AshwinVishwanath/C.A.S.P.E.R.-2/Matlab Code/plots/allan_adxl372.png

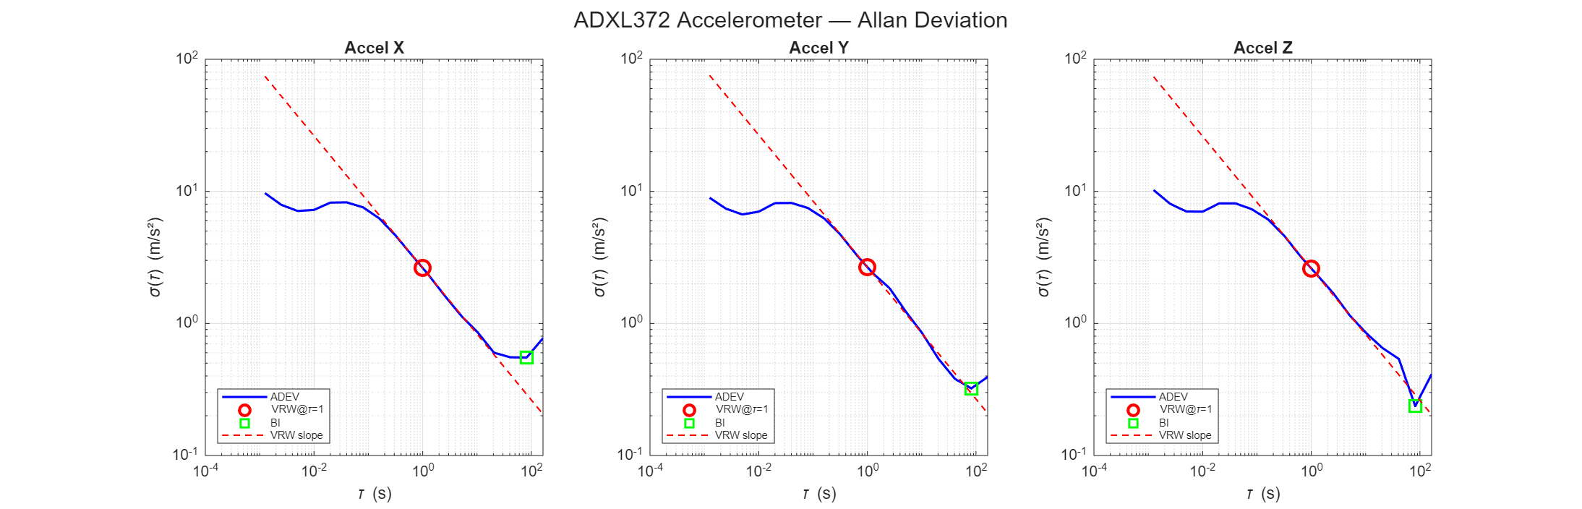
Matlab Code/plots/allan_adxl372.png
