AshwinVishwanath/C.A.S.P.E.R.-2/Matlab Code/plots/allan_lsm6_gyro.png

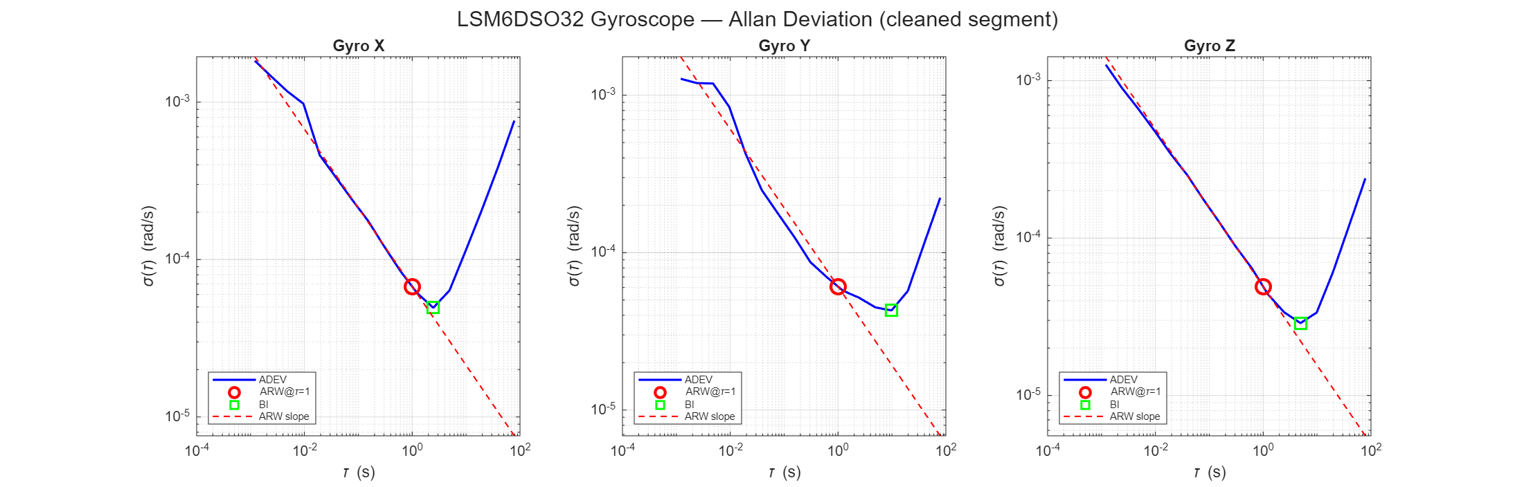
Matlab Code/plots/allan_lsm6_gyro.png
