AshwinVishwanath/C.A.S.P.E.R.-2/Matlab Code/plots/baro_allan_dev.png

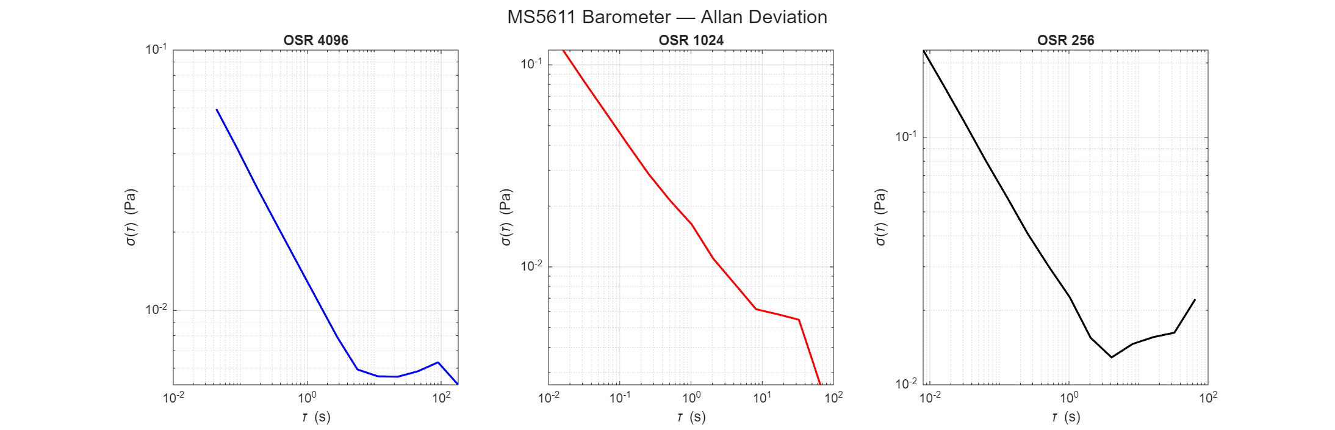
Matlab Code/plots/baro_allan_dev.png
