AshwinVishwanath/C.A.S.P.E.R.-2/Matlab Code/plots/baro_allan_overlay.png

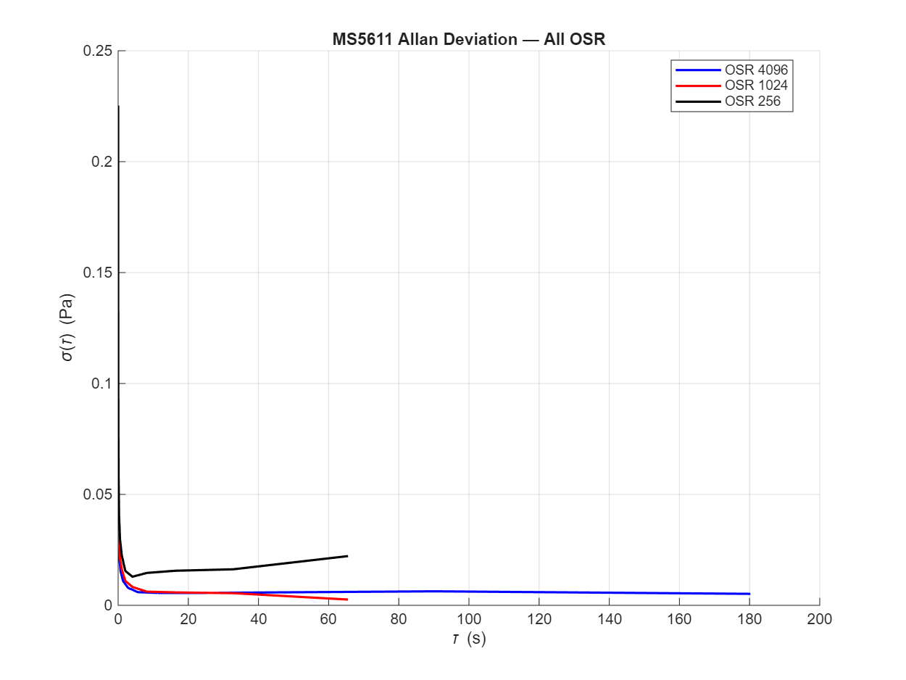
Matlab Code/plots/baro_allan_overlay.png
