AshwinVishwanath/C.A.S.P.E.R.-2/Matlab Code/plots/baro_psd.png

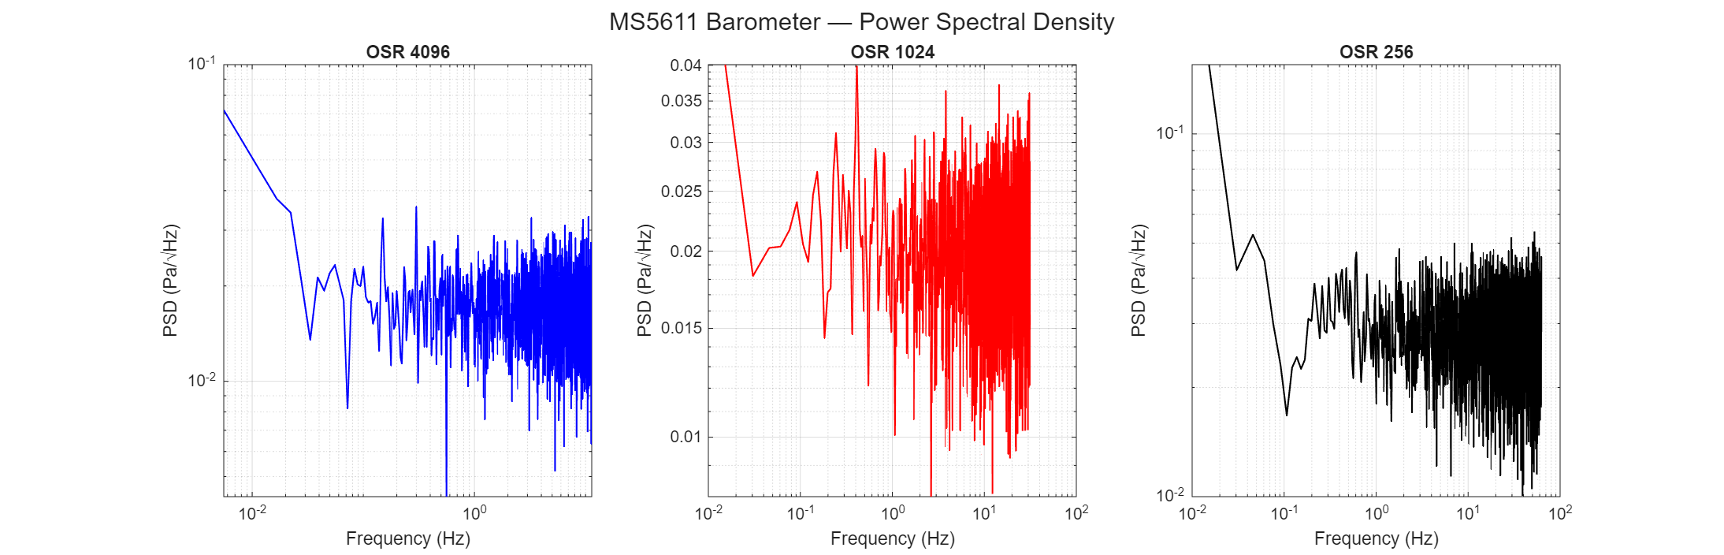
Matlab Code/plots/baro_psd.png
