AshwinVishwanath/C.A.S.P.E.R.-2/Matlab Code/plots/qc_noise_histograms.png

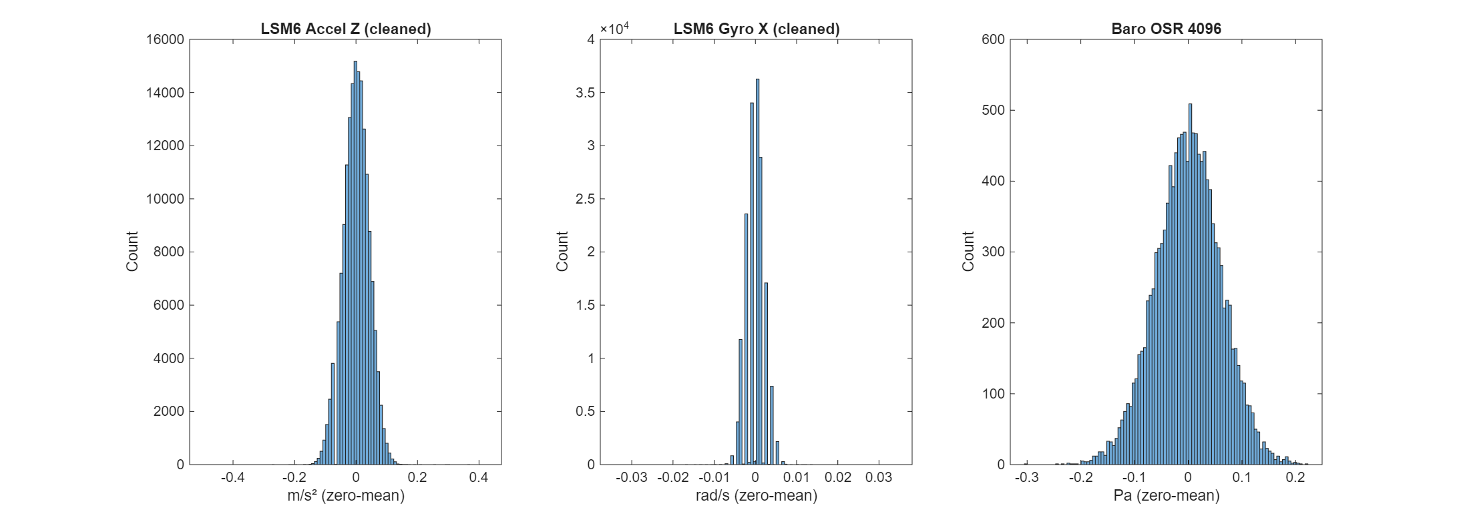
Matlab Code/plots/qc_noise_histograms.png
