AshwinVishwanath/C.A.S.P.E.R.-2/Matlab Code/plots/qc_raw_baro.png

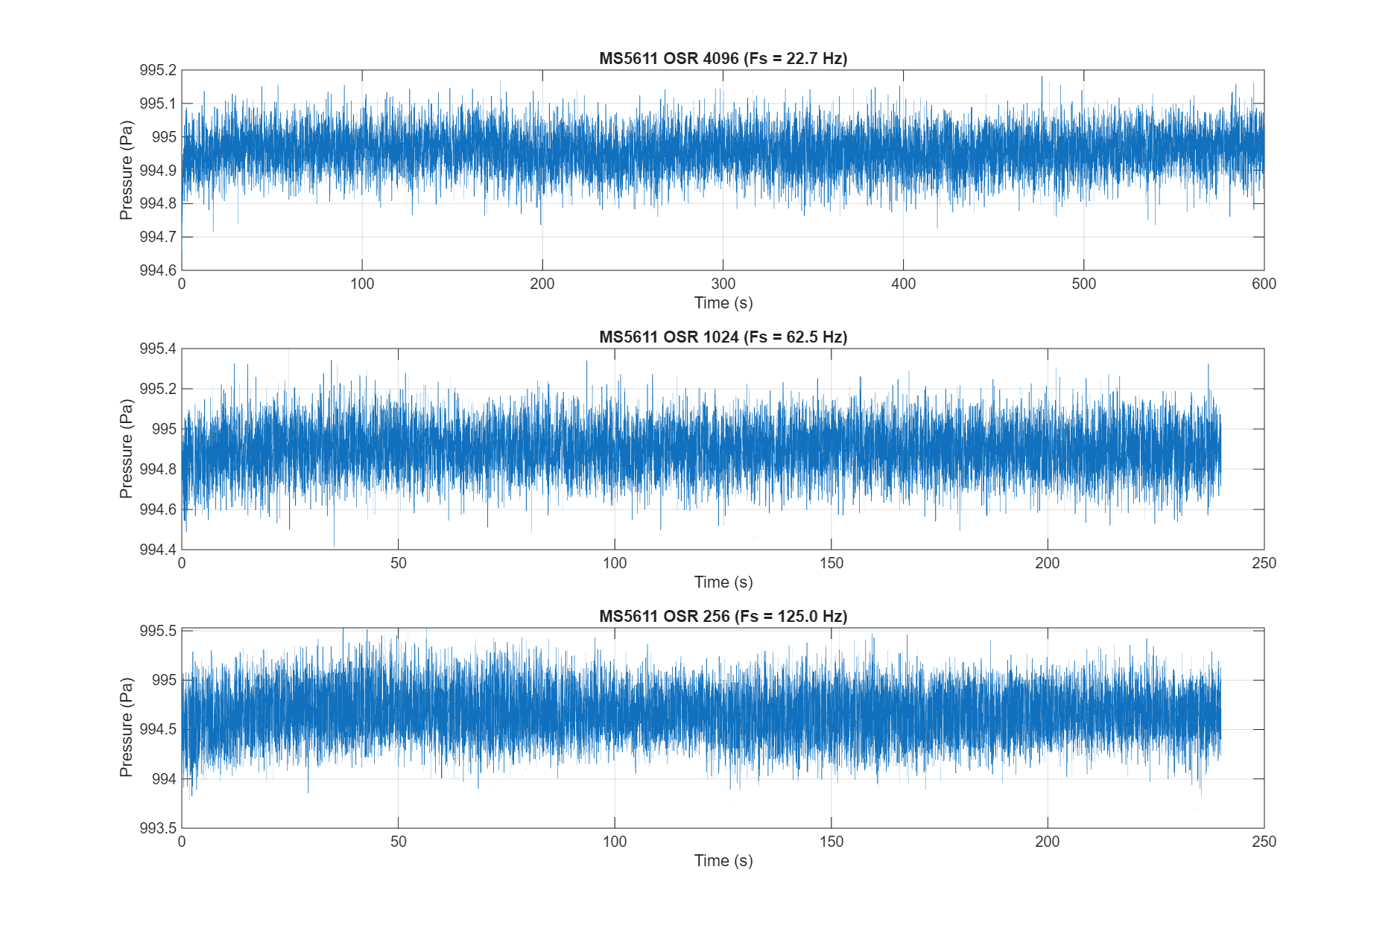
Matlab Code/plots/qc_raw_baro.png
