AshwinVishwanath/C.A.S.P.E.R.-2/Matlab Code/plots/qc_raw_imu.png

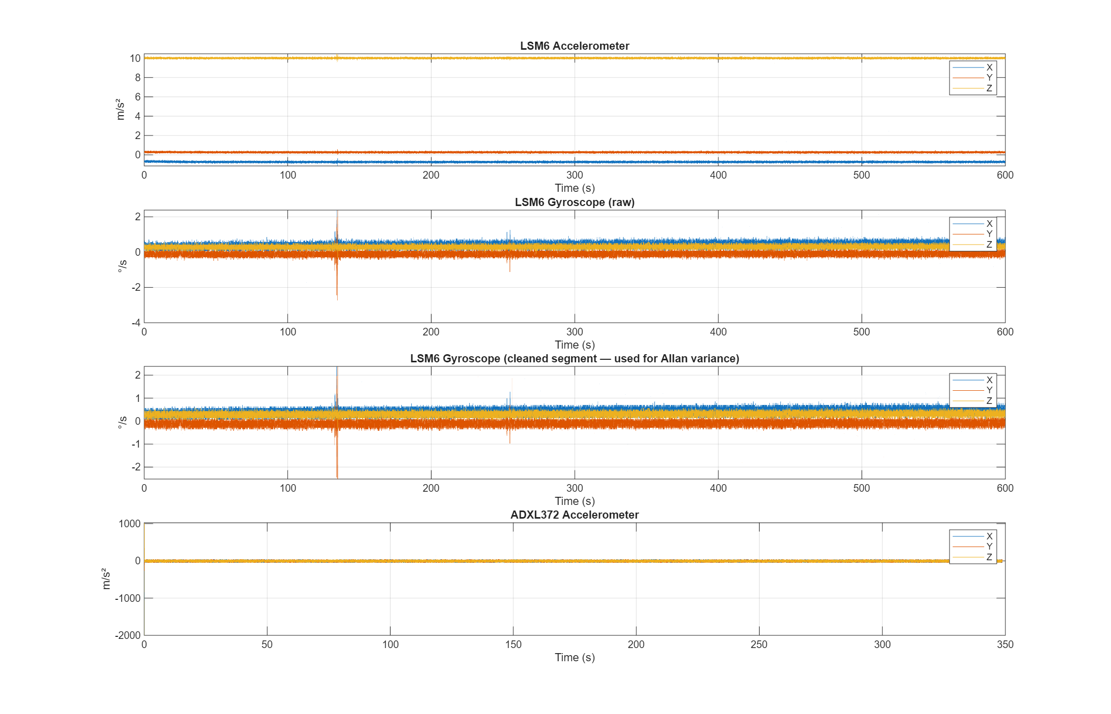
Matlab Code/plots/qc_raw_imu.png
