AshwinVishwanath/C.A.S.P.E.R.-2/Matlab Code/plots/qc_sample_timing.png

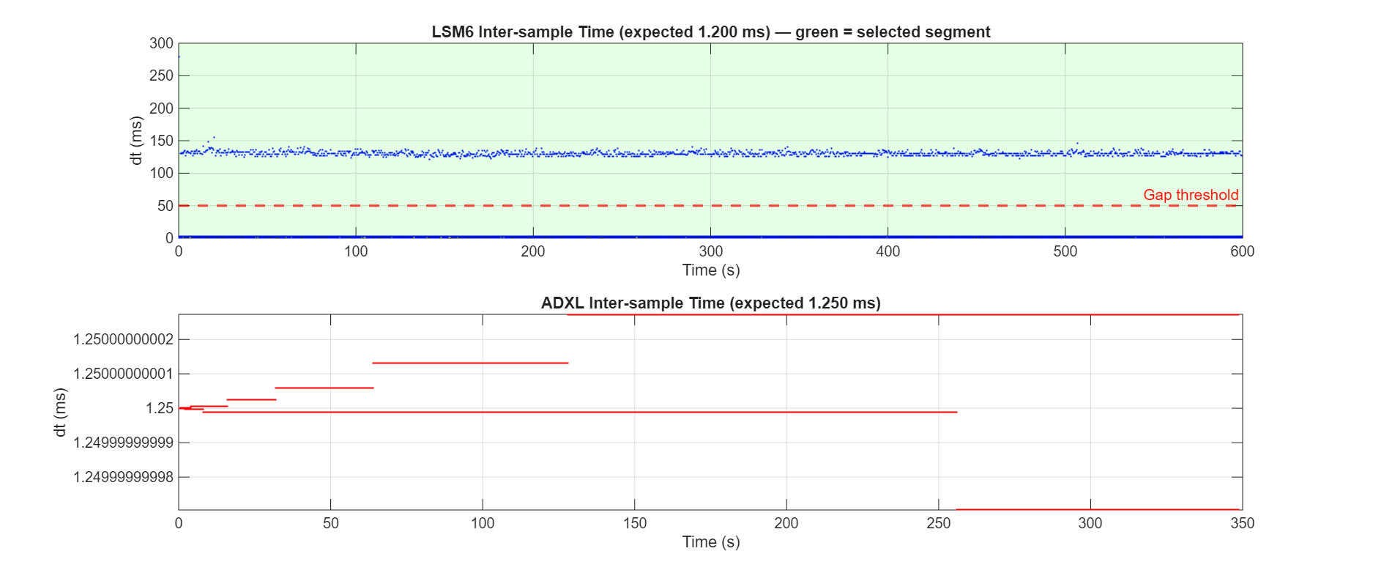
Matlab Code/plots/qc_sample_timing.png
