AshwinVishwanath/C.A.S.P.E.R.-2/Hardware/C.A.S.P.E.R. 2 Schematics.PDF

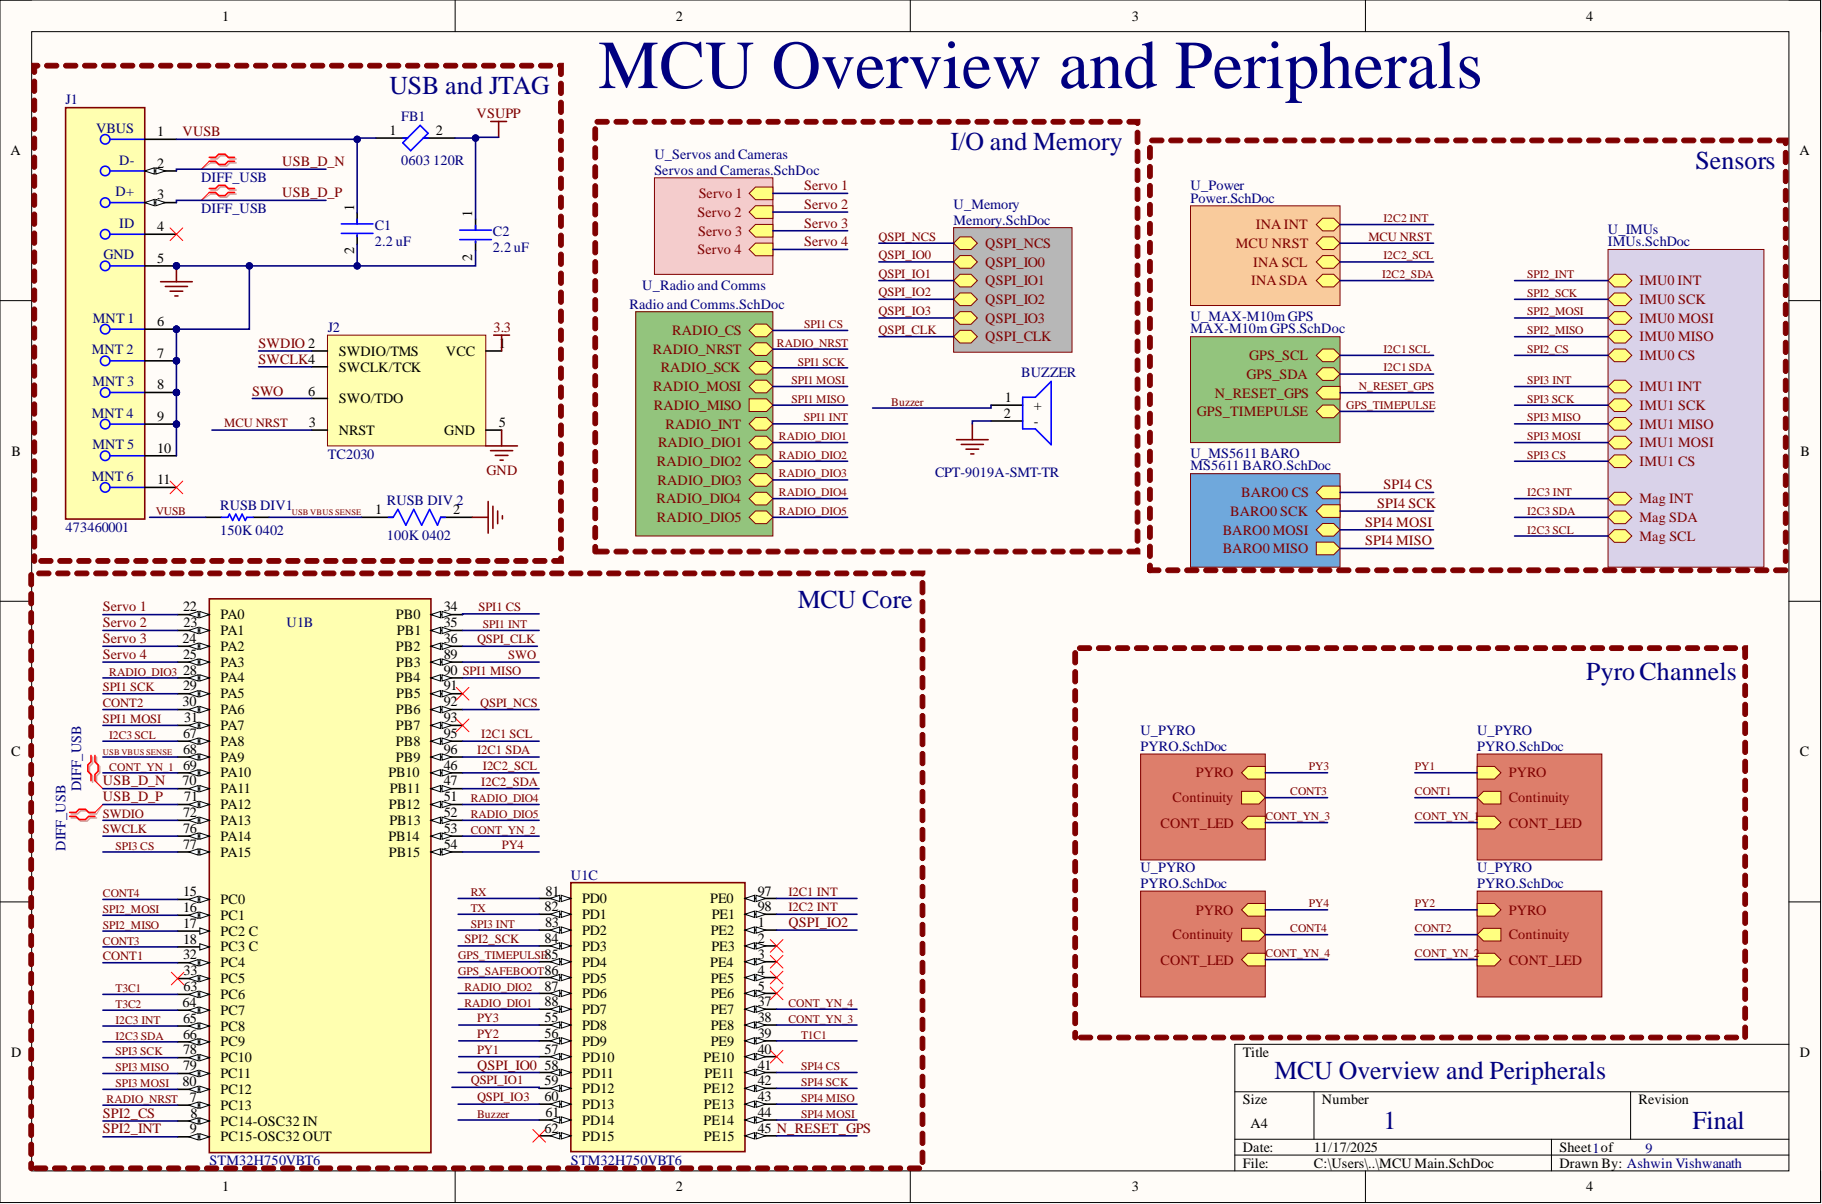
[picture p17: page 1]

MCU Overview and Peripherals

U_Servos and Cameras
Servos and Cameras.SchDoc

U_Radio and Comms
Radio and Comms.SchDoc

U_MAX-M10m GPS MAX-M10m GPS.SchDoc

Title

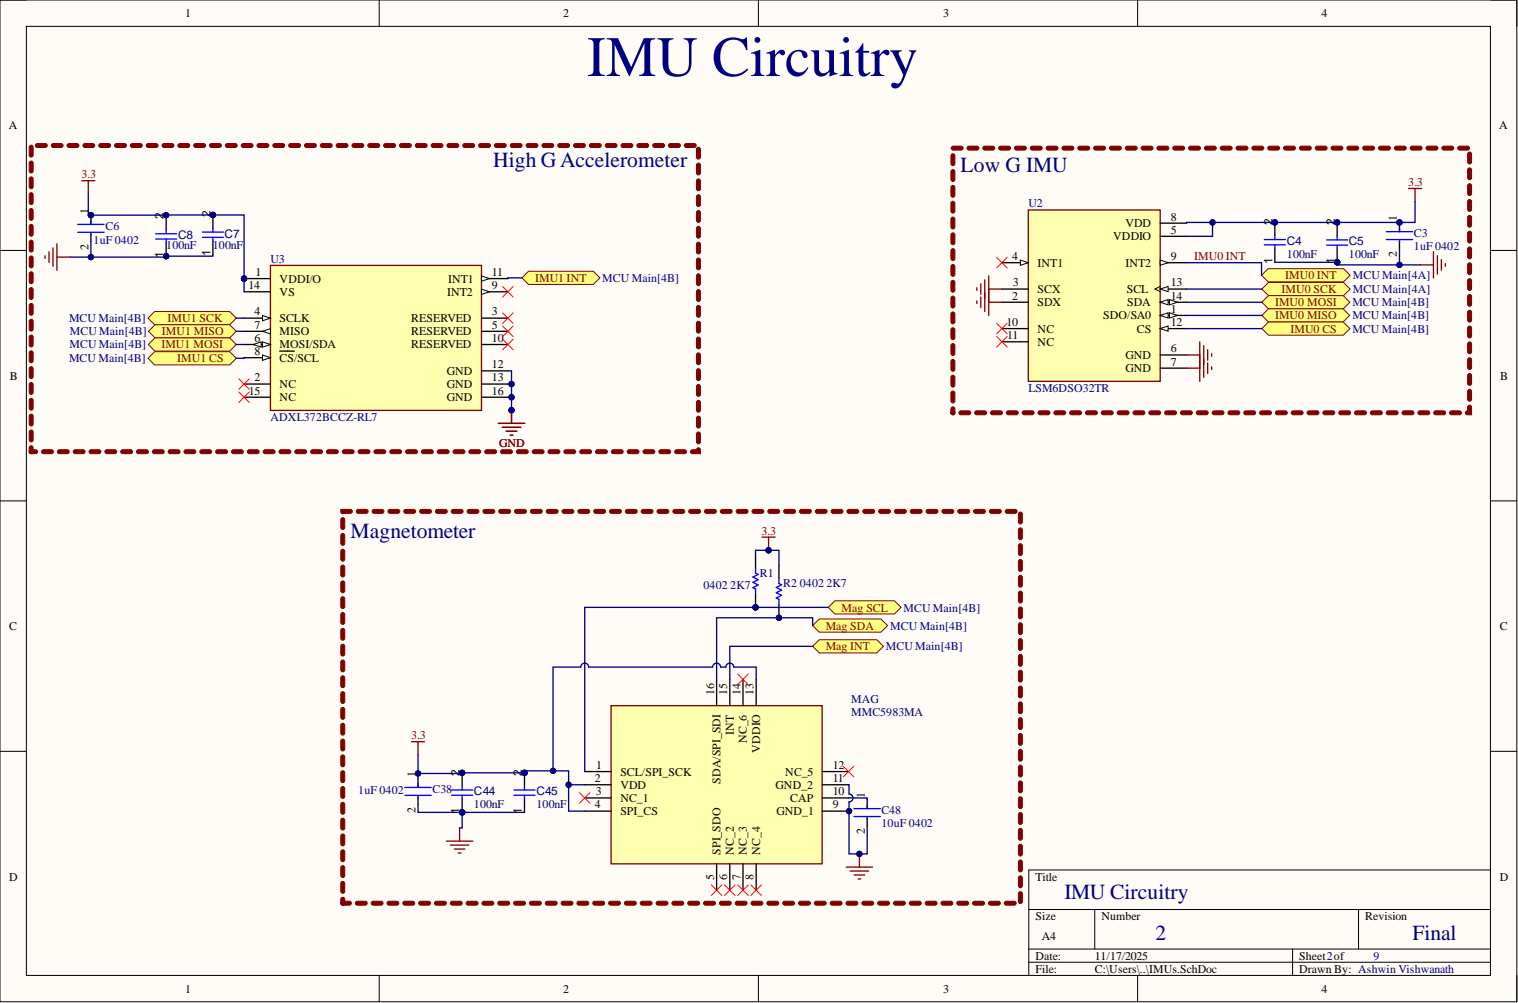
[picture p18: page 2]

SCL/SPI_SCK 1

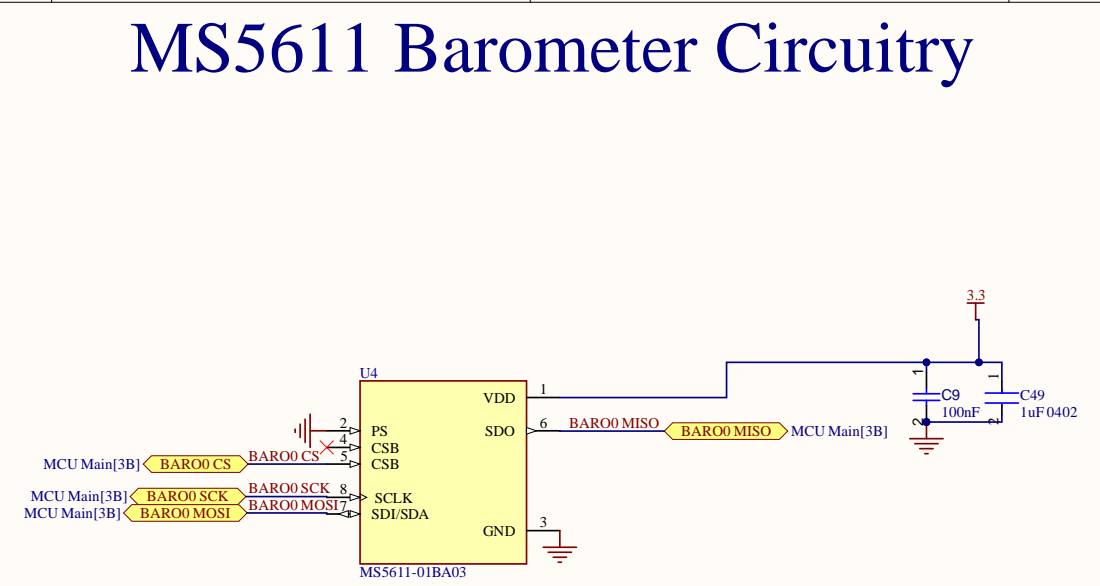
[picture p19: page 3]

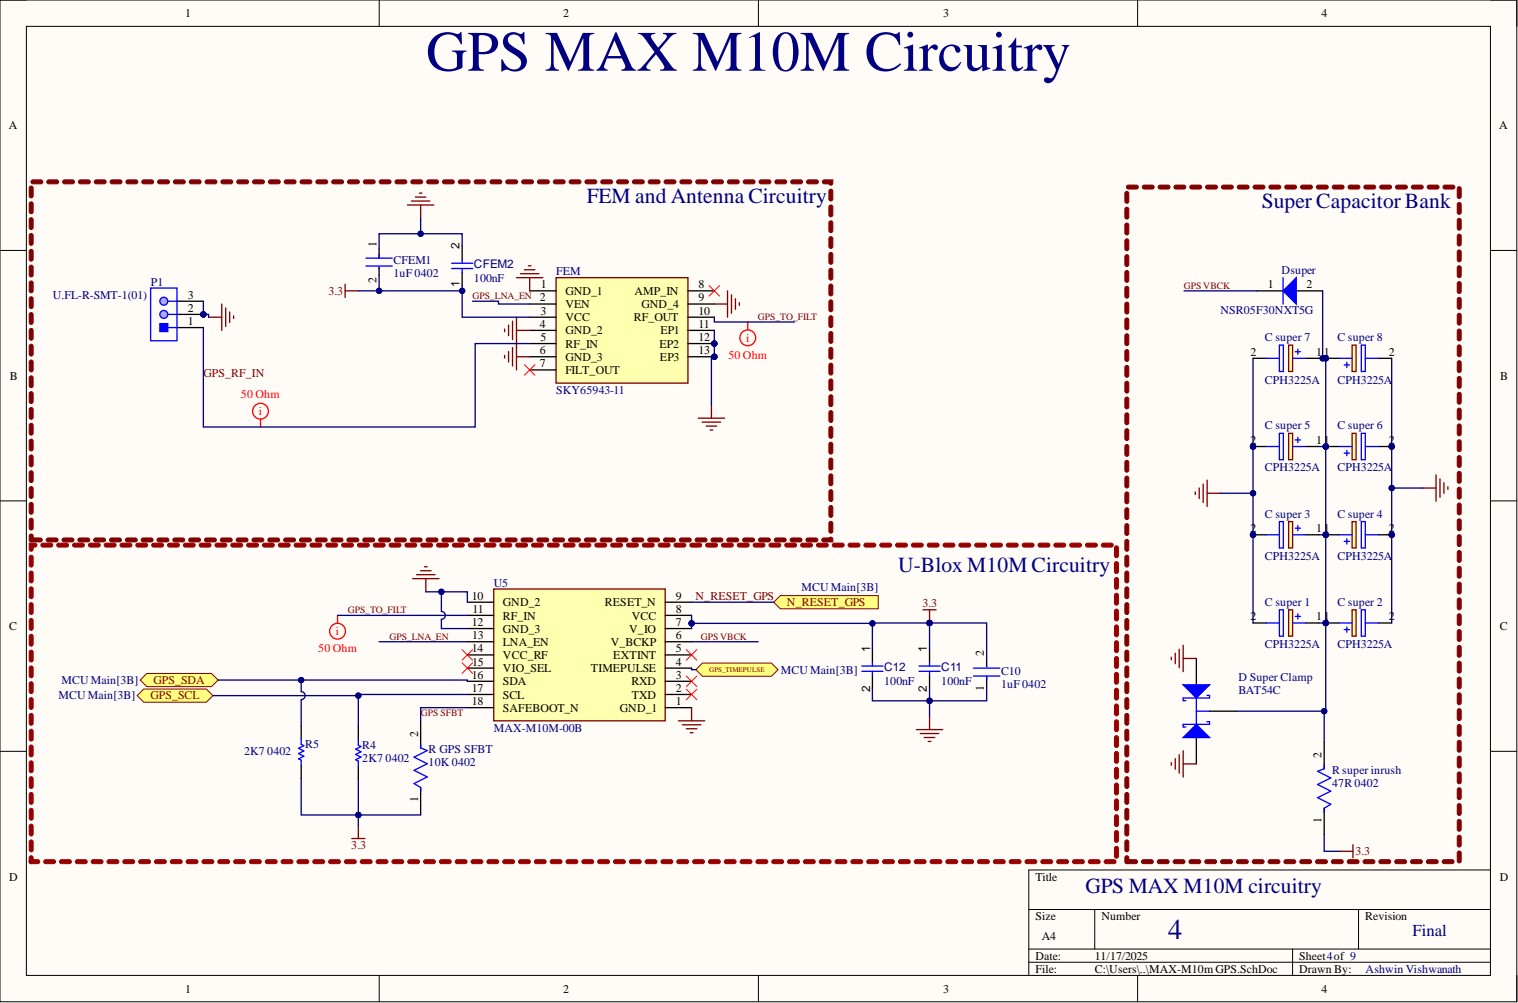
[picture p20: page 4]

FEM and Antenna Circuitry

GPS SFBT

SAFEBOOT_N 18

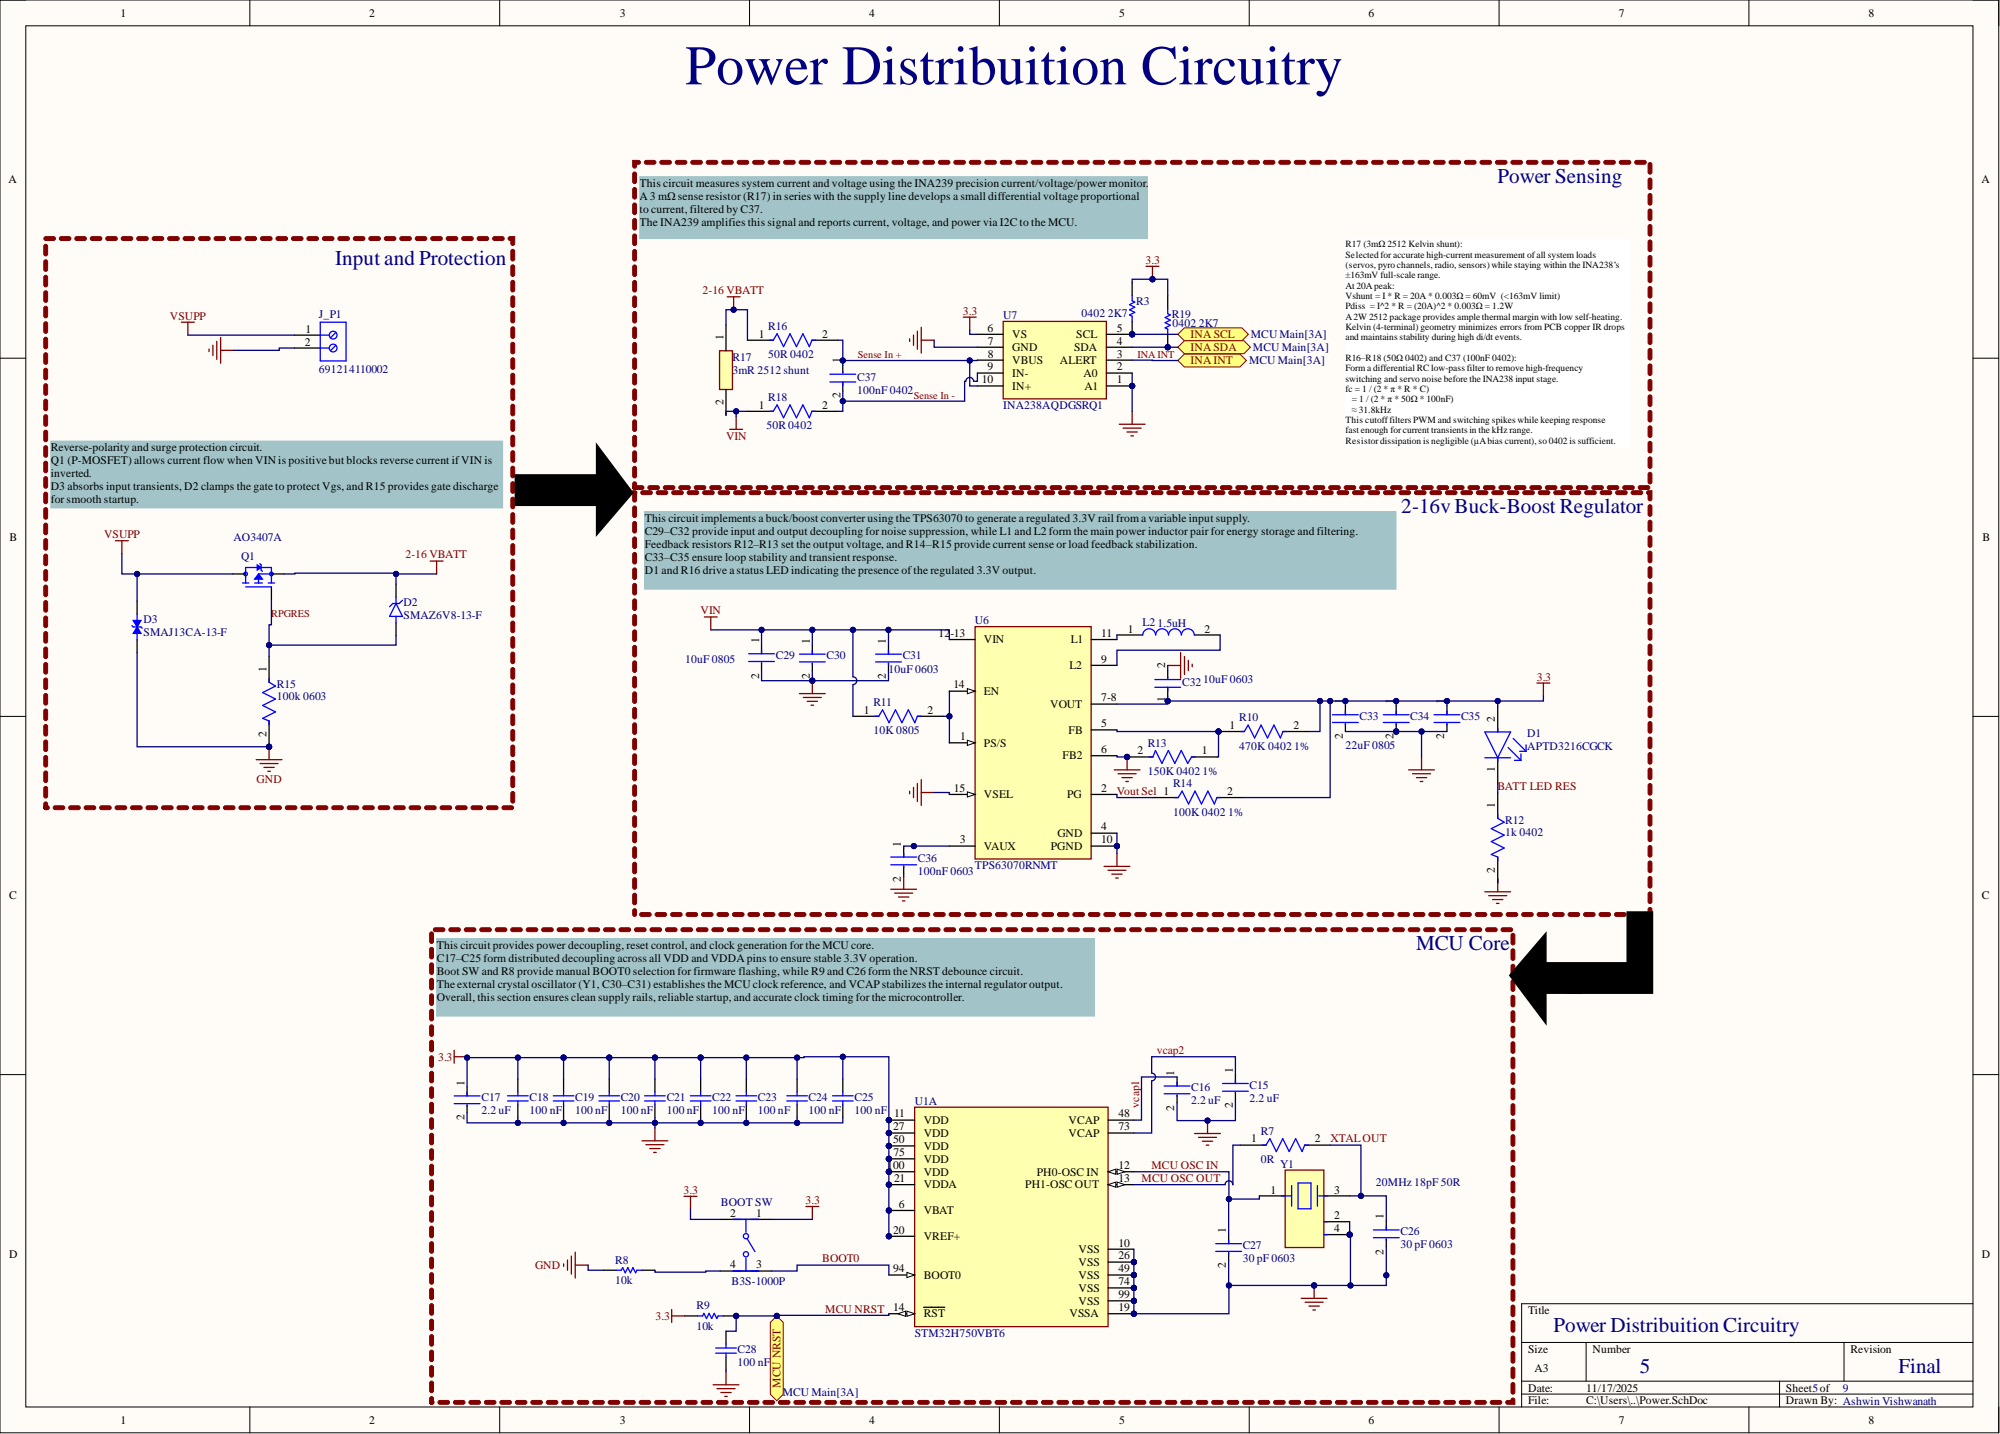
[picture p21: page 5]

This circuit measuressystem current and voltage using the INA239 precision current/voltage/power monitor.
A 3 mΩ sense resistor (R17) in series with the supply line develops a small differential voltage proportional
to current, filtered by C37.
The INA239 amplifies this signal and reports current, voltage, and power via I2C to the MCU.

R17 (3mΩ 2512 Kelvin shunt):
Selected for accurate high-current measurement of all system loads
(servos, pyro channels, radio,sensors) while staying within the INA238’s
±163mV full-scale range.
At 20A peak:
Vshunt = I * R = 20A * 0.003Ω = 60mV (<163mV limit)
Pdiss = I^2 * R = (20A)^2 * 0.003Ω = 1.2W
A2W 2512 package provides ample thermal margin with low self-heating.
Kelvin (4-terminal) geometry minimizes errors from PCB copper IR drops
and maintainsstability during high di/dt events.

R16–R18 (50Ω 0402) and C37 (100nF 0402):
Form a differential RC low-pass filter to remove high-frequency
switching and servo noise before the INA238 input stage.
≈ 31.8kHz
This cutoff filters PWM and switching spikes while keeping response
fast enough for current transientsin the kHz range.
Resistor dissipation is negligible (µAbias current), so 0402 issufficient.

Reverse-polarity and surge protection circuit.
Q1 (P-MOSFET) allows current flow when VIN is positive but blocks reverse current if VIN is
inverted.
D3 absorbs input transients, D2 clamps the gate to protect Vgs, and R15 provides gate discharge
for smooth startup.

This circuit implements a buck/boost converter using the TPS63070 to generate a regulated 3.3V rail from a variable input supply.
C29–C32 provide input and output decoupling for noise suppression, while L1 and L2 form the main power inductor pair for energy storage and filtering.
Feedback resistors R12–R13 set the output voltage, and R14–R15 provide current sense or load feedback stabilization.
C33–C35 ensure loop stability and transient response.
D1 and R16 drive a status LED indicating the presence of the regulated 3.3V output.

This circuit provides power decoupling, reset control, and clock generation for the MCU core.
C17–C25 form distributed decoupling across all VDD and VDDA pins to ensure stable 3.3V operation.
Boot SW and R8 provide manual BOOT0 selection for firmware flashing, while R9 and C26 form the NRST debounce circuit.
The external crystal oscillator (Y1, C30–C31) establishes the MCU clock reference, and VCAP stabilizesthe internal regulator output.
Overall, this section ensures clean supply rails, reliable startup, and accurate clock timing for the microcontroller.

MCU NRST MCU Main[3A]

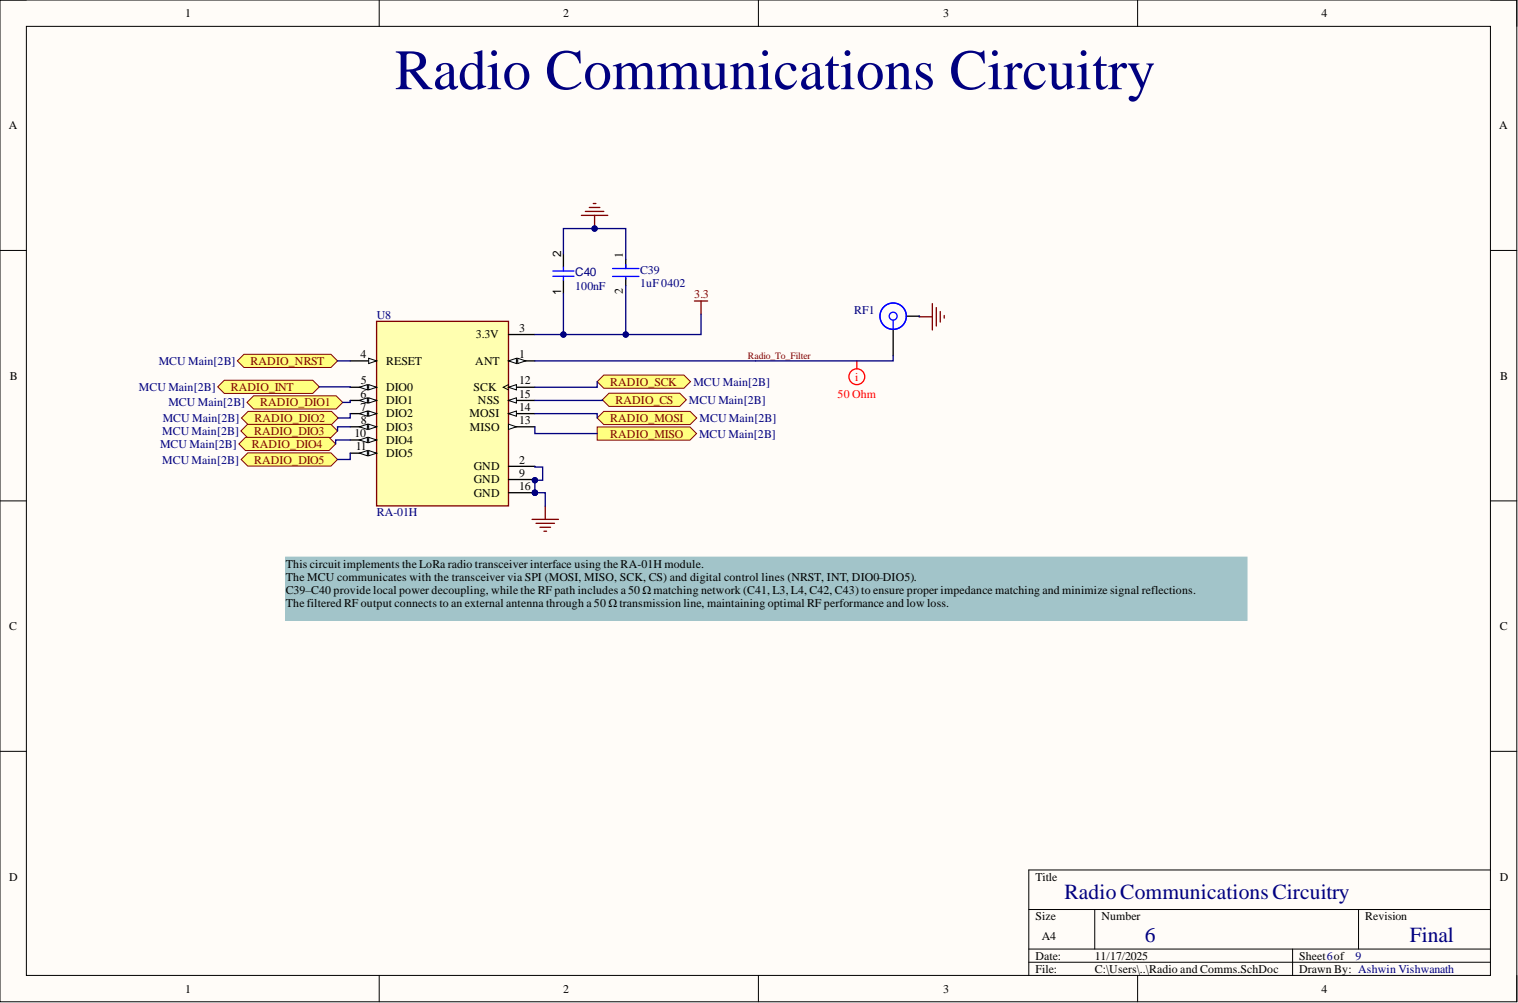
[picture p22: page 6]

ver
ia SPI (MOSI, MISO, SCK, CS) an

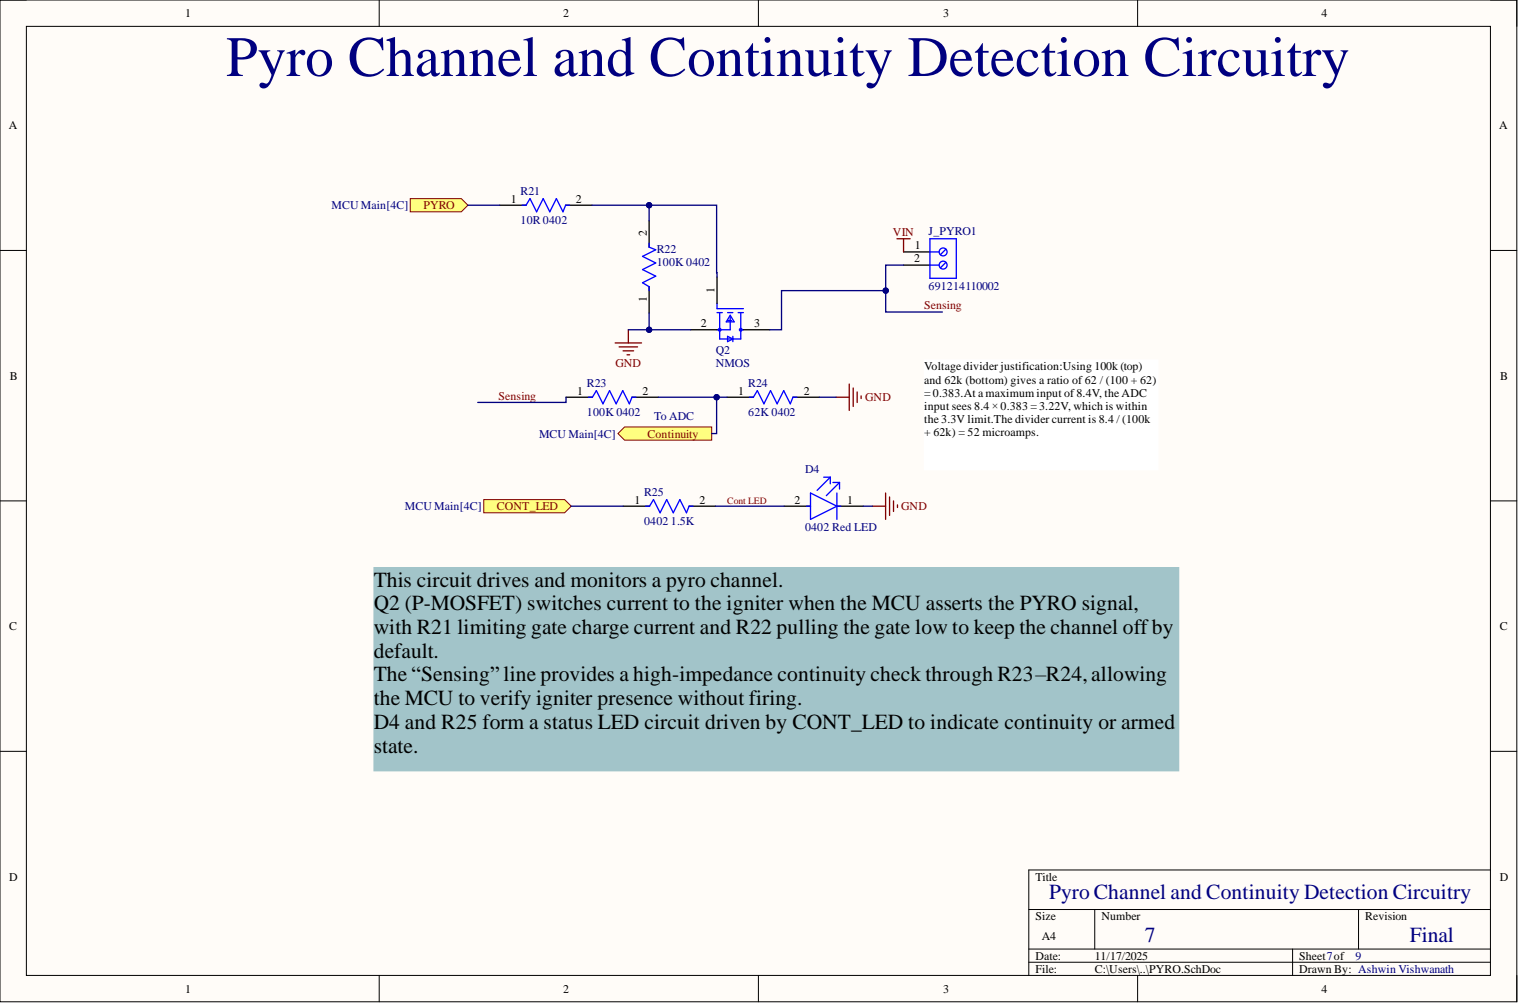
[picture p23: page 7]

Pyro Channel and Continuity Detection Circuitry

Voltage divider justification:Using 100k (top)
and 62k (bottom) gives a ratio of 62 / (100 + 62)
= 0.383.At a maximum input of 8.4V, the ADC
input sees 8.4 × 0.383 = 3.22V, which is within
the 3.3V limit.The divider current is 8.4 / (100k
+ 62k) = 52 microamps.

This circuit drives and monitors a pyro channel.
Q2 (P-MOSFET) switches current to the igniter when the MCU asserts the PYRO signal,
with R21 limiting gate charge current and R22 pulling the gate low to keep the channel off by
default.
The “Sensing” line provides a high-impedance continuity check through R23–R24, allowing
the MCU to verify igniter presence without firing.
D4 and R25 form a status LED circuit driven by CONT_LED to indicate continuity or armed
state.

Title

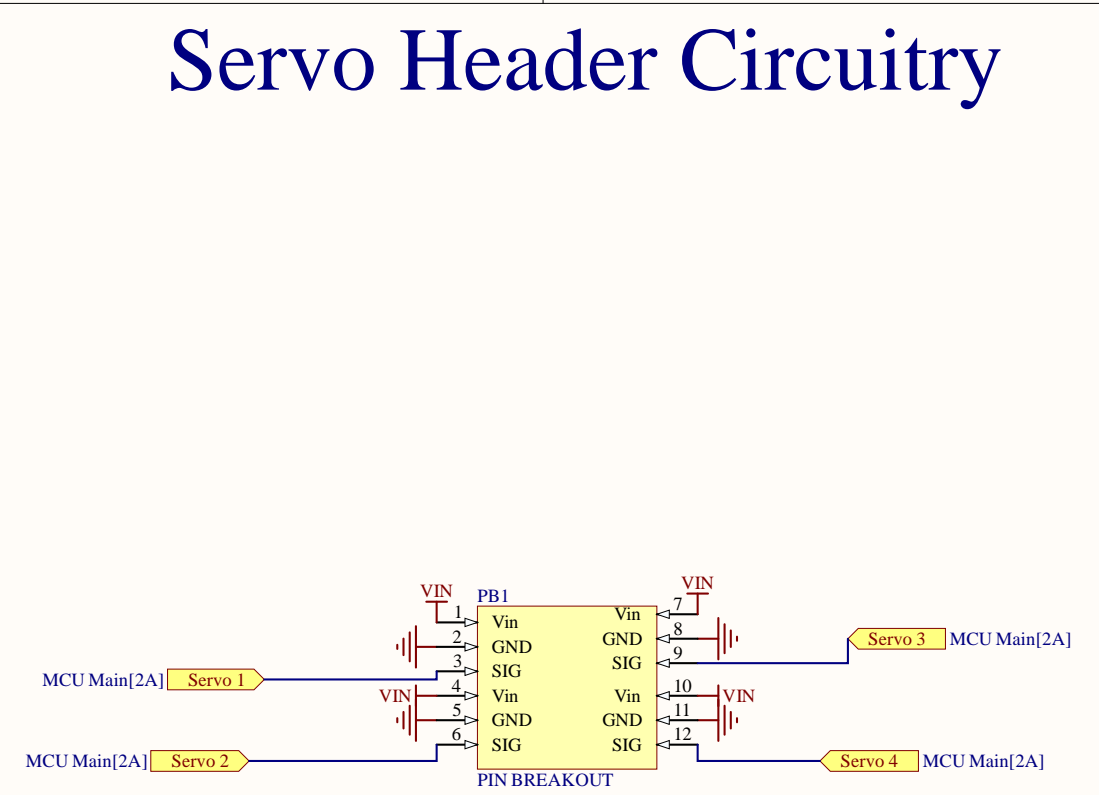
[picture p24: page 8]

5 | 1 1
6 | 1 2

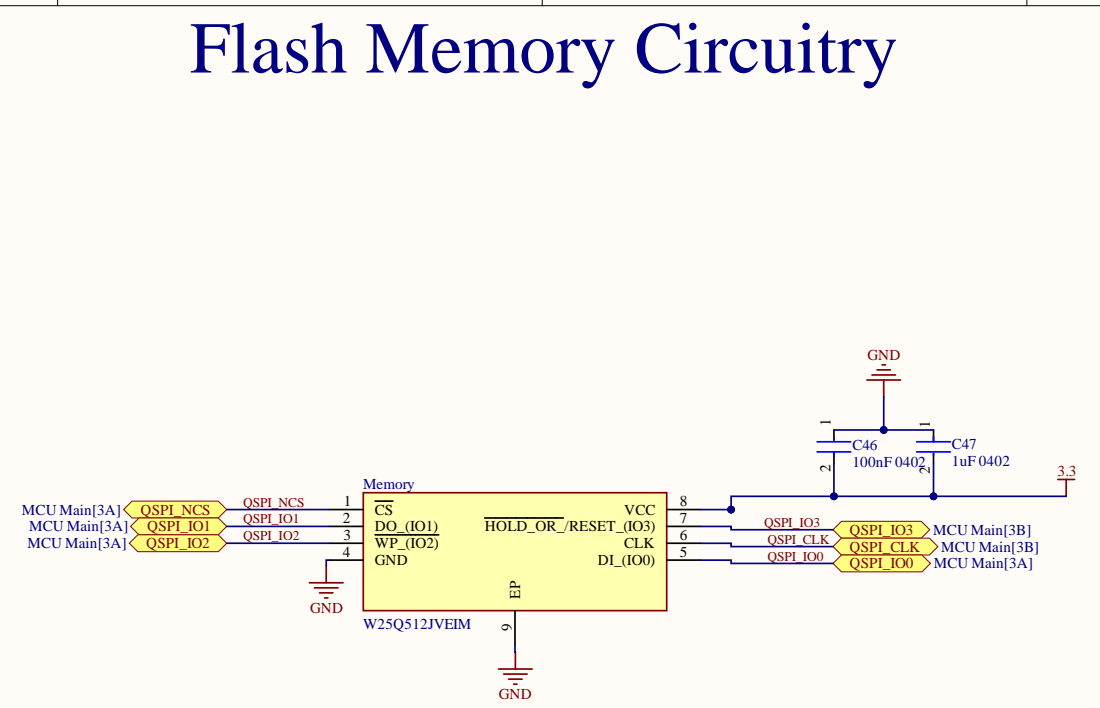
[picture p25: page 9]
