AshwinVishwanath/C.A.S.P.E.R.-2/Hardware/C.A.S.P.E.R. 2 PCB Prints.PDF

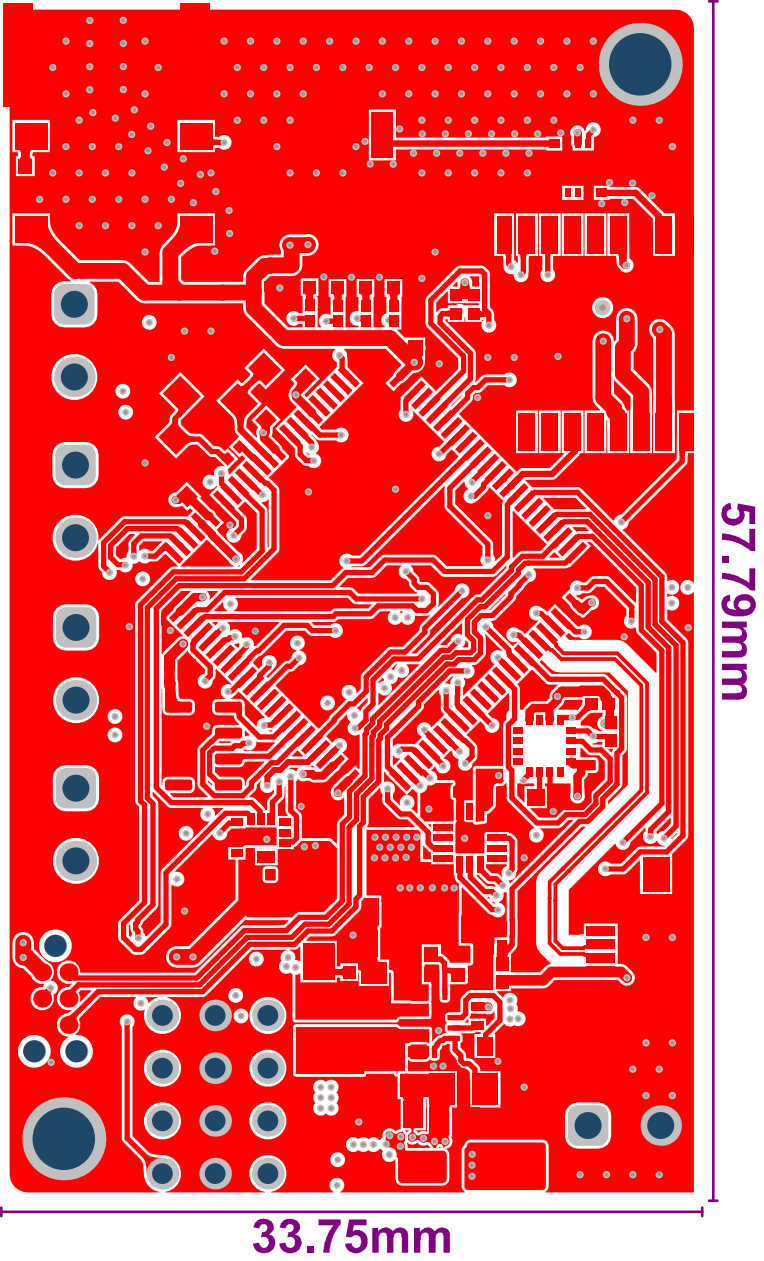
[picture p26: page 1]

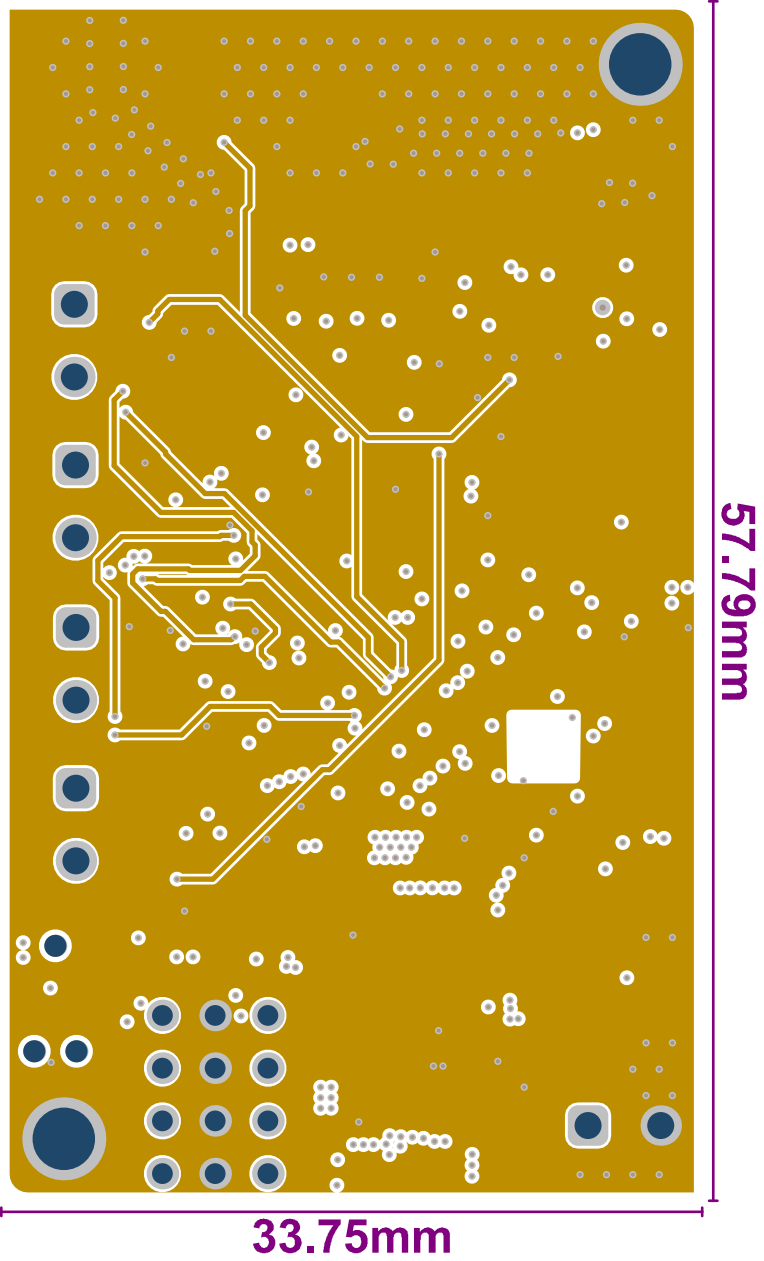
[picture p27: page 2]

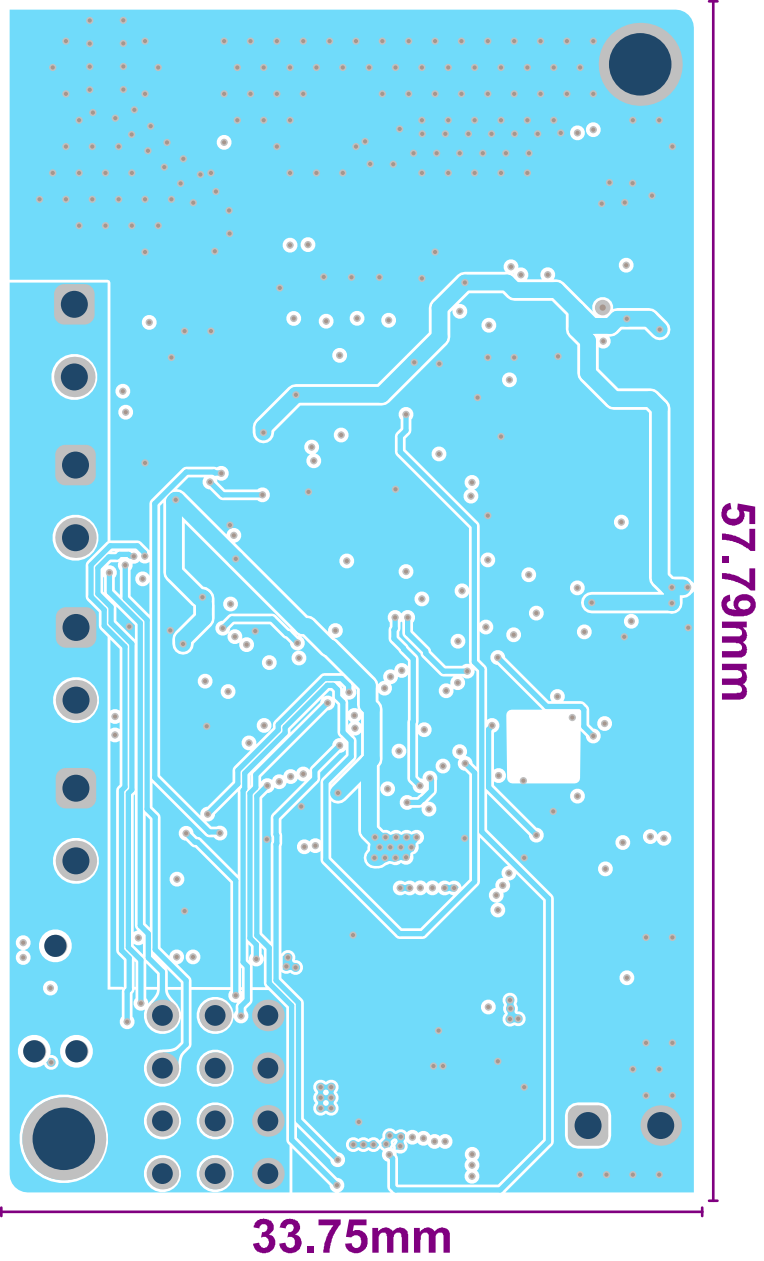
[picture p28: page 3]

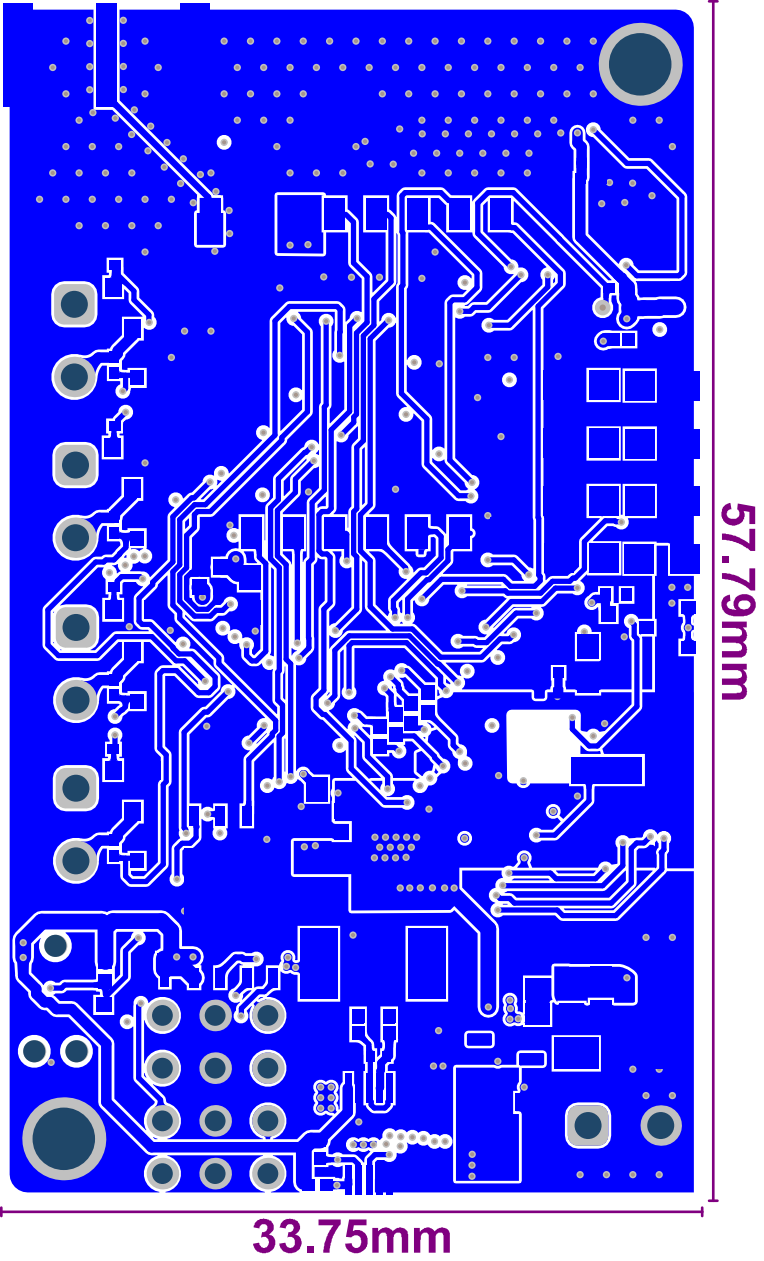
[picture p29: page 4]
