AshwinVishwanath/C.A.S.P.E.R.-2/Software/Core/Src/main.c

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
/* Includes ------------------------------------------------------------------*/
#include "main.h"
#include "fatfs.h"
#include "usb_device.h"

/* USER CODE BEGIN Includes */
#include <string.h>
#include <stdio.h>
#include <stdbool.h>
#if (USB_MODE != 2)
#include "usbd_cdc_if.h"
#endif
#include "ms5611.h"
#ifndef BUILD_TARGET_GROUND
#include "lsm6dso32.h"
#include "adxl372.h"
#include "w25q512jv.h"
#include "casper_ekf.h"
#include "casper_attitude.h"
#include "casper_quat.h"
#endif /* !BUILD_TARGET_GROUND */
#include "max_m10m.h"
#ifndef BUILD_TARGET_GROUND
#include "mmc5983ma.h"
#include "mag_cal.h"
#ifdef MAG_VAL
#include "mag_val.h"
#endif
#ifdef GYRO_TEMP_CAL
#include "temp_cal.h"
#endif
/* ── MC Testing / Telemetry modules ── */
#include "tlm_manager.h"
#include "cmd_router.h"
#include "cac_handler.h"
#include "cfg_manager.h"
#include "flight_fsm.h"
#include "pyro_manager.h"
#include "self_test.h"
#include "flight_loop.h"
#include "radio_manager.h"
#include "flight_logger.h"
#ifdef LOGGER_SANITY
#include "logger_sanity.h"
#include "cycle_probe.h"
#endif
#endif /* !BUILD_TARGET_GROUND */
#include "crc32_hw.h"
#include "radio_irq.h"
#include "buzzer.h"
#ifdef BUILD_TARGET_GROUND
#include "ground_main.h"
#endif
/* USER CODE END Includes */

/* USER CODE BEGIN PD */
#if defined(MAG_CAL) + defined(MAG_VAL) + defined(GYRO_TEMP_CAL) + defined(GPS_TEST) > 1
#error "Only one calibration/test mode may be defined at a time"
#endif

/* USER CODE END PD */

ADC_HandleTypeDef hadc1;
ADC_HandleTypeDef hadc2;
ADC_HandleTypeDef hadc3;

CRC_HandleTypeDef hcrc;

I2C_HandleTypeDef hi2c1;
I2C_HandleTypeDef hi2c2;
I2C_HandleTypeDef hi2c3;

QSPI_HandleTypeDef hqspi;

SPI_HandleTypeDef hspi1;
SPI_HandleTypeDef hspi2;
SPI_HandleTypeDef hspi3;
SPI_HandleTypeDef hspi4;

TIM_HandleTypeDef htim2;
TIM_HandleTypeDef htim4;

/* USER CODE BEGIN PV */
IWDG_HandleTypeDef hiwdg1;
ms5611_t baro;
#ifndef BUILD_TARGET_GROUND
lsm6dso32_t imu;
adxl372_t high_g;
w25q512jv_t flash;
casper_ekf_t ekf;
casper_attitude_t att;
#endif
max_m10m_t gps;
#ifndef BUILD_TARGET_GROUND
mmc5983ma_t mag;
flight_logger_t logger;
#endif
/* USER CODE END PV */

void SystemClock_Config(void);
void PeriphCommonClock_Config(void);
static void MPU_Config(void);
static void MX_GPIO_Init(void);
static void MX_ADC1_Init(void);
static void MX_ADC2_Init(void);
static void MX_ADC3_Init(void);
static void MX_I2C1_Init(void);
static void MX_I2C2_Init(void);
static void MX_QUADSPI_Init(void);
static void MX_SPI1_Init(void);
static void MX_SPI2_Init(void);
static void MX_SPI4_Init(void);
static void MX_TIM2_Init(void);
static void MX_CRC_Init(void);
static void MX_TIM4_Init(void);
static void MX_I2C3_Init(void);
static void MX_SPI3_Init(void);
/* USER CODE BEGIN PFP */
static void MX_IWDG1_Init(void);
/* USER CODE END PFP */

/* USER CODE BEGIN 0 */
static void MX_IWDG1_Init(void)
{
    /* LSI ~32 kHz, /4 -> 8 kHz, reload 3999 -> 500ms timeout */
    hiwdg1.Instance  = IWDG1;
    hiwdg1.Prescaler = 0;     /* PR=0 -> /4 */
    hiwdg1.Reload    = 3999;
    HAL_IWDG_Init(&hiwdg1);
}
/* USER CODE END 0 */

/**
  * @brief  The application entry point.
  * @retval int
  */
int main(void)
{

  /* MPU Configuration--------------------------------------------------------*/
  MPU_Config();

  /* MCU Configuration--------------------------------------------------------*/

  /* Reset of all peripherals, Initializes the Flash interface and the Systick. */
  HAL_Init();

  /* USER CODE BEGIN Init */
  // Enable GPIO clocks for all 4 LEDs
  RCC->AHB4ENR |= RCC_AHB4ENR_GPIOAEN | RCC_AHB4ENR_GPIOBEN | RCC_AHB4ENR_GPIOEEN;
  (void)RCC->AHB4ENR;

  // Configure all 4 LED pins as GP output (MODER = 01)
  GPIOA->MODER = (GPIOA->MODER & ~(3UL << (10*2))) | (1UL << (10*2)); // PA10
  GPIOB->MODER = (GPIOB->MODER & ~(3UL << (14*2))) | (1UL << (14*2)); // PB14
  GPIOE->MODER = (GPIOE->MODER & ~(3UL << (8*2)))  | (1UL << (8*2));  // PE8
  GPIOE->MODER = (GPIOE->MODER & ~(3UL << (7*2)))  | (1UL << (7*2));  // PE7

  // Milestone 1: HAL_Init passed
  GPIOA->BSRR = (1UL << 10);  // LED1 ON
  HAL_Delay(500);
  /* USER CODE END Init */

  /* Configure the system clock */
  SystemClock_Config();

  /* Configure the peripherals common clocks */
  PeriphCommonClock_Config();

  /* USER CODE BEGIN SysInit */
  /* Enable the Cortex-M7 DWT free-running cycle counter (DWT->CYCCNT).
   * Used by:
   *   - flight_loop.c adaptive-dt: actual elapsed time per IMU sample,
   *     fed to attitude estimator and EKF predict instead of a fixed
   *     EKF_DT constant. Critical for estimator correctness.
   *   - LOGGER_SANITY cycle probes (when enabled) — performance
   *     measurement of the hot paths.
   * Cost: zero — DWT runs from SYSCLK with no software intervention. */
  CoreDebug->DEMCR |= CoreDebug_DEMCR_TRCENA_Msk;
  DWT->LAR    = 0xC5ACCE55u;            /* H7 lock register magic */
  DWT->CYCCNT = 0;
  DWT->CTRL  |= DWT_CTRL_CYCCNTENA_Msk;
  /* USER CODE END SysInit */

  /* Initialize all configured peripherals */
  MX_GPIO_Init();
  MX_ADC1_Init();
  MX_ADC2_Init();
  MX_ADC3_Init();
  MX_I2C1_Init();
#ifndef BUILD_TARGET_GROUND
  MX_I2C2_Init();
  MX_QUADSPI_Init();
#endif
  MX_SPI1_Init();
#ifndef BUILD_TARGET_GROUND
  MX_SPI2_Init();
#endif
  MX_SPI4_Init();
  MX_TIM2_Init();
  MX_CRC_Init();
  MX_TIM4_Init();
#ifndef BUILD_TARGET_GROUND
  MX_I2C3_Init();
  MX_SPI3_Init();

  // Init flash BEFORE USB so MSC storage callbacks can respond during enumeration
  w25q512jv_init(&flash, &hqspi);
#endif

  MX_USB_DEVICE_Init();
#ifndef BUILD_TARGET_GROUND
  MX_FATFS_Init();
#endif
  /* USER CODE BEGIN 2 */

  /* ── 5-second USB enumeration window ──
   * Wait here so the user can open a serial terminal before any
   * sensor init runs.  All CDC debug prints after this point will
   * be visible. */
  HAL_Delay(5000);

#ifdef BUILD_TARGET_GROUND
  /* ── Ground station init ──────────────────────────────────────── */
  {
    char _dbg[80]; int _len;
    #define DBG_PRINT(msg) do { \
      _len = snprintf(_dbg, sizeof(_dbg), msg); \
      CDC_Transmit_FS((uint8_t *)_dbg, (uint16_t)_len); \
      HAL_Delay(20); \
    } while(0)

    DBG_PRINT("[INIT] Ground station mode\r\n");
    DBG_PRINT("[INIT] MS5611...\r\n");
    if (!ms5611_init(&baro, &hspi4, SPI4_CS_GPIO_Port, SPI4_CS_Pin)) {
      for (int i = 0; i < 6; i++) {
        HAL_GPIO_TogglePin(CONT_YN_3_GPIO_Port, CONT_YN_3_Pin);
        HAL_GPIO_TogglePin(CONT_YN_4_GPIO_Port, CONT_YN_4_Pin);
        HAL_Delay(200);
      }
    }
    ms5611_set_oversampling(&baro, MS5611_OSR_2048);

    DBG_PRINT("[INIT] GPS...\r\n");
    if (!max_m10m_init(&gps, &hi2c1, NRST_GPS_GPIO_Port, NRST_GPS_Pin)) {
      for (int i = 0; i < 6; i++) {
        HAL_GPIO_TogglePin(CONT_YN_3_GPIO_Port, CONT_YN_3_Pin);
        HAL_GPIO_TogglePin(CONT_YN_4_GPIO_Port, CONT_YN_4_Pin);
        HAL_Delay(200);
      }
    }

    DBG_PRINT("[INIT] CRC + radio...\r\n");
    crc32_hw_init();
    buzzer_init(&htim4);

    DBG_PRINT("[INIT] ground_main_init...\r\n");
    ground_main_init(&hspi1, &baro, &gps);

    DBG_PRINT("[INIT] Ground station init complete\r\n");
  }

  /* Enable EXTI1 for SX1276 DIO0 (PB1) */
  __HAL_GPIO_EXTI_CLEAR_IT(SPI1_INT_Pin);
  HAL_NVIC_SetPriority(EXTI1_IRQn, 5, 0);
  HAL_NVIC_EnableIRQ(EXTI1_IRQn);

  /* Enable EXTI9_5 for DIO1 (PD7) */
  __HAL_GPIO_EXTI_CLEAR_IT(RADIO_DIO1_Pin);
  HAL_NVIC_SetPriority(EXTI9_5_IRQn, 5, 1);
  HAL_NVIC_EnableIRQ(EXTI9_5_IRQn);

  /* Reset pyro pins to input mode (safety — GS has no pyros) */
  {
    GPIO_InitTypeDef pyro_safe = {0};
    pyro_safe.Pin = PY1_Pin | PY2_Pin | PY3_Pin;
    pyro_safe.Mode = GPIO_MODE_INPUT;
    pyro_safe.Pull = GPIO_PULLDOWN;
    HAL_GPIO_Init(GPIOD, &pyro_safe);

    pyro_safe.Pin = PY4_Pin;
    HAL_GPIO_Init(GPIOB, &pyro_safe);
  }

#else /* FLIGHT build — existing code unchanged */

  {
    char _dbg[80]; int _len;
#if (USB_MODE == 2)
    #define DBG_PRINT(msg) do { (void)_dbg; (void)_len; } while(0)
#else
    #define DBG_PRINT(msg) do { \
      _len = snprintf(_dbg, sizeof(_dbg), msg); \
      CDC_Transmit_FS((uint8_t *)_dbg, (uint16_t)_len); \
      HAL_Delay(20); \
    } while(0)
#endif

    DBG_PRINT("[INIT] USB up, starting sensor init\r\n");

    // M1: MS5611
    DBG_PRINT("[INIT] MS5611...\r\n");

  // Init MS5611 barometer on SPI4
  if (!ms5611_init(&baro, &hspi4, SPI4_CS_GPIO_Port, SPI4_CS_Pin)) {
    // PROM read failed — blink LED3+LED4 as warning but continue
    for (int i = 0; i < 6; i++) {
      HAL_GPIO_TogglePin(CONT_YN_3_GPIO_Port, CONT_YN_3_Pin);
      HAL_GPIO_TogglePin(CONT_YN_4_GPIO_Port, CONT_YN_4_Pin);
      HAL_Delay(200);
    }
  }
#ifdef GYRO_TEMP_CAL
  ms5611_set_oversampling(&baro, MS5611_OSR_4096);
#else
  ms5611_set_oversampling(&baro, MS5611_OSR_2048);
#endif

    DBG_PRINT("[INIT] MS5611 done\r\n");

  // Explicitly close PC2 analog switch for SPI2 MISO (PC2_C)
  HAL_SYSCFG_AnalogSwitchConfig(SYSCFG_SWITCH_PC2, SYSCFG_SWITCH_PC2_CLOSE);

  // Fix PC2 MODER: something during init sets PC2 to analog mode instead of AF.
  {
    GPIO_InitTypeDef gpio_fix = {0};
    gpio_fix.Pin = GPIO_PIN_2;
    gpio_fix.Mode = GPIO_MODE_AF_PP;
    gpio_fix.Pull = GPIO_NOPULL;
    gpio_fix.Speed = GPIO_SPEED_FREQ_LOW;
    gpio_fix.Alternate = GPIO_AF5_SPI2;
    HAL_GPIO_Init(GPIOC, &gpio_fix);
  }

    DBG_PRINT("[INIT] LSM6DSO32...\r\n");

  // Init LSM6DSO32 IMU on SPI2
  lsm6dso32_init(&imu, &hspi2, SPI2_CS_GPIO_Port, SPI2_CS_Pin);
  if (imu.device_id != LSM6DSO32_WHO_AM_I_VAL) {
    // WHO_AM_I mismatch — blink LED3+LED4 as warning but continue
    for (int i = 0; i < 6; i++) {
      HAL_GPIO_TogglePin(CONT_YN_3_GPIO_Port, CONT_YN_3_Pin);
      HAL_GPIO_TogglePin(CONT_YN_4_GPIO_Port, CONT_YN_4_Pin);
      HAL_Delay(200);
    }
  }

    DBG_PRINT("[INIT] LSM6DSO32 done\r\n");

  // NOTE: EXTI15 for LSM6DSO32 INT2 deferred to after all init completes
  // (enabling it here caused immediate ISR hang — INT2 already asserted)

    DBG_PRINT("[INIT] EKF+attitude...\r\n");
  {
    casper_att_config_t att_cfg = {
      .Kp_grav           = 10.0f,
      .Kp_mag_pad        = 0.0f,
      .Kp_mag_flight     = 0.0f,
      .Ki                = 0.0f,   /* integral disabled — bias handled by EMA estimator; avoids windup-driven heading drift */
      .gyro_lpf_cutoff_hz = 50.0f,
      .mag_update_hz     = 10.0f,
      .launch_accel_g    = 3.0f,
    };
    casper_att_init(&att, &att_cfg);
    casper_ekf_init(&ekf);
  }

    DBG_PRINT("[INIT] ADXL372...\r\n");
  adxl372_init(&high_g, &hspi3, SPI3_CS_GPIO_Port, SPI3_CS_Pin);
  if (high_g.device_id != ADXL372_DEVID_VAL) {
    for (int i = 0; i < 6; i++) {
      HAL_GPIO_TogglePin(CONT_YN_3_GPIO_Port, CONT_YN_3_Pin);
      HAL_GPIO_TogglePin(CONT_YN_4_GPIO_Port, CONT_YN_4_Pin);
      HAL_Delay(200);
    }
  }
  if (high_g.device_id == ADXL372_DEVID_VAL) {
    adxl372_wakeup_init(&high_g, ADXL_LAUNCH_G, 6);
  }

    DBG_PRINT("[INIT] GPS...\r\n");
#ifndef GYRO_TEMP_CAL
#ifdef GPS_TEST
  /* Minimal init — no UBX config, just reset + I2C check.
   * Module outputs default NMEA which we passthrough to CDC. */
  if (!max_m10m_init_minimal(&gps, &hi2c1, NRST_GPS_GPIO_Port, NRST_GPS_Pin)) {
    for (int i = 0; i < 6; i++) {
      HAL_GPIO_TogglePin(CONT_YN_3_GPIO_Port, CONT_YN_3_Pin);
      HAL_GPIO_TogglePin(CONT_YN_4_GPIO_Port, CONT_YN_4_Pin);
      HAL_Delay(200);
    }
  }
  if (gps.alive) {
    bool cfg_ok = max_m10m_configure_gps_test(&gps);
    bool rf_ok  = max_m10m_poll_mon_rf(&gps);
    {
      char _msg[160]; int _ml;
      static const char *ant_str[] = {"INIT","DONTKNOW","OK","SHORT","OPEN"};
      static const char *pwr_str[] = {"OFF","ON","DONTKNOW"};
      if (rf_ok) {
        _ml = snprintf(_msg, sizeof(_msg),
          "[INIT] GPS cfg=%s ant=%s pwr=%s noise=%u agc=%u jam=%u\r\n",
          cfg_ok ? "OK" : "FAIL",
          gps.ant_status <= 4 ? ant_str[gps.ant_status] : "?",
          gps.ant_power <= 2 ? pwr_str[gps.ant_power] : "?",
          gps.rf_noise_per_ms, gps.rf_agc_cnt, gps.rf_jam_ind);
      } else {
        _ml = snprintf(_msg, sizeof(_msg),
          "[INIT] GPS cfg=%s (MON-RF timeout)\r\n",
          cfg_ok ? "OK" : "FAIL");
      }
      CDC_Transmit_FS((uint8_t *)_msg, (uint16_t)_ml);
      HAL_Delay(20);
    }
  }
#else
  if (!max_m10m_init(&gps, &hi2c1, NRST_GPS_GPIO_Port, NRST_GPS_Pin)) {
    for (int i = 0; i < 6; i++) {
      HAL_GPIO_TogglePin(CONT_YN_3_GPIO_Port, CONT_YN_3_Pin);
      HAL_GPIO_TogglePin(CONT_YN_4_GPIO_Port, CONT_YN_4_Pin);
      HAL_Delay(200);
    }
  }
#endif
#endif

  // Reconfigure I2C_3_INT (PC8) from output to EXTI rising edge
  {
    GPIO_InitTypeDef gpio_fix = {0};
    gpio_fix.Pin = I2C_3_INT_Pin;
    gpio_fix.Mode = GPIO_MODE_IT_RISING;
    gpio_fix.Pull = GPIO_NOPULL;
    HAL_GPIO_Init(I2C_3_INT_GPIO_Port, &gpio_fix);
  }

    DBG_PRINT("[INIT] MMC5983MA...\r\n");
#ifdef GYRO_TEMP_CAL
  mmc5983ma_init_oneshot(&mag, &hi2c3);
#else
  mmc5983ma_init(&mag, &hi2c3);
#endif
  if (mag.product_id != MMC5983MA_PROD_ID_VAL) {
    for (int i = 0; i < 6; i++) {
      HAL_GPIO_TogglePin(CONT_YN_3_GPIO_Port, CONT_YN_3_Pin);
      HAL_GPIO_TogglePin(CONT_YN_4_GPIO_Port, CONT_YN_4_Pin);
      HAL_Delay(200);
    }
  }

    DBG_PRINT("[INIT] telemetry+FSM+pyro+buzzer...\r\n");
  crc32_hw_init();
  tlm_init();
  cmd_router_init();
  cac_init();
  cfg_manager_init();
  flight_fsm_init();
  pyro_mgr_init(&hadc1, &hadc2, &hadc3);
#ifndef GPS_TEST
  buzzer_init(&htim4);
#endif

    DBG_PRINT("[INIT] radio...\r\n");
  int radio_init_ok = 0;
  {
    int rc = radio_manager_init(&hspi1);
    radio_init_ok = (rc == 0);
#if (USB_MODE != 2)
    _len = snprintf(_dbg, sizeof(_dbg), "[INIT] radio returned %d\r\n", rc);
    CDC_Transmit_FS((uint8_t *)_dbg, (uint16_t)_len);
    HAL_Delay(20);
#endif

    if (rc != 0) {
      for (int i = 0; i < 10; i++) {
        HAL_GPIO_TogglePin(CONT_YN_3_GPIO_Port, CONT_YN_3_Pin);
        HAL_GPIO_TogglePin(CONT_YN_4_GPIO_Port, CONT_YN_4_Pin);
        HAL_Delay(100);
      }
      HAL_GPIO_WritePin(CONT_YN_3_GPIO_Port, CONT_YN_3_Pin, GPIO_PIN_RESET);
      HAL_GPIO_WritePin(CONT_YN_4_GPIO_Port, CONT_YN_4_Pin, GPIO_PIN_RESET);
    }
  }

  /* Flight data logger init (reads flight index, sets up ring buffers) */
  flight_logger_init(&logger, &flash);

    DBG_PRINT("[INIT] all init complete\r\n");

#ifndef GPS_TEST
  /* Startup beep: 3 short = radio OK, 5 long = radio FAIL */
  if (radio_init_ok) {
    buzzer_beep_n(50, 3, 100, 150);
  } else {
    buzzer_beep_n(50, 5, 300, 100);
  }
#endif

  } /* end DBG_PRINT scope */

  /* EXTI15_10 (PC15 = LSM6DSO32 INT2):
   *   Originally disabled because SX1276 DIO4 (PB12) / DIO5 (PB13) were
   *   configured as IT_RISING by CubeMX and toggled constantly,
   *   producing stale-pending interrupts that flooded EXTI15_10.
   *   Fix applied in MX_GPIO_Init_2 USER block: PB12/PB13 are now plain
   *   inputs, so EXTI15_10 only ever fires for PC15.  Enable the NVIC
   *   line and clear any pending bit before enabling. */
  __HAL_GPIO_EXTI_CLEAR_IT(SPI2_INT_Pin);
  HAL_NVIC_SetPriority(EXTI15_10_IRQn, 5, 2);
  HAL_NVIC_EnableIRQ(EXTI15_10_IRQn);

  // Check flash init result (already initialized before USB)
  bool flash_ok = false;
  if (flash.jedec_id[0] != W25Q512JV_MANUFACTURER_ID) {
    for (int i = 0; i < 6; i++) {
      HAL_GPIO_TogglePin(CONT_YN_3_GPIO_Port, CONT_YN_3_Pin);
      HAL_GPIO_TogglePin(CONT_YN_4_GPIO_Port, CONT_YN_4_Pin);
      HAL_Delay(200);
    }
  } else {
    flash_ok = true;
  }
  (void)flash_ok;  // suppress warning when FATFS block is compiled out

#if (USB_MODE != 2)
  bool fatfs_ok = false;
  bool file_test_ok = false;
  /* FATFS now lives in a 4 MB partition at the top of flash
   * (FATFS_FLASH_BASE = 0x03C00000), separate from the flight log region.
   * f_mkfs and FATFS writes only ever touch that partition, so this init
   * is safe in every build. */
#if (TEST_MODE != 1)
  if (flash_ok) {
    FRESULT fres = f_mount(&USERFatFS, USERPath, 1);
    if (fres == FR_NO_FILESYSTEM) {
      // First boot — format the flash with FAT
      BYTE work[4096];
      fres = f_mkfs(USERPath, FM_FAT, 0, work, sizeof(work));
      if (fres == FR_OK)
        fres = f_mount(&USERFatFS, USERPath, 1);
    }
    fatfs_ok = (fres == FR_OK);
  }

  // File I/O test: write a string, read it back, compare
  if (fatfs_ok) {
    const char test_str[] = "CASPER-2 FATFS OK";
    char read_buf[32] = {0};
    UINT bw = 0, br = 0;
    FRESULT fr;

    // Write test file
    fr = f_open(&USERFile, "TEST.TXT", FA_CREATE_ALWAYS | FA_WRITE);
    if (fr == FR_OK) {
      fr = f_write(&USERFile, test_str, sizeof(test_str) - 1, &bw);
      f_close(&USERFile);
    }

    // Read it back
    if (fr == FR_OK && bw == sizeof(test_str) - 1) {
      fr = f_open(&USERFile, "TEST.TXT", FA_READ);
      if (fr == FR_OK) {
        fr = f_read(&USERFile, read_buf, sizeof(test_str) - 1, &br);
        f_close(&USERFile);
      }
    }

    // Verify
    if (fr == FR_OK && br == sizeof(test_str) - 1 &&
        memcmp(test_str, read_buf, br) == 0) {
      file_test_ok = true;
    }
  }
#endif /* TEST_MODE != 1 */
#endif /* USB_MODE != 2 */

  /* DEBUG: LED4 ON = FATFS done */
  HAL_GPIO_WritePin(CONT_YN_4_GPIO_Port, CONT_YN_4_Pin, GPIO_PIN_SET);

  // M5: init complete — all LEDs off, then blink all 3 times
  HAL_GPIO_WritePin(CONT_YN_1_GPIO_Port, CONT_YN_1_Pin, GPIO_PIN_RESET);
  HAL_GPIO_WritePin(CONT_YN_2_GPIO_Port, CONT_YN_2_Pin, GPIO_PIN_RESET);
  HAL_GPIO_WritePin(CONT_YN_3_GPIO_Port, CONT_YN_3_Pin, GPIO_PIN_RESET);
  HAL_GPIO_WritePin(CONT_YN_4_GPIO_Port, CONT_YN_4_Pin, GPIO_PIN_RESET);
  for (int i = 0; i < 3; i++) {
    HAL_GPIO_WritePin(CONT_YN_1_GPIO_Port, CONT_YN_1_Pin, GPIO_PIN_SET);
    HAL_GPIO_WritePin(CONT_YN_2_GPIO_Port, CONT_YN_2_Pin, GPIO_PIN_SET);
    HAL_GPIO_WritePin(CONT_YN_3_GPIO_Port, CONT_YN_3_Pin, GPIO_PIN_SET);
    HAL_GPIO_WritePin(CONT_YN_4_GPIO_Port, CONT_YN_4_Pin, GPIO_PIN_SET);
    HAL_Delay(150);
    HAL_GPIO_WritePin(CONT_YN_1_GPIO_Port, CONT_YN_1_Pin, GPIO_PIN_RESET);
    HAL_GPIO_WritePin(CONT_YN_2_GPIO_Port, CONT_YN_2_Pin, GPIO_PIN_RESET);
    HAL_GPIO_WritePin(CONT_YN_3_GPIO_Port, CONT_YN_3_Pin, GPIO_PIN_RESET);
    HAL_GPIO_WritePin(CONT_YN_4_GPIO_Port, CONT_YN_4_Pin, GPIO_PIN_RESET);
    HAL_Delay(150);
  }
  HAL_Delay(500);  // USB enumeration time

#if (USB_MODE != 2)
  // Print status on first few lines so terminal can capture it
  {
    char info_buf[160];
    int info_len = snprintf(info_buf, sizeof(info_buf),
        ">who:0x%02X,adxl:0x%02X,mag:0x%02X,flash_id:0x%02X%02X%02X,fatfs:%s,file_test:%s,gps:%s\r\n",
        imu.device_id, high_g.device_id, mag.product_id,
        flash.jedec_id[0], flash.jedec_id[1], flash.jedec_id[2],
        fatfs_ok ? "OK" : "ERR",
        file_test_ok ? "PASS" : "FAIL",
        gps.alive ? "OK" : "NO_ACK");
    for (int i = 0; i < 5; i++) {
      CDC_Transmit_FS((uint8_t *)info_buf, info_len);
      HAL_Delay(200);
    }
  }
  // Print MS5611 raw PROM calibration coefficients
  {
    char prom_buf[100];
    int prom_len = snprintf(prom_buf, sizeof(prom_buf),
        ">PROM:C0=%u,C1=%u,C2=%u,C3=%u,C4=%u,C5=%u,C6=%u\r\n",
        baro.prom[0], baro.prom[1], baro.prom[2],
        baro.prom[3], baro.prom[4], baro.prom[5], baro.prom[6]);
    for (int i = 0; i < 3; i++) {
      CDC_Transmit_FS((uint8_t *)prom_buf, prom_len);
      HAL_Delay(200);
    }
  }
#endif /* USB_MODE != 2 */

#if (USB_MODE == 2)
  /* MSC mode: LEDs now driven by pyro_tick for continuity — all off initially */
  HAL_GPIO_WritePin(CONT_YN_1_GPIO_Port, CONT_YN_1_Pin, GPIO_PIN_RESET);
  HAL_GPIO_WritePin(CONT_YN_2_GPIO_Port, CONT_YN_2_Pin, GPIO_PIN_RESET);
  HAL_GPIO_WritePin(CONT_YN_3_GPIO_Port, CONT_YN_3_Pin, GPIO_PIN_RESET);
  HAL_GPIO_WritePin(CONT_YN_4_GPIO_Port, CONT_YN_4_Pin, GPIO_PIN_RESET);
#else
  /* Clear all LEDs before calibration sequence */
  HAL_GPIO_WritePin(CONT_YN_1_GPIO_Port, CONT_YN_1_Pin, GPIO_PIN_RESET);
  HAL_GPIO_WritePin(CONT_YN_2_GPIO_Port, CONT_YN_2_Pin, GPIO_PIN_RESET);
  HAL_GPIO_WritePin(CONT_YN_3_GPIO_Port, CONT_YN_3_Pin, GPIO_PIN_RESET);
  HAL_GPIO_WritePin(CONT_YN_4_GPIO_Port, CONT_YN_4_Pin, GPIO_PIN_RESET);
#endif

#ifdef MAG_CAL
  mag_cal_t mcal;
  if (!mag_cal_init(&mcal)) {
    /* File open failed — rapid blink all LEDs */
    while (1) {
      HAL_GPIO_TogglePin(CONT_YN_1_GPIO_Port, CONT_YN_1_Pin);
      HAL_GPIO_TogglePin(CONT_YN_2_GPIO_Port, CONT_YN_2_Pin);
      HAL_GPIO_TogglePin(CONT_YN_3_GPIO_Port, CONT_YN_3_Pin);
      HAL_GPIO_TogglePin(CONT_YN_4_GPIO_Port, CONT_YN_4_Pin);
      HAL_Delay(100);
    }
  }
#endif
#ifdef MAG_VAL
  mag_val_t mval;
  if (!mag_val_init(&mval)) {
    while (1) {
      HAL_GPIO_TogglePin(CONT_YN_1_GPIO_Port, CONT_YN_1_Pin);
      HAL_GPIO_TogglePin(CONT_YN_2_GPIO_Port, CONT_YN_2_Pin);
      HAL_GPIO_TogglePin(CONT_YN_3_GPIO_Port, CONT_YN_3_Pin);
      HAL_GPIO_TogglePin(CONT_YN_4_GPIO_Port, CONT_YN_4_Pin);
      HAL_Delay(100);
    }
  }
#elif defined(GYRO_TEMP_CAL)
  temp_cal_t tcal;
  if (!temp_cal_init(&tcal)) {
    /* File open failed — rapid blink all LEDs */
    while (1) {
      HAL_GPIO_TogglePin(CONT_YN_1_GPIO_Port, CONT_YN_1_Pin);
      HAL_GPIO_TogglePin(CONT_YN_2_GPIO_Port, CONT_YN_2_Pin);
      HAL_GPIO_TogglePin(CONT_YN_3_GPIO_Port, CONT_YN_3_Pin);
      HAL_GPIO_TogglePin(CONT_YN_4_GPIO_Port, CONT_YN_4_Pin);
      HAL_Delay(100);
    }
  }
#else
  /* IWDG: 500ms timeout (LSI ~32kHz, /4 -> 8kHz, reload 3999 -> 500ms).
   * Started here — after all blocking init — so USB enumeration + sensor
   * init cannot trip it.  flight_loop_tick() kicks it every iteration. */
  MX_IWDG1_Init();
  flight_loop_init();
  flight_logger_start(&logger);  /* Begin PAD-state ring filling + erase-ahead */
#ifdef LOGGER_SANITY
  logger_sanity_init(&logger);
#endif
#endif

#endif /* BUILD_TARGET_GROUND */
  /* USER CODE END 2 */

  /* Infinite loop */
  /* USER CODE BEGIN WHILE */
  while (1)
  {
    /* USER CODE END WHILE */

    /* USER CODE BEGIN 3 */
#if defined(BUILD_TARGET_GROUND)
    ground_main_tick();
#elif (USB_MODE == 2)
    buzzer_tick();
    // MSC mode: pyro continuity LEDs at 10 Hz (replaces old ping-pong)
    {
      static uint32_t last_pyro_tick = 0;
      if (HAL_GetTick() - last_pyro_tick >= 100) {
        pyro_mgr_tick();
        last_pyro_tick = HAL_GetTick();
      }
    }
#elif defined(MAG_CAL)
    {
      static uint32_t last_mag_tick = 0;
      uint32_t now = HAL_GetTick();

      /* 100 Hz mag read + calibration tick */
      if (now - last_mag_tick >= 10) {
        mmc5983ma_read(&mag);
        mag_cal_tick(&mcal, &mag, now);
        last_mag_tick = now;
      }

      /* Done: all LEDs solid, print final message, idle forever */
      if (mag_cal_is_done(&mcal)) {
        HAL_GPIO_WritePin(CONT_YN_1_GPIO_Port, CONT_YN_1_Pin, GPIO_PIN_SET);
        HAL_GPIO_WritePin(CONT_YN_2_GPIO_Port, CONT_YN_2_Pin, GPIO_PIN_SET);
        HAL_GPIO_WritePin(CONT_YN_3_GPIO_Port, CONT_YN_3_Pin, GPIO_PIN_SET);
        HAL_GPIO_WritePin(CONT_YN_4_GPIO_Port, CONT_YN_4_Pin, GPIO_PIN_SET);
        char done_buf[64];
        int done_len = snprintf(done_buf, sizeof(done_buf),
            ">mag_cal: DONE (%lu samples)\r\n", mcal.sample_count);
        for (int i = 0; i < 5; i++) {
          CDC_Transmit_FS((uint8_t *)done_buf, done_len);
          HAL_Delay(200);
        }
        while (1) { HAL_Delay(1000); }
      }
    }
#elif defined(MAG_VAL)
    {
      static uint32_t last_mag_tick = 0;
      uint32_t now = HAL_GetTick();

      /* 100 Hz mag read + validation tick */
      if (now - last_mag_tick >= 10) {
        mmc5983ma_read(&mag);
        mag_val_tick(&mval, &mag, now);
        last_mag_tick = now;
      }

      /* Done: all LEDs solid, print final message, idle forever */
      if (mag_val_is_done(&mval)) {
        HAL_GPIO_WritePin(CONT_YN_1_GPIO_Port, CONT_YN_1_Pin, GPIO_PIN_SET);
        HAL_GPIO_WritePin(CONT_YN_2_GPIO_Port, CONT_YN_2_Pin, GPIO_PIN_SET);
        HAL_GPIO_WritePin(CONT_YN_3_GPIO_Port, CONT_YN_3_Pin, GPIO_PIN_SET);
        HAL_GPIO_WritePin(CONT_YN_4_GPIO_Port, CONT_YN_4_Pin, GPIO_PIN_SET);
        char done_buf[64];
        int done_len = snprintf(done_buf, sizeof(done_buf),
            ">mag_val: DONE (%lu samples)\r\n", mval.sample_count);
        for (int i = 0; i < 5; i++) {
          CDC_Transmit_FS((uint8_t *)done_buf, done_len);
          HAL_Delay(200);
        }
        while (1) { HAL_Delay(1000); }
      }
    }
#elif defined(GYRO_TEMP_CAL)
    {
      static uint32_t last_tcal_tick = 0;
      uint32_t now = HAL_GetTick();

      /* 10 Hz: sample all sensors + log to CSV */
      if (now - last_tcal_tick >= 100) {
        temp_cal_tick(&tcal, &imu, &baro, &mag, now);
        last_tcal_tick = now;
      }

      /* Stopped: all LEDs solid, idle forever */
      if (temp_cal_is_stopped(&tcal)) {
        HAL_GPIO_WritePin(CONT_YN_1_GPIO_Port, CONT_YN_1_Pin, GPIO_PIN_SET);
        HAL_GPIO_WritePin(CONT_YN_2_GPIO_Port, CONT_YN_2_Pin, GPIO_PIN_SET);
        HAL_GPIO_WritePin(CONT_YN_3_GPIO_Port, CONT_YN_3_Pin, GPIO_PIN_SET);
        HAL_GPIO_WritePin(CONT_YN_4_GPIO_Port, CONT_YN_4_Pin, GPIO_PIN_SET);
        while (1) { HAL_Delay(1000); }
      }
    }
#elif defined(GPS_TEST)
    {
      static uint32_t last_status = 0;
      uint32_t now = HAL_GetTick();

      /* NMEA passthrough: read I2C, forward complete lines to CDC */
      max_m10m_tick_nmea(&gps);

      if (gps.nmea_line_ready) {
        gps.nmea_line_ready = false;
        uint8_t len = (uint8_t)strlen(gps.nmea_line);
        /* Add \r\n for serial monitor display */
        if (len < sizeof(gps.nmea_line) - 2) {
          gps.nmea_line[len]   = '\r';
          gps.nmea_line[len+1] = '\n';
          CDC_Transmit_FS((uint8_t *)gps.nmea_line, len + 2);
          HAL_Delay(5);
        }
      }

      /* Status line every 5s with RF diagnostics */
      if (now - last_status >= 5000) {
        last_status = now;
        char sbuf[180];
        int slen;

        static const char *ant_str[] = {"INIT","DONTKNOW","OK","SHORT","OPEN"};
        static const char *pwr_str[] = {"OFF","ON","DONTKNOW"};

        if (gps.mon_rf_valid) {
          slen = snprintf(sbuf, sizeof(sbuf),
            ">-- ant=%s pwr=%s agc=%u noise=%u jam=%u | polls=%lu avZ=%lu i2cE=%lu bytes=%lu --\r\n",
            gps.ant_status <= 4 ? ant_str[gps.ant_status] : "?",
            gps.ant_power <= 2 ? pwr_str[gps.ant_power] : "?",
            gps.rf_agc_cnt, gps.rf_noise_per_ms, gps.rf_jam_ind,
            (unsigned long)gps.dbg_polls,
            (unsigned long)gps.dbg_avail_zero,
            (unsigned long)gps.dbg_i2c_err,
            (unsigned long)gps.dbg_bytes_read);
        } else {
          slen = snprintf(sbuf, sizeof(sbuf),
            ">-- ant=? (no MON-RF) | polls=%lu avZ=%lu i2cE=%lu bytes=%lu --\r\n",
            (unsigned long)gps.dbg_polls,
            (unsigned long)gps.dbg_avail_zero,
            (unsigned long)gps.dbg_i2c_err,
            (unsigned long)gps.dbg_bytes_read);
        }
        CDC_Transmit_FS((uint8_t *)sbuf, (uint16_t)slen);
        HAL_GPIO_TogglePin(CONT_YN_1_GPIO_Port, CONT_YN_1_Pin);
      }

      /* Re-poll MON-RF every 30s for fresh RF diagnostics */
      {
        static uint32_t last_rf_poll = 0;
        if (now - last_rf_poll >= 30000) {
          last_rf_poll = now;
          /* Non-blocking: send poll, response parsed in tick_nmea's UBX parser */
          max_m10m_poll_mon_rf(&gps);
        }
      }
    }
#else
    flight_loop_tick();
#endif
  }
  /* USER CODE END 3 */
}

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
/* USER CODE BEGIN 4 */
void HAL_GPIO_EXTI_Callback(uint16_t GPIO_Pin)
{
  /* ---- Radio SX1276 DIO pins ---- */
  if (GPIO_Pin == SPI1_INT_Pin) {   /* PB1  = DIO0 (TxDone/RxDone) */
    g_radio_dio0_flag = 1;
  }
  if (GPIO_Pin == RADIO_DIO1_Pin) { /* PD7  = DIO1 (RxTimeout)     */
    g_radio_dio1_flag = 1;
  }
  if (GPIO_Pin == RADIO_DIO3_Pin) { /* PA4  = DIO3 (ValidHeader)   */
    g_radio_dio3_flag = 1;
  }

  /* ---- GPS data ready (both builds) ---- */
  if (GPIO_Pin == I2C1_INT_Pin) {   /* PE0  = GPS data ready */
    max_m10m_irq_handler(&gps);
  }

#ifndef BUILD_TARGET_GROUND
  /* ---- Flight-only sensor interrupts ---- */
  if (GPIO_Pin == SPI2_INT_Pin) {   /* PC15 = LSM6DSO32 INT2 */
#ifdef LOGGER_SANITY
    extern volatile uint32_t g_imu_exti_fires;
    g_imu_exti_fires++;
#endif
    lsm6dso32_irq_handler(&imu);
  }
  if (GPIO_Pin == I2C_3_INT_Pin) {  /* PC8  = MMC5983MA DRDY */
    mmc5983ma_irq_handler(&mag);
  }
#endif
}
/* USER CODE END 4 */

 /* MPU Configuration */

void MPU_Config(void)
{
  MPU_Region_InitTypeDef MPU_InitStruct = {0};

  /* Disables the MPU */
  HAL_MPU_Disable();

  /** Initializes and configures the Region and the memory to be protected
  */
  MPU_InitStruct.Enable = MPU_REGION_ENABLE;
  MPU_InitStruct.Number = MPU_REGION_NUMBER0;
  MPU_InitStruct.BaseAddress = 0x0;
  MPU_InitStruct.Size = MPU_REGION_SIZE_4GB;
  MPU_InitStruct.SubRegionDisable = 0x87;
  MPU_InitStruct.TypeExtField = MPU_TEX_LEVEL0;
  MPU_InitStruct.AccessPermission = MPU_REGION_NO_ACCESS;
  MPU_InitStruct.DisableExec = MPU_INSTRUCTION_ACCESS_DISABLE;
  MPU_InitStruct.IsShareable = MPU_ACCESS_SHAREABLE;
  MPU_InitStruct.IsCacheable = MPU_ACCESS_NOT_CACHEABLE;
  MPU_InitStruct.IsBufferable = MPU_ACCESS_NOT_BUFFERABLE;

  HAL_MPU_ConfigRegion(&MPU_InitStruct);
  /* Enables the MPU */
  HAL_MPU_Enable(MPU_PRIVILEGED_DEFAULT);

}

/**
  * @brief  This function is executed in case of error occurrence.
  * @retval None
  */
void Error_Handler(void)
{
  /* USER CODE BEGIN Error_Handler_Debug */
  /* User can add his own implementation to report the HAL error return state */
  __disable_irq();

  // DIAGNOSTIC: Rapid blink all LEDs to indicate error
  // Enable GPIO clocks (might already be enabled, but safe to call again)
  __HAL_RCC_GPIOE_CLK_ENABLE();
  __HAL_RCC_GPIOB_CLK_ENABLE();
  __HAL_RCC_GPIOA_CLK_ENABLE();

  // Configure all 4 LED pins as GP output (MODER = 01)
  GPIOA->MODER = (GPIOA->MODER & ~(3UL << (10*2))) | (1UL << (10*2)); // PA10
  GPIOB->MODER = (GPIOB->MODER & ~(3UL << (14*2))) | (1UL << (14*2)); // PB14
  GPIOE->MODER = (GPIOE->MODER & ~(3UL << (8*2)))  | (1UL << (8*2));  // PE8
  GPIOE->MODER = (GPIOE->MODER & ~(3UL << (7*2)))  | (1UL << (7*2));  // PE7

  while (1)
  {
      // Very fast blink all LEDs (100ms) = ERROR indication
      HAL_GPIO_WritePin(GPIOE, GPIO_PIN_7, GPIO_PIN_SET);  // YN4
      HAL_GPIO_WritePin(GPIOE, GPIO_PIN_8, GPIO_PIN_SET);  // YN3
      HAL_GPIO_WritePin(GPIOB, GPIO_PIN_14, GPIO_PIN_SET); // YN2
      HAL_GPIO_WritePin(GPIOA, GPIO_PIN_10, GPIO_PIN_SET); // YN1
      for(volatile uint32_t i = 0; i < 500000; i++);  // Software delay

      HAL_GPIO_WritePin(GPIOE, GPIO_PIN_7, GPIO_PIN_RESET);
      HAL_GPIO_WritePin(GPIOE, GPIO_PIN_8, GPIO_PIN_RESET);
      HAL_GPIO_WritePin(GPIOB, GPIO_PIN_14, GPIO_PIN_RESET);
      HAL_GPIO_WritePin(GPIOA, GPIO_PIN_10, GPIO_PIN_RESET);
      for(volatile uint32_t i = 0; i < 500000; i++);
  }
  /* USER CODE END Error_Handler_Debug */
}
#ifdef USE_FULL_ASSERT
/**
  * @brief  Reports the name of the source file and the source line number
  *         where the assert_param error has occurred.
  * @param  file: pointer to the source file name
  * @param  line: assert_param error line source number
  * @retval None
  */
void assert_failed(uint8_t *file, uint32_t line)
{
  /* USER CODE BEGIN 6 */
  /* User can add his own implementation to report the file name and line number,
     ex: printf("Wrong parameters value: file %s on line %d\r\n", file, line) */
  /* USER CODE END 6 */
}
#endif /* USE_FULL_ASSERT */
