AshwinVishwanath/C.A.S.P.E.R.-2/Software/Casper2.ioc

Mcu.UserName=STM32H750VBTx
PA0.Signal=S_TIM2_CH1_ETR
PA1.Signal=S_TIM2_CH2
PA10.GPIO_Label=CONT YN 1
PA10.Signal=GPIO_Output
PA11.Signal=USB_OTG_FS_DM
PA12.Signal=USB_OTG_FS_DP
PA2.Signal=S_TIM2_CH3
PA3.Signal=S_TIM2_CH4
PA4.GPIO_Label=RADIO DIO3
PA4.Signal=GPXTI4
PA5.Signal=SPI1_SCK
PA6.GPIO_Label=CONT 2
PA6.Signal=ADCx_INP3
PA7.Signal=SPI1_MOSI
PA8.Signal=I2C3_SCL
PB0.GPIO_Label=Radio_CS
PB0.Signal=GPIO_Output
PB1.GPIO_Label=SPI1 INT
PB1.Signal=GPXTI1
PB10.Signal=I2C2_SCL
PB11.Signal=I2C2_SDA
PB12.GPIO_Label=RADIO DIO4
PB12.Signal=GPXTI12
PB13.GPIO_Label=RADIO DIO5
PB13.Signal=GPXTI13
PB14.GPIO_Label=CONT YN 2
PB14.Signal=GPIO_Output
PB15.GPIO_Label=PY4
PB15.Signal=GPIO_Output
PB2.Signal=QUADSPI_CLK
PB6.Signal=QUADSPI_BK1_NCS
PB8.Signal=I2C1_SCL
PB9.Signal=I2C1_SDA
PC0.GPIO_Label=CONT 4
PC0.Signal=ADCx_INP10
PC1.Signal=SPI2_MOSI
PC10.Signal=SPI3_SCK
PC11.Signal=SPI3_MISO
PC12.Signal=SPI3_MOSI
PC13.GPIO_Label=RADIO_NRST
PC13.Signal=GPIO_Output
PC2_C.Signal=SPI2_MISO
PC3_C.GPIO_Label=CONT 3
PC3_C.Signal=ADC3_INP1
PC4.GPIO_Label=CONT1
PC4.Signal=ADCx_INP4
PC8.GPIO_Label=I2C 3 INT
PC8.Signal=GPIO_Output
PC9.Signal=I2C3_SDA
PD10.GPIO_Label=PY1
PD10.Signal=GPIO_Output
PD11.Signal=QUADSPI_BK1_IO0
PD12.Signal=QUADSPI_BK1_IO1
PD13.Signal=QUADSPI_BK1_IO3
PD14.GPIO_Label=BUZZER
PD14.Signal=S_TIM4_CH3
PD2.GPIO_Label=SPI3 INT
PD2.Signal=GPXTI2
PD3.Signal=SPI2_SCK
PD4.GPIO_Label=GPS_TIMEPULSE
PD4.Signal=GPIO_Input
PD6.GPIO_Label=RADIO DIO2
PD6.Signal=GPXTI6
PD7.GPIO_Label=RADIO DIO1
PD7.Signal=GPXTI7
PD8.GPIO_Label=PY3
PD8.Signal=GPIO_Output
PD9.GPIO_Label=PY2
PD9.Signal=GPIO_Output
PE0.GPIO_Label=I2C1 INT
PE0.Signal=GPXTI0
PE11.GPIO_Label=SPI4 CS
PE11.Signal=GPIO_Output
PE12.Signal=SPI4_SCK
PE13.Signal=SPI4_MISO
PE14.Signal=SPI4_MOSI
PE15.GPIO_Label=NRST GPS
PE15.Signal=GPIO_Output
PE2.Signal=QUADSPI_BK1_IO2
PE7.GPIO_Label=CONT YN 4
PE7.Signal=GPIO_Output
PE8.GPIO_Label=CONT YN 3
PE8.Signal=GPIO_Output
