AshwinVishwanath/C.A.S.P.E.R.-2/Software/Core/Inc/main.h

#define RADIO_NRST_Pin GPIO_PIN_13
#define RADIO_NRST_GPIO_Port GPIOC
#define SPI2_CS_Pin GPIO_PIN_14
#define SPI2_CS_GPIO_Port GPIOC
#define SPI2_INT_Pin GPIO_PIN_15
#define SPI2_INT_GPIO_Port GPIOC
#define CONT_4_Pin GPIO_PIN_0
#define CONT_4_GPIO_Port GPIOC
#define CONT_3_Pin GPIO_PIN_3
#define CONT_3_GPIO_Port GPIOC
#define RADIO_DIO3_Pin GPIO_PIN_4
#define RADIO_DIO3_GPIO_Port GPIOA
#define CONT_2_Pin GPIO_PIN_6
#define CONT_2_GPIO_Port GPIOA
#define CONT1_Pin GPIO_PIN_4
#define CONT1_GPIO_Port GPIOC
#define Radio_CS_Pin GPIO_PIN_0
#define Radio_CS_GPIO_Port GPIOB
#define SPI1_INT_Pin GPIO_PIN_1
#define SPI1_INT_GPIO_Port GPIOB
#define CONT_YN_4_Pin GPIO_PIN_7
#define CONT_YN_4_GPIO_Port GPIOE
#define CONT_YN_3_Pin GPIO_PIN_8
#define CONT_YN_3_GPIO_Port GPIOE
#define SPI4_CS_Pin GPIO_PIN_11
#define SPI4_CS_GPIO_Port GPIOE
#define NRST_GPS_Pin GPIO_PIN_15
#define NRST_GPS_GPIO_Port GPIOE
#define RADIO_DIO4_Pin GPIO_PIN_12
#define RADIO_DIO4_GPIO_Port GPIOB
#define RADIO_DIO5_Pin GPIO_PIN_13
#define RADIO_DIO5_GPIO_Port GPIOB
#define CONT_YN_2_Pin GPIO_PIN_14
#define CONT_YN_2_GPIO_Port GPIOB
#define PY4_Pin GPIO_PIN_15
#define PY4_GPIO_Port GPIOB
#define PY3_Pin GPIO_PIN_8
#define PY3_GPIO_Port GPIOD
#define PY2_Pin GPIO_PIN_9
#define PY2_GPIO_Port GPIOD
#define PY1_Pin GPIO_PIN_10
#define PY1_GPIO_Port GPIOD
#define BUZZER_Pin GPIO_PIN_14
#define BUZZER_GPIO_Port GPIOD
#define I2C_3_INT_Pin GPIO_PIN_8
#define I2C_3_INT_GPIO_Port GPIOC
#define CONT_YN_1_Pin GPIO_PIN_10
#define CONT_YN_1_GPIO_Port GPIOA
#define SPI3_CS_Pin GPIO_PIN_15
#define SPI3_CS_GPIO_Port GPIOA
#define SPI3_INT_Pin GPIO_PIN_2
#define SPI3_INT_GPIO_Port GPIOD
#define GPS_TIMEPULSE_Pin GPIO_PIN_4
#define GPS_TIMEPULSE_GPIO_Port GPIOD
#define RADIO_DIO2_Pin GPIO_PIN_6
#define RADIO_DIO2_GPIO_Port GPIOD
#define RADIO_DIO1_Pin GPIO_PIN_7
#define RADIO_DIO1_GPIO_Port GPIOD
#define I2C1_INT_Pin GPIO_PIN_0
#define I2C1_INT_GPIO_Port GPIOE
