AshwinVishwanath/C.A.S.P.E.R.-2/Software/App/flight/flight_loop.h

/* ============================================================
 *  TIER:     CORE-FLIGHT
 *  MODULE:   Flight Loop
 *  SUMMARY:  Top-level superloop: schedules sensor reads, EKF, FSM, telemetry.
 * ============================================================ */
#ifndef APP_FLIGHT_FLIGHT_LOOP_H
#define APP_FLIGHT_FLIGHT_LOOP_H

#include <stdbool.h>

void flight_loop_init(void);
void flight_loop_tick(void);

/* True once the 30-second pad-mode calibration has completed. */
bool flight_loop_is_cal_done(void);

#endif
