AshwinVishwanath/C.A.S.P.E.R.-2/Software/App/command/cac_handler.c

/* ============================================================
 *  TIER:     SAFETY-CRITICAL
 *  MODULE:   CAC Handler
 *  SUMMARY:  Command-Acknowledge-Confirm gate for arm/disarm/fire commands.
 * ============================================================ */
#include "cac_handler.h"
#include "crc32_hw.h"
#include "tlm_types.h"
#include "tlm_manager.h"
#include "pyro_manager.h"
#include "flight_fsm.h"
#include "endian.h"
#include "stm32h7xx_hal.h"
#include <string.h>

/* ── Forward declaration for cfg_manager ───────────────────────── */
extern uint32_t cfg_get_active_hash(void);

/* ── Internal CAC state ────────────────────────────────────────── */
typedef enum {
    CAC_IDLE,
    CAC_AWAITING_CONFIRM
} cac_phase_t;

typedef enum {
    PENDING_ARM,
    PENDING_FIRE
} pending_type_t;

static cac_phase_t  s_phase;
static uint16_t     s_pending_nonce;
static pending_type_t s_pending_type;
static uint8_t      s_pending_channel;   /* 1-indexed */
static uint8_t      s_pending_action;    /* ARM: 0x01=arm, 0x02=disarm */
static uint16_t     s_pending_duration;  /* FIRE: duration_ms */
static uint32_t     s_confirm_deadline;
/* Monotonic nonce — wraps at 65535; acceptable for single power cycle */
static uint16_t     s_last_seen_nonce;

/* ── Test mode state ──────────────────────────────────────────── */
static bool     s_test_mode;
static uint32_t s_test_mode_deadline;

/* ── Send NACK packet (10 bytes) per INTERFACE_SPEC §8.3 ─────── */
/* [0]=0xE0 [1-2]=nonce [3]=error_code [4-5]=rsvd [6-9]=CRC      */
static void send_nack(uint16_t nonce, uint8_t error_code)
{
    uint8_t pkt[SIZE_NACK];
    pkt[0] = MSG_ID_NACK;       /* 0xE0 */
    put_le16(&pkt[1], nonce);
    pkt[3] = error_code;
    pkt[4] = 0x00;              /* reserved */
    pkt[5] = 0x00;              /* reserved */
    uint32_t crc = crc32_hw_compute(pkt, 6);
    put_le32(&pkt[6], crc);
    tlm_send_response(pkt, SIZE_NACK);
}

/* ── Send ARM ACK packet (12 bytes) per INTERFACE_SPEC §8.1 ──── */
/* [0]=0xA0 [1-2]=nonce [3]=ch [4]=act [5]=arm [6]=cont [7]=rsvd  */
/* [8-11]=CRC                                                      */
static void send_arm_ack(uint16_t nonce, uint8_t channel, uint8_t action)
{
    uint8_t pkt[SIZE_ACK_ARM];
    pkt[0] = MSG_ID_ACK_ARM;    /* 0xA0 */
    put_le16(&pkt[1], nonce);
    pkt[3] = channel;
    pkt[4] = action;
    pkt[5] = pyro_mgr_get_arm_bitmap();
    pkt[6] = pyro_mgr_get_cont_bitmap();
    pkt[7] = 0x00;              /* reserved */
    uint32_t crc = crc32_hw_compute(pkt, 8);
    put_le32(&pkt[8], crc);
    tlm_send_response(pkt, SIZE_ACK_ARM);
}

/* ── Send FIRE ACK packet (13 bytes) per INTERFACE_SPEC §8.2 ─── */
/* [0]=0xA1 [1-2]=nonce [3]=ch [4]=dur [5]=flags [6]=cont         */
/* [7-8]=rsvd [9-12]=CRC                                          */
static void send_fire_ack(uint16_t nonce, uint8_t channel,
                           uint8_t duration, uint8_t flags)
{
    uint8_t pkt[SIZE_ACK_FIRE];
    pkt[0] = MSG_ID_ACK_FIRE;   /* 0xA1 */
    put_le16(&pkt[1], nonce);
    pkt[3] = channel;
    pkt[4] = duration;
    pkt[5] = flags;             /* bit0=test_mode, bit1=channel_armed */
    pkt[6] = pyro_mgr_get_cont_bitmap();
    pkt[7] = 0x00;              /* reserved */
    pkt[8] = 0x00;              /* reserved */
    uint32_t crc = crc32_hw_compute(pkt, 9);
    put_le32(&pkt[9], crc);
    tlm_send_response(pkt, SIZE_ACK_FIRE);
}

/* ── Public API ───────────────────────────────────────────────── */

void cac_init(void)
{
    s_phase = CAC_IDLE;
    s_pending_nonce = 0;
    s_test_mode = false;
    s_test_mode_deadline = 0;
}

void cac_tick(void)
{
    uint32_t now = HAL_GetTick();

    /* Confirm timeout */
    if (s_phase == CAC_AWAITING_CONFIRM) {
        if (now - s_confirm_deadline > 0 &&
            (int32_t)(now - s_confirm_deadline) >= 0) {
            s_phase = CAC_IDLE;
        }
    }

    /* Test mode timeout */
    if (s_test_mode) {
        if ((int32_t)(now - s_test_mode_deadline) >= 0) {
            s_test_mode = false;
            pyro_mgr_set_test_mode(false);
            tlm_queue_event(FC_EVT_STATE, (uint16_t)flight_fsm_get_state());
        }
    }
}

/* ── ARM / DISARM handler ──── per INTERFACE_SPEC §7.1 ────────── */
/* CMD_ARM (12 bytes): [0]=0x80 [1]=0xCA [2]=0x5A [3-4]=nonce     */
/* [5]=channel [6]=action [7]=~channel [8-11]=CRC-32(0..7)        */
void cac_handle_arm(const uint8_t *data, int len)
{
    if (len < SIZE_CMD_ARM) return;

    /* Check magic */
    if (data[1] != CAC_MAGIC_1 || data[2] != CAC_MAGIC_2) return;

    /* Check complement: channel vs ~channel */
    if ((data[5] ^ data[7]) != 0xFF) return;

    /* Validate CRC-32 over bytes 0-7 */
    uint32_t received_crc = get_le32(&data[8]);
    if (crc32_hw_compute(data, 8) != received_crc) return;

    uint16_t nonce   = get_le16(&data[3]);
    uint8_t  channel = data[5];     /* 0-indexed in spec */
    uint8_t  action  = data[6];

    /* Convert to 1-indexed channel for pyro_manager */
    uint8_t ch1 = channel + 1;

    /* Idempotent: same nonce while awaiting confirm → re-send ACK */
    if (s_phase == CAC_AWAITING_CONFIRM && nonce == s_pending_nonce &&
        s_pending_type == PENDING_ARM) {
        send_arm_ack(nonce, channel, action);
        return;
    }

    if (nonce <= s_last_seen_nonce) {
        send_nack(nonce, NACK_ERR_NONCE_REPLAY);
        return;
    }
    s_last_seen_nonce = nonce;

    /* Channel range check */
    if (channel > 3) {
        send_nack(nonce, NACK_ERR_BAD_STATE);
        return;
    }

    /* Precondition: continuity required for ARM */
    if (action == CAC_ACTION_ARM && !pyro_mgr_has_continuity(ch1)) {
        send_nack(nonce, NACK_ERR_NO_CONTINUITY);
        return;
    }

    /* Store pending action */
    s_phase = CAC_AWAITING_CONFIRM;
    s_pending_nonce = nonce;
    s_pending_type = PENDING_ARM;
    s_pending_channel = ch1;
    s_pending_action = action;
    s_confirm_deadline = HAL_GetTick() + CAC_CONFIRM_TIMEOUT_MS;

    send_arm_ack(nonce, channel, action);
}

/* ── FIRE handler ──────────── per INTERFACE_SPEC §7.2 ────────── */
/* CMD_FIRE (13 bytes): [0]=0x81 [1]=0xCA [2]=0x5A [3-4]=nonce    */
/* [5]=channel [6]=duration(u8) [7]=~channel [8]=~duration         */
/* [9-12]=CRC-32(0..8)                                             */
void cac_handle_fire(const uint8_t *data, int len)
{
    if (len < SIZE_CMD_FIRE) return;

    if (data[1] != CAC_MAGIC_1 || data[2] != CAC_MAGIC_2) return;

    /* Complement checks: channel and duration */
    if ((data[5] ^ data[7]) != 0xFF) return;
    if ((data[6] ^ data[8]) != 0xFF) return;

    /* CRC-32 over bytes 0-8 */
    uint32_t received_crc = get_le32(&data[9]);
    if (crc32_hw_compute(data, 9) != received_crc) return;

    uint16_t nonce       = get_le16(&data[3]);
    uint8_t  channel     = data[5];
    uint8_t  duration    = data[6];     /* u8 clamped 0–255 */
    uint16_t duration_ms = (uint16_t)duration;

    uint8_t ch1 = channel + 1;

    /* Build flags byte for ACK: bit0=test_mode, bit1=channel_armed */
    uint8_t flags = 0;
    if (s_test_mode) flags |= 0x01;
    if (pyro_mgr_get_arm_bitmap() & (1u << channel)) flags |= 0x02;

    /* Idempotent retry */
    if (s_phase == CAC_AWAITING_CONFIRM && nonce == s_pending_nonce &&
        s_pending_type == PENDING_FIRE) {
        send_fire_ack(nonce, channel, duration, flags);
        return;
    }

    if (nonce <= s_last_seen_nonce) {
        send_nack(nonce, NACK_ERR_NONCE_REPLAY);
        return;
    }
    s_last_seen_nonce = nonce;

    if (channel > 3) {
        send_nack(nonce, NACK_ERR_BAD_STATE);
        return;
    }

    /* FIRE requires test mode */
    if (!s_test_mode) {
        send_nack(nonce, NACK_ERR_NO_TESTMODE);
        return;
    }

    /* FIRE requires channel armed */
    if (!(flags & 0x02)) {
        send_nack(nonce, NACK_ERR_NOT_ARMED);
        return;
    }

    /* FIRE requires continuity */
    if (!pyro_mgr_has_continuity(ch1)) {
        send_nack(nonce, NACK_ERR_NO_CONTINUITY);
        return;
    }

    /* Store pending fire */
    s_phase = CAC_AWAITING_CONFIRM;
    s_pending_nonce = nonce;
    s_pending_type = PENDING_FIRE;
    s_pending_channel = ch1;
    s_pending_duration = duration_ms;
    s_confirm_deadline = HAL_GetTick() + CAC_CONFIRM_TIMEOUT_MS;

    send_fire_ack(nonce, channel, duration, flags);
}

/* ── TESTMODE handler ──── per INTERFACE_SPEC §7.3 ────────────── */
/* CMD_TESTMODE (10 bytes): [0]=0x82 [1]=0xCA [2]=0x5A [3-4]=nonce */
/* [5]=enable [6-9]=CRC-32(0..5)                                    */
void cac_handle_testmode(const uint8_t *data, int len)
{
    if (len < SIZE_CMD_TESTMODE) return;

    if (data[1] != CAC_MAGIC_1 || data[2] != CAC_MAGIC_2) return;

    uint32_t received_crc = get_le32(&data[6]);
    if (crc32_hw_compute(data, 6) != received_crc) return;

    uint16_t nonce  = get_le16(&data[3]);
    uint8_t  enable = data[5];

    if (nonce <= s_last_seen_nonce) {
        send_nack(nonce, NACK_ERR_NONCE_REPLAY);
        return;
    }
    s_last_seen_nonce = nonce;

    if (flight_fsm_get_state() != FSM_STATE_PAD) {
        send_nack(nonce, NACK_ERR_BAD_STATE);
        return;
    }

    if (enable) {
        s_test_mode = true;
        s_test_mode_deadline = HAL_GetTick() + TEST_MODE_TIMEOUT_MS;
        pyro_mgr_set_test_mode(true);
    } else {
        s_test_mode = false;
        pyro_mgr_set_test_mode(false);
    }

    tlm_queue_event(FC_EVT_STATE, (uint16_t)flight_fsm_get_state());
}

/* ── CONFIG POLL handler ─────── per INTERFACE_SPEC §8.4 ─────── */
/* ACK_CONFIG (13 bytes): [0]=0xA3 [1-2]=nonce [3-6]=hash         */
/* [7]=proto_ver [8]=rsvd [9-12]=CRC                               */
void cac_handle_config_poll(const uint8_t *data, int len)
{
    /* Extract nonce from poll command if available (bytes 1-2) */
    uint16_t nonce = 0;
    if (len >= 3) {
        nonce = get_le16(&data[1]);
    }

    uint8_t pkt[SIZE_ACK_CFG];
    pkt[0] = MSG_ID_ACK_CFG;
    put_le16(&pkt[1], nonce);
    uint32_t hash = cfg_get_active_hash();
    put_le32(&pkt[3], hash);
    pkt[7] = PROTOCOL_VERSION;
    pkt[8] = 0x00;              /* reserved */
    uint32_t crc = crc32_hw_compute(pkt, 9);
    put_le32(&pkt[9], crc);
    tlm_send_response(pkt, SIZE_ACK_CFG);
}

/* ── CONFIRM handler ──────────────────────────────────────────── */
void cac_handle_confirm(const uint8_t *data, int len)
{
    /* CONFIRM: [0xF0][0xCA][0x5A][nonce:2][CRC-32:4] = 9 bytes */
    if (len < 9) return;

    if (data[1] != CAC_MAGIC_1 || data[2] != CAC_MAGIC_2) return;

    uint32_t received_crc = get_le32(&data[5]);
    if (crc32_hw_compute(data, 5) != received_crc) return;

    uint16_t nonce = get_le16(&data[3]);

    if (s_phase != CAC_AWAITING_CONFIRM) return;
    if (nonce != s_pending_nonce) return;

    /* Check timeout */
    if ((int32_t)(HAL_GetTick() - s_confirm_deadline) >= 0) {
        s_phase = CAC_IDLE;
        return;
    }

    /* Execute the pending action */
    if (s_pending_type == PENDING_ARM) {
        bool arm = (s_pending_action == CAC_ACTION_ARM);
        pyro_mgr_set_arm(s_pending_channel, arm);
        tlm_queue_event(FC_EVT_ARM, (uint16_t)pyro_mgr_get_arm_bitmap());
    } else if (s_pending_type == PENDING_FIRE) {
        pyro_mgr_fire(s_pending_channel, s_pending_duration);
        tlm_queue_event(FC_EVT_PYRO,
                        (uint16_t)((s_pending_channel << 8) | 0x01));
    }

    s_phase = CAC_IDLE;
}

/* ── ABORT handler ────────────────────────────────────────────── */
void cac_handle_abort(const uint8_t *data, int len)
{
    /* ABORT: [0xF1][0xCA][0x5A][nonce:2][CRC-32:4] = 9 bytes */
    if (len < 9) return;

    if (data[1] != CAC_MAGIC_1 || data[2] != CAC_MAGIC_2) return;

    uint32_t received_crc = get_le32(&data[5]);
    if (crc32_hw_compute(data, 5) != received_crc) return;

    uint16_t nonce = get_le16(&data[3]);

    if (s_phase == CAC_AWAITING_CONFIRM && nonce == s_pending_nonce) {
        s_phase = CAC_IDLE;
    }
}

/* ── Test mode queries ────────────────────────────────────────── */
bool cac_test_mode_active(void)
{
    return s_test_mode;
}

uint32_t cac_test_mode_remaining_ms(void)
{
    if (!s_test_mode) return 0;
    uint32_t now = HAL_GetTick();
    if ((int32_t)(now - s_test_mode_deadline) >= 0) return 0;
    return s_test_mode_deadline - now;
}
