AshwinVishwanath/C.A.S.P.E.R.-2/Software/App/diag/logger_sanity.c

/**
 * @file logger_sanity.c
 * @brief CDC-triggered bench harness that runs the flight logger for ~5 s.
 */
#include "logger_sanity.h"

#ifdef LOGGER_SANITY

#include <stdio.h>
#include <string.h>
#include <stdbool.h>
#include "stm32h7xx_hal.h"
#include "main.h"
#include "usbd_cdc_if.h"
#include "buzzer.h"
#include "flight_logger.h"
#include "flight_loop.h"
#include "log_index.h"
#include "w25q512jv.h"
#include "cycle_probe.h"

/* Probe externs from flight_loop.c (one definition per probe lives there) */
extern diag_probe_t probe_superloop;
extern diag_probe_t probe_imu_svc;
extern diag_probe_t probe_imu_read;
extern diag_probe_t probe_att_upd;
extern diag_probe_t probe_ekf_pred;
extern diag_probe_t probe_hr_push;
extern diag_probe_t probe_radio;
extern diag_probe_t probe_mag_rd;
extern diag_probe_t probe_pyro_rd;
extern diag_probe_t probe_log_tick;

#define BOOT_HOLD_MS    3000U
#define LOG_DURATION_MS 5000U
#define EMIT_PERIOD_MS  250U

typedef enum {
    SANITY_BOOT_HOLD = 0,
    SANITY_WAIT_GO,
    SANITY_LOGGING,
    SANITY_FINALIZE,
    SANITY_DONE,
    SANITY_FAIL_DRIVER,    /* w25q512jv_write returned non-OK */
    SANITY_FAIL_SILENT,    /* write OK but readback unchanged — likely BP/WPS */
    SANITY_FAIL_CORRUPT    /* readback differs from both pre and pattern */
} sanity_state_t;

static struct {
    flight_logger_t *log;
    sanity_state_t   state;
    uint32_t         t_init_ms;
    uint32_t         t_launch_ms;
    uint32_t         t_last_emit_ms;
    uint32_t         t_last_probe_ms;
    bool             waitgo_banner_sent;
    bool             cal_announced;
} S;

static void emit(const char *s);  /* forward decl */

static void emit_probes(uint32_t now_ms)
{
    uint32_t elapsed = now_ms - S.t_last_probe_ms;
    if (elapsed == 0) elapsed = 1;
    emit("[CYC] ----- 1-second window -----\r\n");
    diag_probe_emit("superloop", &probe_superloop, elapsed);
    diag_probe_emit("imu_svc",   &probe_imu_svc,   elapsed);
    diag_probe_emit("imu_read",  &probe_imu_read,  elapsed);
    diag_probe_emit("att_upd",   &probe_att_upd,   elapsed);
    diag_probe_emit("ekf_pred",  &probe_ekf_pred,  elapsed);
    diag_probe_emit("hr_push",   &probe_hr_push,   elapsed);
    diag_probe_emit("radio",     &probe_radio,     elapsed);
    diag_probe_emit("mag_rd",    &probe_mag_rd,    elapsed);
    diag_probe_emit("pyro_rd",   &probe_pyro_rd,   elapsed);
    diag_probe_emit("log_tick",  &probe_log_tick,  elapsed);
    S.t_last_probe_ms = now_ms;
}

static void leds_set(bool l1, bool l2, bool l3, bool l4)
{
    HAL_GPIO_WritePin(CONT_YN_1_GPIO_Port, CONT_YN_1_Pin, l1 ? GPIO_PIN_SET : GPIO_PIN_RESET);
    HAL_GPIO_WritePin(CONT_YN_2_GPIO_Port, CONT_YN_2_Pin, l2 ? GPIO_PIN_SET : GPIO_PIN_RESET);
    HAL_GPIO_WritePin(CONT_YN_3_GPIO_Port, CONT_YN_3_Pin, l3 ? GPIO_PIN_SET : GPIO_PIN_RESET);
    HAL_GPIO_WritePin(CONT_YN_4_GPIO_Port, CONT_YN_4_Pin, l4 ? GPIO_PIN_SET : GPIO_PIN_RESET);
}

static void emit(const char *s)
{
    uint16_t len = 0;
    while (s[len] != '\0') len++;
    CDC_Transmit_FS((uint8_t *)s, len);
}

static void emit_hex16(const char *prefix, const uint8_t *buf)
{
    char line[96];
    int n = snprintf(line, sizeof(line),
        "%s %02x %02x %02x %02x %02x %02x %02x %02x  "
        "%02x %02x %02x %02x %02x %02x %02x %02x\r\n",
        prefix,
        buf[0], buf[1], buf[2],  buf[3],  buf[4],  buf[5],  buf[6],  buf[7],
        buf[8], buf[9], buf[10], buf[11], buf[12], buf[13], buf[14], buf[15]);
    if (n > 0) CDC_Transmit_FS((uint8_t *)line, (uint16_t)n);
}

/* Sector-0 write probe.
 *
 * Reads 16 bytes at flash 0x00000000, writes a known pattern, reads back,
 * compares. Reports verdict via CDC + sets the sanity state to either
 * BOOT_HOLD (probe passed) or one of the FAIL states (probe failed). Uses
 * HAL_Delay between prints so the human watching a serial terminal sees
 * each step. Runs once during init.
 */
static sanity_state_t do_sector0_probe(flight_logger_t *log)
{
    static const uint8_t pattern[16] = {
        0xA5, 0x5A, 0xA5, 0x5A, 0xA5, 0x5A, 0xA5, 0x5A,
        0xA5, 0x5A, 0xA5, 0x5A, 0xA5, 0x5A, 0xA5, 0x5A
    };
    uint8_t pre[16]  = {0};
    uint8_t post[16] = {0};
    char line[96];
    int n;

    HAL_Delay(200);
    emit("\r\n[PROBE] sector-0 write probe starting\r\n");
    HAL_Delay(200);

    /* Erase sector 0 first so the test is conclusive: writing the pattern
     * onto a guaranteed-0xFF baseline genuinely exercises the write path.
     * Also clears any partial / stale index data left by previous runs. */
    emit("[PROBE] erasing sector 0 (4 KB)...\r\n");
    HAL_Delay(100);
    int erc = w25q512jv_erase_sector(log->index.flash, 0x00000000U);
    n = snprintf(line, sizeof(line),
        "[PROBE] erase_sector returned: %d (W25Q_OK=%d)\r\n", erc, W25Q_OK);
    if (n > 0) CDC_Transmit_FS((uint8_t *)line, (uint16_t)n);
    HAL_Delay(200);
    if (erc != W25Q_OK) {
        emit("[PROBE] verdict: FAIL — erase driver error\r\n");
        HAL_Delay(300);
        return SANITY_FAIL_DRIVER;
    }

    int rc = w25q512jv_read(log->index.flash, 0x00000000U, pre, 16);
    if (rc != W25Q_OK) {
        n = snprintf(line, sizeof(line),
            "[PROBE] FAIL: pre-read driver error %d\r\n", rc);
        if (n > 0) CDC_Transmit_FS((uint8_t *)line, (uint16_t)n);
        return SANITY_FAIL_DRIVER;
    }
    emit_hex16("[PROBE] pre: ", pre);
    HAL_Delay(200);

    bool pre_all_ff = true;
    for (int i = 0; i < 16; i++) {
        if (pre[i] != 0xFF) { pre_all_ff = false; break; }
    }
    if (!pre_all_ff) {
        emit("[PROBE] FAIL: sector 0 not erased after erase command\r\n");
        HAL_Delay(300);
        return SANITY_FAIL_DRIVER;
    }

    emit("[PROBE] writing pattern A5 5A x8 at 0x00000000\r\n");
    HAL_Delay(200);
    rc = w25q512jv_write(log->index.flash, 0x00000000U, pattern, 16);
    n = snprintf(line, sizeof(line),
        "[PROBE] w25q512jv_write returned: %d (W25Q_OK=%d)\r\n",
        rc, W25Q_OK);
    if (n > 0) CDC_Transmit_FS((uint8_t *)line, (uint16_t)n);
    HAL_Delay(200);

    if (rc != W25Q_OK) {
        emit("[PROBE] verdict: FAIL — driver error\r\n");
        HAL_Delay(300);
        return SANITY_FAIL_DRIVER;
    }

    int rrc = w25q512jv_read(log->index.flash, 0x00000000U, post, 16);
    if (rrc != W25Q_OK) {
        n = snprintf(line, sizeof(line),
            "[PROBE] post-read driver error %d\r\n", rrc);
        if (n > 0) CDC_Transmit_FS((uint8_t *)line, (uint16_t)n);
        return SANITY_FAIL_DRIVER;
    }
    emit_hex16("[PROBE] post:", post);
    HAL_Delay(200);

    if (memcmp(post, pattern, 16) == 0) {
        emit("[PROBE] verdict: PASS - sector 0 write works\r\n");
        HAL_Delay(200);

        /* Cleanup: erase sector 0 again so we leave no trace. Otherwise the
         * probe pattern gets miscounted as a "flight" on next boot's
         * flight_logger_init() index scan, and log_index_start_flight() then
         * writes the real entry to a wrong offset. */
        emit("[PROBE] cleanup: erasing sector 0 again\r\n");
        HAL_Delay(100);
        int crc = w25q512jv_erase_sector(log->index.flash, 0x00000000U);
        n = snprintf(line, sizeof(line),
            "[PROBE] cleanup erase returned: %d\r\n", crc);
        if (n > 0) CDC_Transmit_FS((uint8_t *)line, (uint16_t)n);
        HAL_Delay(200);

        /* Re-scan the now-erased index. flight_logger_init() ran at boot
         * before the probe and may have miscounted previous-run probe
         * pattern as flights. log_index_init() resets flight_count,
         * current_flight, and (importantly) hr_next_addr / lr_next_addr /
         * adxl_next_addr to clean BASE addresses. */
        bool ii_ok = log_index_init(&log->index, log->index.flash);
        n = snprintf(line, sizeof(line),
            "[PROBE] log_index_init: %s, flight_count=%u, hr_next=0x%08lx\r\n",
            ii_ok ? "ok" : "FAIL",
            (unsigned)log->index.flight_count,
            (unsigned long)log->index.hr_next_addr);
        if (n > 0) CDC_Transmit_FS((uint8_t *)line, (uint16_t)n);
        HAL_Delay(300);

        return SANITY_BOOT_HOLD;
    }
    if (memcmp(post, pre, 16) == 0) {
        emit("[PROBE] verdict: FAIL — silent write (likely BP/WPS bits)\r\n");
        HAL_Delay(500);
        return SANITY_FAIL_SILENT;
    }
    emit("[PROBE] verdict: FAIL — corruption (post != pattern AND post != pre)\r\n");
    HAL_Delay(500);
    return SANITY_FAIL_CORRUPT;
}

void logger_sanity_init(flight_logger_t *log)
{
    S.log = log;
    S.t_launch_ms = 0;
    S.t_last_emit_ms = 0;
    S.t_last_probe_ms = 0;
    S.waitgo_banner_sent = false;
    S.cal_announced = false;

    S.state = do_sector0_probe(log);
    S.t_init_ms = HAL_GetTick();   /* anchor BOOT_HOLD after probe completes */
}

void logger_sanity_tick(uint32_t now_ms)
{
    if (S.log == NULL) return;

    switch (S.state) {
    case SANITY_BOOT_HOLD: {
        bool on = ((now_ms / 500U) & 1U) != 0U;
        leds_set(on, false, false, false);
        if ((now_ms - S.t_init_ms) >= BOOT_HOLD_MS) {
            S.state = SANITY_WAIT_GO;
        }
        break;
    }

    case SANITY_WAIT_GO: {
        if (!S.waitgo_banner_sent) {
            emit("[SANITY] waiting for calibration to complete (~30s after boot)\r\n");
            emit("[SANITY] then type 'go' to start logging (no Enter required)\r\n");
            S.waitgo_banner_sent = true;
        }
        bool on = ((now_ms / 125U) & 1U) != 0U;
        leds_set(on, false, false, false);
        bool cal = flight_loop_is_cal_done();
        if (!cal) {
            /* Drain any "go" the user typed early so it doesn't fire the
             * instant cal_done flips true. */
            (void)cdc_sanity_take_go();
            break;
        }
        if (!S.cal_announced) {
            emit("[SANITY] calibration done - ready, type 'go' now\r\n");
            S.cal_announced = true;
        }
        if (cdc_sanity_take_go()) {
            emit("[SANITY] GO detected - calling flight_logger_launch...\r\n");
            HAL_Delay(50);
            flight_logger_launch(S.log);
            S.t_launch_ms = HAL_GetTick();
            S.t_last_emit_ms = S.t_launch_ms;
            S.t_last_probe_ms = S.t_launch_ms;
            emit("[SANITY] launch returned - logging for 5s\r\n");
            buzzer_beep_n(30, 1, 300, 500);
            leds_set(true, true, true, false);
            S.state = SANITY_LOGGING;
        }
        break;
    }

    case SANITY_LOGGING: {
        leds_set(true, true, true, false);
        if ((now_ms - S.t_last_emit_ms) >= EMIT_PERIOD_MS) {
            S.t_last_emit_ms = now_ms;
            float t = (float)(now_ms - S.t_launch_ms) / 1000.0f;
            unsigned long hr = (unsigned long)flight_logger_hr_records(S.log);
            unsigned long lr = (unsigned long)flight_logger_lr_records(S.log);
            unsigned long hrc = (unsigned long)flight_logger_diag_hr_calls();
            unsigned long lrc = (unsigned long)flight_logger_diag_lr_calls();
            extern volatile uint32_t g_imu_exti_fires;
            extern volatile uint32_t g_imu_wd_polls;
            extern volatile uint32_t g_imu_wd_hits;
            unsigned long ext = (unsigned long)g_imu_exti_fires;
            unsigned long wdp = (unsigned long)g_imu_wd_polls;
            unsigned long wdh = (unsigned long)g_imu_wd_hits;
            char buf[180];
            int len = snprintf(buf, sizeof(buf),
                               ">t:%.1f,hr:%lu,lr:%lu,hrc:%lu,lrc:%lu,"
                               "ext:%lu,wdp:%lu,wdh:%lu\r\n",
                               (double)t, hr, lr, hrc, lrc, ext, wdp, wdh);
            if (len > 0) CDC_Transmit_FS((uint8_t *)buf, (uint16_t)len);
        }
        /* Cycle-probe dump every ~1 s. */
        if ((now_ms - S.t_last_probe_ms) >= 1000U) {
            emit_probes(now_ms);
        }
        if ((now_ms - S.t_launch_ms) >= LOG_DURATION_MS) {
            S.state = SANITY_FINALIZE;
        }
        break;
    }

    case SANITY_FINALIZE: {
        flight_logger_finalize(S.log);
        emit("[SANITY] FINALIZE\r\n");
        HAL_GPIO_TogglePin(CONT_YN_1_GPIO_Port, CONT_YN_1_Pin);
        HAL_GPIO_TogglePin(CONT_YN_2_GPIO_Port, CONT_YN_2_Pin);
        HAL_GPIO_TogglePin(CONT_YN_3_GPIO_Port, CONT_YN_3_Pin);
        emit("[SANITY] DONE - power-cycle and decode flash\r\n");
        buzzer_beep_n(30, 3, 50, 200);
        S.state = SANITY_DONE;
        break;
    }

    case SANITY_DONE: {
        bool on = ((now_ms / 500U) & 1U) != 0U;
        leds_set(on, on, on, on);
        break;
    }

    case SANITY_FAIL_DRIVER: {
        /* LED2+LED3 alternating 4 Hz forever */
        bool on = ((now_ms / 125U) & 1U) != 0U;
        leds_set(false, on, !on, false);
        break;
    }

    case SANITY_FAIL_SILENT: {
        /* LED1+LED4 alternating 4 Hz forever */
        bool on = ((now_ms / 125U) & 1U) != 0U;
        leds_set(on, false, false, !on);
        break;
    }

    case SANITY_FAIL_CORRUPT:
    default: {
        /* All 4 LEDs alternating 4 Hz forever */
        bool on = ((now_ms / 125U) & 1U) != 0U;
        leds_set(on, on, on, on);
        break;
    }
    }
}

#else  /* !LOGGER_SANITY */

void logger_sanity_init(flight_logger_t *log)  { (void)log; }
void logger_sanity_tick(uint32_t now_ms)       { (void)now_ms; }

#endif /* LOGGER_SANITY */
