AshwinVishwanath/C.A.S.P.E.R.-2/Software/App/pyro/casper_pyro.h

/* ============================================================
 *  TIER:     SAFETY-CRITICAL
 *  MODULE:   Pyro HAL
 *  SUMMARY:  Low-level pyro pin/ADC access. Driven only by Pyro Manager.
 * ============================================================ */
#ifndef CASPER_PYRO_H
#define CASPER_PYRO_H

#include "stm32h7xx_hal.h"
#include <stdint.h>
#include <stdbool.h>

#define PYRO_NUM_CHANNELS          4
#define PYRO_CONTINUITY_THRESHOLD  8000   /* 16-bit ADC; tune empirically */
#define PYRO_DEFAULT_FIRE_MS       1000   /* 1 second default fire pulse  */

/* CONT4 hardware-shorted to battery sense via 100k/62k divider.
 * Channel 4 reads Vbatt; arming/firing CH4 is rejected in pyro_manager.
 * Vbatt = (adc / 65535) * 3.3 * (R1 + R2) / R2 */
#define CONT4_DIVIDER_R1   100000.0f   /* high-side, ohms */
#define CONT4_DIVIDER_R2    62000.0f   /* low-side, ohms  */
#define ADC_VREF_V              3.3f
#define ADC_FULL_SCALE      65535.0f

typedef struct {
    /* State */
    bool     continuity[PYRO_NUM_CHANNELS];
    uint16_t adc_raw[PYRO_NUM_CHANNELS];
    bool     firing[PYRO_NUM_CHANNELS];
    uint32_t fire_start_ms[PYRO_NUM_CHANNELS];
    uint32_t fire_duration_ms[PYRO_NUM_CHANNELS];

    /* Hardware handles (set during init) */
    ADC_HandleTypeDef *hadc1;   /* channels 1 & 2 (ADC1 CH4/CH3) */
    ADC_HandleTypeDef *hadc2;   /* channel 4      (ADC2 CH10)    */
    ADC_HandleTypeDef *hadc3;   /* channel 3      (ADC3 CH1)     */
} casper_pyro_t;

/* Init: store ADC handles, calibrate ADCs, force all pyros OFF */
void casper_pyro_init(casper_pyro_t *p,
                      ADC_HandleTypeDef *hadc1,
                      ADC_HandleTypeDef *hadc2,
                      ADC_HandleTypeDef *hadc3);

/* Fire channel ch (0-3) for duration_ms.  Returns false if ch invalid. */
bool casper_pyro_fire(casper_pyro_t *p, uint8_t ch, uint32_t duration_ms);

/* Immediately stop one channel */
void casper_pyro_stop(casper_pyro_t *p, uint8_t ch);

/* Stop all channels */
void casper_pyro_stop_all(casper_pyro_t *p);

/* Periodic tick (~10 Hz): read ADCs, update continuity + LEDs, auto-stop expired fires */
void casper_pyro_tick(casper_pyro_t *p);

/* Read battery voltage via CONT4 ADC divider (adc_raw[3] populated by tick) */
float casper_pyro_get_batt_voltage(const casper_pyro_t *p);

#endif /* CASPER_PYRO_H */
