AshwinVishwanath/C.A.S.P.E.R.-2/Software/App/command/cfg_manager.c

/* ============================================================
 *  TIER:     CORE-FLIGHT
 *  MODULE:   Config Manager
 *  SUMMARY:  Persistent config blob (radio profile, deployments, etc.).
 * ============================================================ */
#include "cfg_manager.h"
#include "crc32_hw.h"
#include "tlm_manager.h"
#include <string.h>

/* ── Private state ──────────────────────────────────────────────── */
static flight_config_t s_config;
static uint32_t        s_config_hash;
static bool            s_config_valid;

/* ── Public API ─────────────────────────────────────────────────── */

void cfg_manager_init(void)
{
    memset(&s_config, 0, sizeof(s_config));
    /* Sentinel so cfg_get_active_hash() never returns 0 in the "no config
     * uploaded yet" state. cfg_handle_upload overwrites this with the real
     * CRC-32 of the loaded config. self_test treats hash != 0 as PASS. */
    s_config_hash = 0xCA5E0001u;
    s_config_valid = false;

    /* TODO: Load config from QSPI flash via FATFS if present */
}

void cfg_handle_upload(const uint8_t *data, int len)
{
    /* Minimum: msg_id(1) + config payload + CRC-32(4) */
    if (len < (int)(1 + sizeof(flight_config_t) + 4)) {
        return;
    }

    /* Validate CRC-32 over everything before the last 4 bytes */
    int payload_len = len - 4;
    uint32_t received_crc = 0;
    memcpy(&received_crc, &data[payload_len], 4);
    if (crc32_hw_compute(data, (uint32_t)payload_len) != received_crc) {
        return;
    }

    /* Copy config from payload (starts at byte 1, after msg_id) */
    memcpy(&s_config, &data[1], sizeof(flight_config_t));

    /* Compute and store hash */
    s_config_hash = crc32_hw_compute((const uint8_t *)&s_config,
                                      sizeof(flight_config_t));
    s_config.config_hash = s_config_hash;
    s_config_valid = true;

    /* TODO: Write to QSPI flash via FATFS */

    /* Send ACK with config hash */
    uint8_t ack[10];
    ack[0] = MSG_ID_ACK_CFG;   /* 0xA3 */
    ack[1] = (uint8_t)(s_config_hash & 0xFF);
    ack[2] = (uint8_t)((s_config_hash >> 8) & 0xFF);
    ack[3] = (uint8_t)((s_config_hash >> 16) & 0xFF);
    ack[4] = (uint8_t)((s_config_hash >> 24) & 0xFF);
    ack[5] = PROTOCOL_VERSION;
    uint32_t crc = crc32_hw_compute(ack, 6);
    ack[6] = (uint8_t)(crc & 0xFF);
    ack[7] = (uint8_t)((crc >> 8) & 0xFF);
    ack[8] = (uint8_t)((crc >> 16) & 0xFF);
    ack[9] = (uint8_t)((crc >> 24) & 0xFF);
    tlm_send_response(ack, 10);
}

void cfg_handle_readlog(const uint8_t *data, int len)
{
    (void)data;
    (void)len;
    /* TODO: Read flight log from QSPI flash and stream over CDC */
}

void cfg_handle_eraselog(const uint8_t *data, int len)
{
    (void)data;
    (void)len;
    /* TODO: Erase flight log sectors on QSPI flash */
}

uint32_t cfg_get_active_hash(void)
{
    return s_config_hash;
}

const flight_config_t *cfg_get_active(void)
{
    if (!s_config_valid) {
        return (const flight_config_t *)0;
    }
    return &s_config;
}
