AshwinVishwanath/C.A.S.P.E.R.-2/Software/App/pyro/pyro_manager.c

/* ============================================================
 *  TIER:     SAFETY-CRITICAL
 *  MODULE:   Pyro Manager
 *  SUMMARY:  Per-channel arm/continuity/FSM-gated firing.
 * ============================================================ */
#include "pyro_manager.h"
#include "casper_pyro.h"
#include "flight_fsm.h"
#include "tlm_types.h"
#include "stm32h7xx_hal.h"
#include "fsm_types.h"

extern int tlm_queue_event(uint8_t type, uint16_t data);

/* ── Private state ──────────────────────────────────────────────── */
static casper_pyro_t pyro;
static bool s_armed[PYRO_MGR_NUM_CHANNELS];
static bool s_test_mode;

/* ── PAD lockout (FSM_TRANSITION_SPEC §6.1) ────────────────────── */
#define PYRO_PAD_LOCKOUT() \
    do { if (flight_fsm_get_state() == FSM_STATE_PAD) return -1; } while(0)

/* ── Channel exclusion (FSM_TRANSITION_SPEC §6.2) ──────────────── */
static inline bool pyro_ch_excluded(uint8_t ch)
{
    return (PYRO_EXCLUDE_MASK >> ch) & 1;
}

void pyro_mgr_init(ADC_HandleTypeDef *hadc1,
                    ADC_HandleTypeDef *hadc2,
                    ADC_HandleTypeDef *hadc3)
{
    casper_pyro_init(&pyro, hadc1, hadc2, hadc3);
    for (int i = 0; i < PYRO_MGR_NUM_CHANNELS; i++) {
        s_armed[i] = false;
    }
    s_test_mode = false;
}

void pyro_mgr_tick(void)
{
    /* Delegate to low-level driver for ADC reads, LED updates, auto-stop */
    casper_pyro_tick(&pyro);
}

int pyro_mgr_set_arm(uint8_t channel, bool armed)
{
    if (channel < 1 || channel > PYRO_MGR_NUM_CHANNELS) {
        return -1;
    }
    if (channel == 4) return -1;  /* CH4 hardware-shorted to Vbatt sense; never armable */
    uint8_t idx = channel - 1;

    if (armed) {
        /* Precondition: must have continuity to arm */
        if (!pyro.continuity[idx]) {
            return -1;
        }
    } else {
        /* Disarming: stop any active fire on this channel */
        if (pyro.firing[idx]) {
            casper_pyro_stop(&pyro, idx);
        }
    }

    s_armed[idx] = armed;
    return 0;
}

bool pyro_mgr_has_continuity(uint8_t channel)
{
    if (channel < 1 || channel > PYRO_MGR_NUM_CHANNELS) {
        return false;
    }
    return pyro.continuity[channel - 1];
}

int pyro_mgr_fire(uint8_t channel, uint16_t duration_ms)
{
    if (channel < 1 || channel > PYRO_MGR_NUM_CHANNELS) {
        return -1;
    }
    uint8_t idx = channel - 1;

    /* Must be armed */
    if (!s_armed[idx]) {
        return -1;
    }

    /* Must have continuity */
    if (!pyro.continuity[idx]) {
        return -1;
    }

    /* CAC path: test mode required */
    if (!s_test_mode) {
        return -1;
    }

    /* Cap duration */
    uint32_t dur = duration_ms;
    if (dur > PYRO_MAX_FIRE_MS) {
        dur = PYRO_MAX_FIRE_MS;
    }

    /* In test mode, cap to 50ms for safety */
    if (s_test_mode && dur > 50) {
        dur = 50;
    }

    /* Fire via low-level driver (0-indexed) */
    if (!casper_pyro_fire(&pyro, idx, dur)) {
        return -1;
    }

    return 0;
}

uint8_t pyro_mgr_get_arm_bitmap(void)
{
    uint8_t bm = 0;
    for (int i = 0; i < PYRO_MGR_NUM_CHANNELS; i++) {
        if (s_armed[i]) {
            bm |= (uint8_t)(1u << i);
        }
    }
    return bm;
}

uint8_t pyro_mgr_get_cont_bitmap(void)
{
    uint8_t bm = 0;
    for (int i = 0; i < PYRO_MGR_NUM_CHANNELS; i++) {
        if (pyro.continuity[i]) {
            bm |= (uint8_t)(1u << i);
        }
    }
    return bm;
}

bool pyro_mgr_is_firing(void)
{
    for (int i = 0; i < PYRO_MGR_NUM_CHANNELS; i++) {
        if (pyro.firing[i]) {
            return true;
        }
    }
    return false;
}

void pyro_mgr_disarm_all(void)
{
    casper_pyro_stop_all(&pyro);
    for (int i = 0; i < PYRO_MGR_NUM_CHANNELS; i++) {
        s_armed[i] = false;
    }
}

void pyro_mgr_set_test_mode(bool enable)
{
    s_test_mode = enable;
    if (!enable) {
        pyro_mgr_disarm_all();
    }
}

bool pyro_mgr_is_test_mode(void)
{
    return s_test_mode;
}

void pyro_mgr_auto_arm_flight(void)
{
    for (uint8_t ch = 0; ch < PYRO_MGR_NUM_CHANNELS; ch++) {
        if (pyro_ch_excluded(ch)) continue;
        if (!pyro.continuity[ch]) continue;
        if (s_armed[ch]) continue;              /* already armed */

        s_armed[ch] = true;
        tlm_queue_event(FC_EVT_ARM,
                        ((uint16_t)ch << 8) | 0x01);   /* auto-arm event */
    }
}

void pyro_mgr_get_cont_adc(uint16_t adc_out[4])
{
    for (int i = 0; i < PYRO_MGR_NUM_CHANNELS; i++)
        adc_out[i] = pyro.adc_raw[i];
}

float pyro_mgr_get_batt_voltage(void)
{
    return casper_pyro_get_batt_voltage(&pyro);
}

int pyro_mgr_auto_fire(uint8_t ch, uint16_t duration_ms)
{
    /* Hard safety: never fire on pad */
    PYRO_PAD_LOCKOUT();

    /* Preconditions */
    if (ch >= PYRO_MGR_NUM_CHANNELS) return -1;
    if (pyro_ch_excluded(ch)) return -1;
    if (!s_armed[ch]) return -1;
    if (!pyro.continuity[ch]) return -1;
    if (pyro.firing[ch]) return -1;

    /* Cap duration */
    if (duration_ms > PYRO_MAX_FIRE_MS) duration_ms = PYRO_MAX_FIRE_MS;

    casper_pyro_fire(&pyro, ch, duration_ms);
    tlm_queue_event(FC_EVT_PYRO,
                    ((uint16_t)ch << 8) | (duration_ms & 0xFF));
    return 0;
}
