AshwinVishwanath/C.A.S.P.E.R.-2/(commit log)

2025-11-02 Refactor README.md for clarity and conciseness
    Removed redundant bullet points and improved clarity in sections related to power management, pyro channels, actuation, and PCB design.
2025-11-03 Uploaded Schematic diagrams
2025-11-17 Updated Schematic Diagrams
    Changed:
    Magnetometer wiring
    Removed GPS Bias Tee
    Removed CLCLC filter from LoRa path
    Modified part values and wiring for PDN
2025-11-17 Added PCB Prints
2025-11-17 Changed Schematic prints to colour
2026-02-06 Fix power supply config, enable USB CDC, and bring-up milestone LEDs
    Fixed critical boot hang caused by USE_PWR_EXTERNAL_SOURCE_SUPPLY -- the
    board uses the internal LDO, so ExitRun0Mode() in startup assembly would
    wait forever for an external voltage ready flag that never asserts.
    Changed to USE_PWR_LDO_SUPPLY in both Makefile and SystemClock_Config().
    SystemClock_Config() is temporarily disabled due to HSE/PLL lock failure
    (960 MHz VCO at absolute max of wide range). MCU runs on HSI 64 MHz.
    USB CDC uses HSI48 internal oscillator instead of PLL1Q for 48 MHz clock.
    Added 4 milestone LEDs during init, sequential LED chase pattern, and
    USB CDC serial output every 5s. See DEV_UPDATE.md for fu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
    [main.c]
2026-02-07 implemented barometer and IMU drivers, added barometer and IMU data to USB output, updated documentation but LSM6DSO32 IMU is not working yet
    [lsm6dso32.c, lsm6dso32.h, main.c, ms5611.c, ms5611.h]
2026-02-07 Fix SPI2 IMU burst reads
    [lsm6dso32.c, main.c]
2026-02-07 Fix SPI2 CS pin (PD15→PC14), re-apply fixes after CubeMX regen
    Root cause of LSM6DSO32 returning all zeros: CubeMX had SPI2_CS
    assigned to PD15, but the PCB routes CS to PC14. Corrected in CubeMX
    and regenerated. Re-applied all manual workarounds:
    - SystemClock_Config: HSI+PLL (HSE crystal dead) → 432MHz SYSCLK
    - PeriphCommonClock_Config: PLL2 for HSI + UART4 clock
    - SPI2/SPI4: DataSize 8-bit, correct BaudRatePrescaler
    - SPI2 Mode 3 (CPOL=1, CPHA=1), MasterKeepIOState, NSSPMode
    - SPI2_CS initial level HIGH, PC2 MODER fix
    - LSM6DSO32 INT2 routing (INT1 NC on PCB)
    - EXTI callback: RADIO_INT_Pin → SPI2_INT_Pin
    - Removed SPI2 diagnostic code (bit-bang, MODER dump)
    Updated DEV_UPDATE.md a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
    [lsm6dso32.c, main.c, main.h]
2026-02-10 Add EKF nav stack, sensor drivers, MATLAB analysis; remove data_collect
    Rev 3a: ADXL372 high-g accel (SPI3), W25Q512JV QSPI flash, FATFS,
    USB MSC mode, USB_MODE compile-time switching (1=CDC, 2=MSC).
    Rev 3b: MATLAB Allan variance pipeline for sensor noise
    characterization — gyro ARW, accel VRW/BI, baro altitude sigma.
    Rev 3c: 4-state vertical EKF (alt/vel/accel_bias/baro_bias),
    RK4 gyro quaternion integrator, CMSIS-DSP matrix ops, 500Hz predict,
    async baro update, 50Hz USB output (alt, vel, roll, pitch, yaw).
    Removed data_collect framework (USB_MODE=3, DATA_PHASE) — noise
    characterization is complete and parameters are baked into the EKF.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
    [BARO_HI.CSV, BARO_LO.CSV, BARO_MD.CSV, SimulinkDataFile.csv]
2026-02-11 Add GPS, magnetometer, attitude estimator; replace gyro dead-reckoning
    New sensor drivers:
    - MAX-M10M GPS on I2C1: 10Hz UBX-NAV-PVT, non-blocking poll, EKF stubs
    - MMC5983MA magnetometer on I2C3: 100Hz continuous, 18-bit, auto SET/RESET
    - Mag calibration (mag_cal) and validation (mag_val) modules with CSV logging
    Attitude estimator (casper_attitude.c/h):
    - Replaces pure gyro dead-reckoning (casper_gyro_int) in the build
    - Mahony complementary filter (accel+gyro+mag) on pad
    - RK4 gyro propagation with 10Hz tilt-compensated mag correction in flight
    - Static init: 500 mag samples for initial quaternion + mag reference
    - Gyro bias estimation (running average, frozen at transition)
    - Ignition ga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
    [MAG_CAL.CSV, MAG_Cal_STAT.CSV, MAG_VAL.CSV]
2026-02-13 Add pyro channels, toggle-gated telemetry, CDC receive; reorganize plots
    - Add casper_pyro driver: 4 channels with ADC continuity sensing, MOSFET
    fire control, auto-stop timers, and continuity LED indicators
    - Replace hardcoded attitude output with compile-time toggle system
    (OUT_ATTITUDE, OUT_EKF, OUT_GPS, OUT_MAG, OUT_IMU_RAW, OUT_BARO)
    - Add CDC receive support (cdc_rx_ready/cdc_rx_len) for serial commands
    - Replace MSC LED ping-pong with pyro continuity tick at 10 Hz
    - Move analysis plots into Matlab Code/plots/ directory
    [casper_pyro.c, casper_pyro.h, main.c]
2026-02-15 Add IMU temp comp, axis remapping, mission control webapp; update gitignore
    - Read LSM6DSO32 die temperature and add gyro temp compensation (linear slope model)
    - Remap sensor axes to vehicle body frame (Xv=Zs, Yv=Xs, Zv=Ys)
    - Add mission control React/Vite webapp (casper-mc-local/) with gitignore for node_modules
    - Update telemetry format: named fields, comma separators, IMU temp output
    - Move .mat files to Matlab Code/ directory
2026-02-16 Add msgset v5 telemetry protocol for MC bench testing over USB CDC
    11 new firmware modules in App/ enable the FC to speak binary COBS-framed
    telemetry (10Hz FAST, GPS, EVENT packets) and accept commands (ARM, FIRE,
    TESTMODE, SIM_FLIGHT, HANDSHAKE, DIAG) via the CAC 3-phase confirm protocol.
    Includes 12-state flight FSM with scripted sim flight, pyro manager wrapping
    casper_pyro with arm state/safety interlocks, and HW CRC-32 (standard reflected).
    CDC RX upgraded from flag-based to 256-byte SPSC ring buffer. Build: 87.7KB, 0 warnings.
2026-02-17 Fix PRD conformance bugs, add EKF diagnostic LEDs, add spec docs
    - Fix 5 PRD conformance issues: SIZE_NACK, CDC_OUTPUT conflict,
    FC_EVT_APOGEE emission, pyro FSM safety check, superloop pin override
    - Fix testmode handler: send NACK on bad state, emit EVENT on toggle
    - Fix FC_MSG_FAST STATUS bitmap, ALT_SCALE 10->1m, packet field sizes
    - Add EKF heartbeat LED (LED1 1Hz blink) and baro-fed indicator (LED4)
    - Add 6 firmware specification documents (EKF, sensor, hardware,
    pyro, orientation, interface specs)
    [cac_handler.c, flight_fsm.c, main.c, pyro_manager.c, tlm_manager.c, tlm_types.h]
2026-02-22 Rev 5: EKF rewrite, file reorg, identity mapping, consolidated docs
    Navigation stack:
    - Clean-sheet EKF rewrite: generic Joseph-form scalar update with
    chi-squared innovation gate, ZUPT pseudo-measurement, 416 Hz
    decimated predict with trapezoidal averaging, step-inflated R
    post Mach-gate, bias reset + P inflation at ungate
    - Identity sensor-to-body mapping (body = sensor, no axis permutation)
    - Magnetometer corrections disabled (Kp_mag = 0.0) pending field cal
    - ADXL372 wake-up mode in PAD, full measurement on launch
    - Optional gyro temperature compensation (GYRO_TEMP_COMP define)
    File reorganization:
    - Drivers: Core/Src → App/drivers/ (lsm6dso32, adxl372, ms5611,
    w25q512jv, max_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
    [adxl372.c, adxl372.h, app_globals.h, cac_handler.c, casper_attitude.c, casper_attitude.h, casper_ekf.c, casper_ekf.h]
2026-02-24 Add SX1276 LoRa radio driver, buzzer, reorganize docs
    - Add SX1276 LoRa radio driver (SPI1) with register-level non-blocking
    byte transfers, radio_manager TX/RX state machine (10Hz COBS
    telemetry, profile switching by altitude), and DIO interrupt flags
    - Add piezo buzzer driver using TIM4 PWM with programmable beep sequences
    - Integrate radio telemetry and buzzer into flight loop
    - Fix SPI1 config (DataSize 8-bit, Prescaler 16, NSSP disable)
    - Defer EXTI interrupts (LSM6DSO32 INT2, SX1276 DIO) until after
    peripheral init to prevent ISR hangs
    - Add 5s USB enumeration window with CDC startup debug prints
    - Move PRD docs to Product Requirement Docs/, spec docs to
    Specification Docs/; ad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
    [buzzer.c, buzzer.h, flight_loop.c, main.c, radio_config.h, radio_irq.c, radio_irq.h, radio_manager.c]
2026-02-24 Add Unity test harness and gitignore CSVs
    - Add 3-tier Unity test suite: tier1 unit (EKF, attitude, quat, COBS,
    CRC, MS5611 math, telemetry packing), tier2 protocol (CAC, FSM,
    pyro manager, cmd router, telemetry framing), tier3 integration
    (flight loop, nav pipeline)
    - Add compliance tests (EKF spec, interface spec, pyro spec, sensor
    spec, naming conventions) and regression tests (EKF, attitude)
    - Add HAL stubs/mocks (GPIO, ADC, tick, CMSIS-DSP) for host-side
    builds
    - Add build system (CMakeLists.txt, Makefile, build.sh, run_tests.sh)
    - Gitignore CSVs/ directory, *.csv files, and build_out.txt
2026-02-24 Add Rev 6 section to DEV_UPDATE.md
    Document LoRa radio driver, buzzer, flight loop integration,
    SPI1 fixes, deferred EXTI interrupts, and doc reorganization.
    Update Next Steps checklist.
2026-02-26 Add FSM sensor-driven transitions, pyro safety, ground station, radio config
    FSM (CASPER_FSM_PRD implementation):
    - Sensor-driven state transitions (PAD->BOOST->COAST->APOGEE->MAIN->LANDED->RECOVERY)
    - Dwell timer infrastructure, virtual clock for HIL testing
    - Pyro auto-arm on BOOST entry, auto-fire at apogee/main deploy
    - PAD lockout safety invariant, channel exclusion mask
    - HIL inject handler (0xD1) for MATLAB-in-the-loop testing
    - Flight loop builds fsm_input_t from EKF/attitude state
    - 120 host-side tests across 6 test suites (all passing)
    Radio/Ground:
    - Radio config profiles (A/B), ground station build target
    - Ground station main loop and radio receive handler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
2026-02-26 Rewrite README with accurate specs, system diagrams, and FSM flow
    - Fix hardware inaccuracies (gyro ±2000 dps, SX1276 not SX1262, no dual-bank flash)
    - Replace verbose subsections with grouped specs tables
    - Add system architecture block diagram, FSM state flow diagram, CAC sequence diagram, pyro safety interlock flow
    - Add missing software modules: LoRa radio, calibration modes, CAC protocol
    - Update build size to ~89 KB
    - Centered layout with badges and key capabilities summary
2026-02-27 Add flight data logger with 3-stream QSPI recording
    Implements complete in-flight data logging to the 64MB W25Q512JV QSPI
    NOR flash. Three independent data streams (HR 64B@139Hz, LR 32B@10-50Hz,
    ADXL 10B@800Hz) use a generic ring buffer abstraction with non-blocking
    IT-mode QSPI writes. Pre-launch data is retained via circular ring fill
    during PAD state, then drained to flash on launch detection.
    New modules (App/logging/):
    - log_types.h: packed record structs, flash layout constants, enums
    - log_stream.h/c: generic ring buffer + LOG_IDLE/PAD/DRAIN/FINAL FSM
    - log_index.h/c: flight index management (128 flights, NOR 1->0 update)
    - flight_logger.h/c: top-level API, QSPI dispatch, record pack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
2026-02-27 Add logger test tooling: LED/buzzer indicators, status getters, flash decoder
    - LED2 (PB14): solid when logger launched, fast blink when finalized
    - LED3 (PE8): on when QSPI busy (erasing/writing), off when idle
    - Buzzer milestones: 2 beeps (launch), 3 beeps (apogee), 5 long beeps (landed)
    - Status getter inlines in flight_logger.h for diagnostic access
    - tools/casper_decode.py: Python flash dump decoder with Hamming SECDED,
    CRC16-CCITT, CRC32 validation, FSM state histogram, CSV export
    - tools/send_sim.py: COBS-encoded 0xD0 sim flight command sender
    [casper_decode.py, flight_logger.h, flight_loop.c, send_sim.py]
2026-03-07 Add flash dump protocol, flight readiness doc, and decoder enhancements
    - Add MSG_ID_DUMP_FLASH command to dump raw flash regions over CDC
    - Implement chunked flash dump with ACK protocol in flight_loop
    - Add FLIGHT_READINESS.md documenting system status
    - Expand casper_decode.py with flash dump receiver and binary decoder
    - Fix MSC storage sector count for 64MB flash
    - Add flight_logger status getters and error tracking
    - Update .gitignore for PNG files and __pycache__
    [casper_decode.py, cmd_router.c, cmd_router.h, flight_fsm.c, flight_logger.c, flight_loop.c, main.c, tlm_types.h]
2026-04-07 Add GPS test mode, u24 altitude encoding, and MAX-M10M driver enhancements
    GPS_TEST compile-time mode: NMEA passthrough to CDC with MON-RF antenna
    diagnostics, factory reset init sequence, and airborne dynamic model config.
    Altitude fields upgraded from u16 decametres to u24 centimetres (1 cm
    resolution, 167.7 km max) across FC_MSG_FAST (20->21B) and FC_MSG_GPS
    (17->18B). All packers, decoders, tests, and INTERFACE_SPEC updated.
    [endian.h, ground_radio.c, main.c, max_m10m.c, max_m10m.h, radio_manager.c, test_telemetry_framing.c]
2026-04-09 Fix attitude/FSM issues from flight test, add raw-sensor HIL system
    Flight test post-mortem fixes:
    - Fix check_antenna_up() to use body Y axis (nose) not Z, for Z-up frame
    - Fix compute_vert_accel() sign for Z-up nav frame
    - Defer att.launched from 30s cal mark to PAD→BOOST FSM transition
    - Remove internal launch detection in casper_attitude.c (accel>3g trigger)
    - Replace running-average gyro bias with stationarity-gated EMA (τ=5s)
    - Increase Mahony Kp_grav to 10.0, Ki to 0.1 for robust pad convergence
    Raw-sensor HIL simulation system (all #ifdef HIL_MODE gated):
    - New 0xD3 packet: injects accel/gyro/baro/mag at converted-float level
    - Event-driven flight loop: one full pipeline iteratio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
    [casper_attitude.c, cmd_router.c, flight_loop.c, fsm_util.c, fsm_util.h, hil_raw_handler.c, hil_raw_handler.h, main.c]
2026-04-28 Add EKF16 symbolic dev, HIL sender, and hse_test scaffolding
    - New Matlab Code/EKF Dev/ with EKF_Symbolic_Dev.m and EKF16Verify.m
    - Reorganize sensor characterization scripts into Matlab Code/sensorcal/
    - Add tools/hil_sender.py for hardware-in-the-loop testing
    - Add Software/App/hse_test/ scaffolding
    - Add MAX-M10M integration manual under Hardware/
    - Ignore *.zip archives
    [BARO_HI.CSV, BARO_LO.CSV, BARO_MD.CSV, MAG_CAL.CSV, MAG_Cal_STAT.CSV, MAG_VAL.CSV, SimulinkDataFile.csv]
2026-04-28 Add branch model docs, PR templates, and per-file tier banners
    Documents the dev -> flight-testing -> main maturity ladder in
    BRANCHING.md and adds matching .github/PULL_REQUEST_TEMPLATE/ entries
    for each promotion path plus a hotfix variant.
    Every file under Software/App/ and main.c gets an ASCII TIER banner so
    the criticality of any file is visible the moment it is opened. Tiers
    used: SAFETY-CRITICAL, CORE-FLIGHT, TEST-HARNESS, GROUND-STATION
    (EXPERIMENTAL is reserved for dev-branch-only files such as hse_test/).
    Comment-only change. Build verified (text=67448 B, identical layout).
2026-04-28 Add CDC-triggered logger sanity bench test
    Opt-in via -DLOGGER_SANITY=1 in Software/Makefile. When enabled, replaces
    the FSM-driven flight_logger_launch/finalize lifecycle with a simple
    state machine that:
    - Waits 3s after init (LED1 1Hz blink)
    - Waits for user to type 'go<Enter>' over CDC (LED1 4Hz blink)
    - Calls flight_logger_launch, runs for 5s with live sensor data
    (LED1+2+3 solid), emits >t,hr,lr counters at 4Hz
    - Calls flight_logger_finalize, plays 3 short beeps, halts with
    all 4 LEDs blinking forever
    Test-like-we-fly: every other flight code path (cmd_router, HR/LR push,
    flight_logger_tick, summary writers, sensor reads, EKF, attitude, FSM)
    keeps running unchanged. R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
    [flight_loop.c, logger_sanity.c, logger_sanity.h, main.c]
2026-04-28 Add sector-0 write probe and clear CDC pipe under LOGGER_SANITY
    Diagnostic for the "no flights recorded" bug. Hex-dumping the flash after
    a successful sanity test showed: index region (0x00000000) all 0xFF,
    summary region (0x00001000) has SUMMARY_MAGIC. Index writes are not
    landing while summary writes are.
    Adds a one-shot sector-0 write probe at the top of logger_sanity_init:
    - Reads 16 bytes at 0x00000000
    - Writes pattern A5 5A x8
    - Reads back and compares
    - Verdicts: PASS / driver-error / silent-write (BP/WPS) / corruption
    - Prints over CDC and signals via LED patterns; halts on FAIL
    To make CDC prints actually visible, gates these CDC and LED conflicts
    under LOGGER_SANITY: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
    [flight_loop.c, logger_sanity.c, tlm_manager.c]
2026-04-28 Make sniffer encoding-tolerant + instrument flight_logger_launch
    Previous sanity test: probe passed (sector 0 writes work) but firmware
    got stuck after typing 'go'. LED1 stayed in WAIT_GO 4Hz blink, no
    further prints.
    Two fixes:
    1. CDC sniffer in usbd_cdc_if.c no longer requires \r/\n to fire on
    'go'. Some terminals (Arduino IDE Serial Monitor in 'No line ending'
    mode, etc.) send the bytes raw. Now fires the moment buffer ends
    in "go" / "GO" (any case mix). Line-end still resets the accumulator
    so partial gibberish doesn't accumulate into eventual false matches.
    2. Breadcrumb prints in flight_logger_launch() under LOGGER_SANITY:
    [FL] launch entry
    [FL] log_stream_laun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
    [flight_logger.c, logger_sanity.c]
2026-04-28 Probe erases sector 0 first; WAIT_GO waits for cal_done
    Last run revealed two issues:
    1. Probe verdict was inconclusive because sector 0 already had the A5 5A
    pattern from the previous run. Writing the same bytes onto matching
    bits is a no-op regardless of whether the chip actually accepts the
    write — verdict said PASS but proved nothing.
    2. HR=0 throughout the 5s logging window because flight_loop's
    flight_logger_push_hr() lives inside the cal_done==true branch
    (calibration takes 30s after boot). User typed 'go' too early.
    Fixes:
    - Probe now calls w25q512jv_erase_sector(0x00000000) before the
    read/write/read sequence. Reports erase_sector return code. Pre-state
    is n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
    [flight_loop.c, flight_loop.h, logger_sanity.c]
2026-04-28 Probe re-runs log_index_init after cleanup erase
    Previous run wrote a real flight entry but the decoder couldn't find
    it. Root cause:
    - flight_logger_init() at boot scanned a polluted index sector (probe
    pattern from previous session interpreted as a flight) and set
    flight_count > 0, plus stale hr_next_addr / lr_next_addr /
    adxl_next_addr.
    - Probe (this session) erased + rewrote sector 0, then erased again
    in cleanup. The in-RAM index state was still stale.
    - log_index_start_flight() wrote at FLASH_INDEX_BASE + flight_count*32,
    landing at slot 1 (offset 0x40). Decoder scans from slot 0, parses
    leftover probe pattern as flight 0x5AA5, breaks at first 0xFF slot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
2026-04-29 Strip [FL] diagnostic instrumentation; lock MSC read-only; fix decoder
    Cleanup commit after the logger debug pivot succeeded. The CDC dump path
    (MSG_ID_DUMP_FLASH) was already fully implemented end-to-end — the
    "no flights recorded" symptom was Windows USB MSC enumeration writing
    to sector 0 despite our IsWriteProtected=1 declaration.
    Changes:
    - flight_logger.c: remove fl_dbg / fl_dbg_hex / fl_dump_sector0 /
    fl_dump_stream helpers and all [FL] prints from flight_logger_launch
    and flight_logger_finalize. Spin-wait on w25q512jv_is_idle is back to
    the original simple form (the 3000ms timeout was a diagnostic safety
    net; the bug was elsewhere). Net -1696 bytes text.
    - usbd_msc_stora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
    [casper_decode.py, flight_logger.c, logger_sanity.c]
2026-04-29 Phase C: Hamming O(1), EXTI re-enable, IMU watchdog 1ms, cycle probes
    Three CORE-FLIGHT perf/correctness fixes plus a LOGGER_SANITY-gated
    profiling harness.
    CORE-FLIGHT fixes (always active, even without LOGGER_SANITY):
    * hamming.c: data_bit_to_pos() was an O(n) linear scan run inside the
    O(n) bit loop in hamming_encode/decode. For 60-byte HR records (480
    data bits) that was ~115k inner iterations = ~4 ms per encode at
    432 MHz - dominating the IMU servicing path. Replaced with a 512-entry
    lookup table populated lazily on first call. Encoder drops from ~4 ms
    to ~5 us (~800x). HR-record build per IMU sample drops from ~628 us
    to ~13 us. IMU servicing total drops from 38.7% to 7.1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
    [cycle_probe.c, cycle_probe.h, flight_logger.c, flight_logger.h, flight_loop.c, hamming.c, logger_sanity.c, main.c]
2026-04-29 Adaptive dt for attitude + EKF estimators (always-on DWT)
    CORE-FLIGHT correctness fix.
    The estimators were receiving a hardcoded EKF_DT = 0.0012f (=1/833) every
    call, but the actual time between IMU services on real hardware is closer
    to 1/736 = 1.36 ms (and varies further with radio TX, USB activity, etc).
    Feeding a constant dt that's 13% under-true means:
    - casper_att_update integrates gyro at 13% slow scale, accumulating
    ~6 deg of attitude error over 60 s of typical flight body rates.
    - casper_ekf_predict propagates velocity from accel and position from
    velocity each with a 13% scaled dt, accumulating ~13% position
    error scaled with flight time.
    Both errors are systemat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
    [flight_loop.c, main.c]
2026-04-29 DEV_UPDATE Rev 7: data logger debug + estimator timing correction
    Documents the Phase C investigation and all five layered issues:
    1. Windows USB MSC was wiping sector 0 on every mount, despite our
    IsWriteProtected=1 declaration. Fix: STORAGE_Write returns -1.
    2. Pivot to in-firmware MSG_ID_DUMP_FLASH CDC dump as the canonical
    read-back path; bypasses Windows entirely.
    3. IMU EXTI was disabled because of stale-pending interrupts from
    SX1276 DIO4/DIO5; re-enabled cleanly with HAL_GPIO_DeInit on
    PB12/PB13 and tightened watchdog to 1 ms.
    4. Hamming SECDED encoder was O(n^2); precomputed lookup table makes
    it O(1). hr_push went 628 us -> 13 us (~48x speedup).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
2026-04-30 Flight-prep A: kill LOGGER_SANITY/GPS_TEST, gate sx1276 dbg + ASCII plotter, OPT=-O2
    - Makefile: DEBUG=0, OPT=-O2 (was DEBUG=1, -Og)
    - Makefile: comment out LOGGER_SANITY=1 (was active, causes bench-only CDC spam)
    - Makefile: remove -DGPS_TEST from C_DEFS (calibration mode, not for flight)
    - Makefile: add 'bench' convenience target (TEST_MODE=2 + FLIGHT_ASCII_PLOT=1, build/Bench/)
    - sx1276.c: gate sx1276_dbg() function + all call sites behind #ifdef DEBUG_SX1276_INIT
    (saves ~80ms HAL_Delay stall + CDC ASCII pollution at boot)
    - flight_loop.c: replace #ifndef LOGGER_SANITY guard on ASCII plotter with
    #ifdef FLIGHT_ASCII_PLOT (flight build: plotter off; bench: define to enable)
    - flight_lo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
    [flight_loop.c, sx1276.c]
2026-04-30 Flight-prep E: logger erase-ahead during DRAIN, IMU dead-man, mag retval, adxl_end_addr, batt voltage via CONT4
2026-04-30 Flight-prep C: pyro test-mode-only fire, IWDG 500ms, fault->IWDG reset
    pyro_manager.c: pyro_mgr_fire() now requires test_mode unconditionally
    (removes PAD+test_mode OR-gate; CAC path is test-mode-only per policy).
    pyro_mgr_auto_fire() unchanged — no test_mode check, fires in flight.
    flight_fsm.c: transition_to() wraps pyro_mgr_auto_arm_flight() with
    !s_bench_mode guard — bench state commands no longer auto-arm pyros.
    IWDG: No HAL IWDG driver existed in the repo; added minimal
    stm32h7xx_hal_iwdg.{h,c} (Init + Refresh via direct register writes).
    Enabled HAL_IWDG_MODULE_ENABLED in hal_conf.h, added source to Makefile.
    hiwdg1 handle in main.c PV / declared extern in app_globals.h.
    MX_IWDG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
    [app_globals.h, flight_fsm.c, flight_loop.c, main.c, pyro_manager.c, pyro_manager.h]
2026-04-30 Flight-prep C2: kick IWDG inside flash-dump CDC waits
    flash_dump_over_cdc has a 5s ACK timeout per chunk and a USBD_BUSY
    spin in cdc_send_blocking. Both exceed the 500ms IWDG window and
    would cause the board to reset mid-dump if the host is slow.
    Refresh IWDG inside both wait loops so post-flight data extraction
    remains reliable under any host pacing.
    [flight_loop.c]
2026-05-01 Flight-prep G: bench harness terminator-less + boot banner + heartbeat
    Symptom: typed "selftest" / "simulate-apogee" produced no response on
    the bench build. Root cause: many serial UIs do not append CR/LF to
    sent strings, so bench_cmd_buf accumulated bytes that never reached
    bench_dispatch().
    - One-shot "[BENCH] READY" banner on first bench_process_cdc call so
    the operator sees bench mode is running.
    - 250 ms idle-dispatch: if buffer is non-empty and no new bytes have
    arrived for 250 ms, treat it as a complete command and dispatch.
    Terminators still work as before.
    - 5 s "[BENCH] heartbeat" so the loop is visibly alive between
    commands.
    Build: bench target clean, 77,612 B t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
    [flight_loop.c]
2026-05-01 Flight-prep H: bench harness + selftest fixes from on-hardware run
    Five issues found running bench commands on the board:
    1. selftest output truncated to 2 of 7 lines.
    Cause: bench_send fired CDC_Transmit_FS without waiting for prior
    TX to drain, so back-to-back lines returned USBD_BUSY and were
    silently dropped.
    Fix: bench_send now spins on USBD_BUSY (with IWDG kick) up to 50ms.
    2. selftest test 2 (baro PROM) FAIL on a working sensor.
    Cause: checked baro.prom[0] != 0, but C0 is a manufacturer/factory
    word that is legitimately 0 on many MS5611 parts. Real calibration
    coefficients are C1..C6 (prom[1..6]).
    Fix: pass if any of C1..C6 is non-zero; report C1 as detail.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
    [flight_loop.c, self_test.c]
2026-05-01 Flight-prep I: fix IWDG init order + cfg_manager default hash
    IWDG never started — selftest reset diagnostic was a no-op.
    Cause: HAL_IWDG_Init wrote PR/RLR before sending the start key
    (0xCCCC). Per RM0433 §50.4.5, PR/RLR reset when the watchdog starts,
    so the configured prescaler/reload were lost. Worse, LSI is not
    running until 0xCCCC is written, so the SR-sync wait timed out and
    the function returned HAL_TIMEOUT *before* ever writing the start
    key. Watchdog was never enabled in any build.
    Fix: send start key first, then unlock, then PR/RLR, then wait for
    SR sync, then 0xAAAA refresh.
    cfg_get_active_hash() returned 0 on a fresh boot, failing selftest 6.
    Cause: cfg_manager_init zeroed s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
    [cfg_manager.c]
2026-05-01 Flight-prep J: refresh IWDG inside W25Q wait_busy loop
    Selftest 5 (flash R/W) flipped from PASS to FAIL once IWDG started
    running for real. Cause: w25q_wait_busy is a blocking poll loop with
    timeout up to 400 ms (W25Q_TIMEOUT_SECTOR_ERASE). With IWDG at 500 ms
    and any other work in the same tick, the wait can exceed the window
    and either the IWDG fires mid-erase or wait_busy itself returns
    W25Q_TIMEOUT once the watchdog has reset things into a half state.
    Fix: HAL_IWDG_Refresh inside the wait loop, on every poll iteration.
    Same pattern used by flash_dump_over_cdc (commit C2). All flash ops
    go through this wait, so this single change covers logger writes,
    FATFS, MSC, and the bench self-test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
    [w25q512jv.c]
2026-05-01 Flight-prep K: stop FATFS f_mkfs from corrupting flight index
    Root cause of "logger-finalize-force shows 0x00000000": FATFS uses
    sector 0 (flash address 0) which is the same as FLASH_INDEX_BASE.
    On a bench boot with no existing filesystem, f_mkfs writes a FAT
    boot sector starting at flash address 0, overwriting the flight
    index region. log_index_init then reads 113 zeroed entries (each
    flight_id=0x0000 is treated as a valid entry, not the empty marker
    0xFFFF), computes garbage hr/lr/adxl_next addresses, and
    log_stream_init initializes streams with flash_base=0.
    The flight build (TEST_MODE=1) already excluded the FATFS init.
    The bench build (TEST_MODE=2) was running it.
    Fix:
    - main.c: tight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
    [flight_loop.c, main.c]
2026-05-01 Flight-prep L: deconflict flash layout — FATFS in own 4 MB partition
    The real fix for the FATFS-corrupts-flight-index bug instead of the
    flash-wipe bodge from K. Flash is now partitioned:
    0x00000000 .. 0x03C00000 Flight log (60 MB) — raw NOR
    0x03C00000 .. 0x04000000 FATFS ( 4 MB)
    user_diskio.c and usbd_msc_storage_if.c both offset their sector
    accesses by FATFS_FLASH_BASE (0x03C00000), so sector 0 of either
    view maps to the start of the FATFS partition, not address 0.
    f_mkfs and FATFS writes can no longer reach the flight index.
    MSC drive is now 4 MB instead of 64 MB — exposes the FATFS partition
    only. Flight data extraction continues to use the CDC dump path
    (unchang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
    [log_types.h, main.c]
2026-05-01 Flight-prep M: manual FSM step mode — live sensors + ASCII plotter + integrated logging
    Adds `make manual` target that builds TEST_MODE=1 + MANUAL_FSM_STEP +
    FLIGHT_ASCII_PLOT=1. The MANUAL_FSM_STEP define lifts the bench-text
    command dispatch into the live flight loop, auto-enables s_bench_mode
    on boot to freeze autonomous FSM transitions, and gates out the radio
    CAC processor (cmd_router_process) so bench commands don't fight for
    CDC bytes. LANDED->finalize grace bumped 5s -> 10s for both flight
    and manual builds.
    The full nav stack (sensors, EKF, attitude, ASCII plotter at 10 Hz,
    flight_logger lifecycle) runs identically to the flight build; the
    only difference is that PAD->BOOST->...-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
2026-05-01 Flight-prep N: add pitch/yaw/tilt to post-PAD ASCII plotter line
    The post-PAD plotter line was sparse (alt, vel, vaccel, fsm, t) so
    orientation was only graphable in PAD. Add pitch/yaw/tilt from the
    existing diag_* variables so the operator can watch attitude through
    boost/coast/apogee/main/landed too.
    Format is now:
    >alt:%.1f,vel:%.1f,vaccel:%.2f,pitch:%.1f,yaw:%.1f,tilt:%.1f,fsm:%u,t:%.1f
    Applies to flight, manual, and bench builds (any with FLIGHT_ASCII_PLOT).
    Builds clean:
    flight: 92,320 B text (unchanged)
    manual: 97,096 B text (+72)
2026-05-01 Flight-prep O: add roll to post-PAD ASCII plotter line
    Operator wanted spin-about-nose visibility through the flight states.
    Per casper_quat.h convention euler[1] is body Y rotation (roll/spin
    about nose), so compute euler from the quaternion in the post-PAD
    plotter branch and add roll alongside the existing pitch/yaw/tilt.
    >alt:%.1f,vel:%.1f,vaccel:%.2f,pitch:%.1f,yaw:%.1f,roll:%.1f,tilt:%.1f,fsm:%u,t:%.1f
    manual: 97,144 B text (+48)
    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
2026-05-01 Flight-prep P: call bench_process_cdc unconditionally in manual mode
    Symptom: typing FSM state commands in the manual build did nothing —
    no transition, no beep, no LED change — even though the heartbeat
    appeared to be working.
    Root cause: in MANUAL_FSM_STEP the dispatch was gated behind
    `if (cdc_ring_available() > 0)`. bench_process_cdc has two time-based
    behaviours that REQUIRE it to be called continuously to function:
    - 250 ms idle-dispatch (terminator-tolerant — needed because some
    serial UIs do not append CR/LF on send)
    - 5 s heartbeat
    Both are time-driven and only advance when the function runs. With
    the gate, after the user typed `boost` (5 bytes, no newline), the
    rin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
2026-05-01 Flight-prep Q: flight_logger_launch resets finalized flag from prior session
    Critical correctness bug surfaced by manual bench testing. Symptom:
    after running logger-finalize-force, the next manual PAD->BOOST
    appeared to fire (FSM transitioned, ASCII plotter switched to flight
    format) but no records were ever written to flash and the 10s LANDED
    grace produced no finalize beep.
    Root cause: flight_logger_launch sets log->launched = true but never
    resets log->finalized. Once any prior call to flight_logger_finalize
    sets finalized=true, all subsequent sessions in the same power cycle
    silently fail because:
    - flight_logger_tick early-returns on (log->finalized) at line 181
    so no QSPI write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
    [flight_logger.c]
2026-05-01 Flight-prep R: fix 600s finalize watchdog firing immediately on launch
    Symptom: bench session heard 5-beep (finalize pattern) on PAD->BOOST
    instead of 2-beep (launch pattern), and no beep on LANDED. The
    launch-finalize-watchdog at the bottom of the FSM transition block
    was firing the same tick as the launch.
    Root cause: timing skew between two HAL_GetTick() reads in the same
    loop iteration.
    1. Top of flight_loop_tick caches `now = HAL_GetTick()`
    2. flight_logger_launch is called — internally does QSPI idle-spin
    + log_index_start_flight (writes flight entry to flash). Several
    ms of work.
    3. flight_logger_launch sets summary.launch_tick = HAL_GetTick(),
    which is now ~3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
    [flight_loop.c]
2026-05-01 Flight-prep S: fix all-zero LSM6 + ADXL columns in HR records
    Symptom: decoded HR CSV had accel_x..adxl_z all literally zero across
    every record, even though the EKF + attitude estimator were running
    on real IMU data.
    Two independent bugs:
    1. lsm6dso32_read() (the function the flight loop calls every IMU
    service) computed the raw int16 register values into local
    variables ax/ay/az/gx/gy/gz, used them to derive accel_g[] and
    gyro_dps[] floats, then discarded them. The HR record packer
    reads imu->raw_accel[] / imu->raw_gyro[] though, so HR records
    silently snapshotted whatever was in those fields at boot — zero.
    A separate lsm6dso32_read_raw() does populate the raw fields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
    [flight_loop.c, lsm6dso32.c]
2026-05-01 Flight-prep T: drain pipeline — only erase when runway is low
    Symptom: in the previous bench run the HR log had a 44 second gap
    spanning COAST/APOGEE/MAIN. Summary said 5059 records written but
    only 1200 made it to flash. Drops counter showed 23764. Drain rate
    was ~33 pages/s vs ~240 pages/s expected.
    Root cause: the erase-ahead in flight_logger_tick was triggering on
    every iteration where ANY stream had `erased_up_to < flash_end`. For
    a flight, this is always true (pools are 16-47 MB), so the tick was
    issuing an IT erase, taking the QSPI bus busy for ~50 ms, returning,
    issuing another erase, etc. — page writes only ran on the rare ticks
    where all three pools were fully erased to their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
2026-05-01 Flight-prep U: quat smallest-three sqrt(2) scaling + decode to roll/pitch/yaw
    Two changes:
    1. Firmware quat pack: scale the int12 components by 2048*sqrt(2) ≈
    2896.309 instead of 4096. The previous scale clamped any rotation
    beyond ~60° because the smallest-three components can be as large
    as 1/sqrt(2) ≈ 0.7071, which 0.7071*4096=2896 exceeded the int12
    max of 2047. With the corrected scale, the full smallest-three
    range maps cleanly to [-2048, +2047] and rotations up to 180°
    round-trip with <0.0004 error in any component.
    Affects: HR record quat field, radio FC_MSG_FAST quat field. The
    ground station does not decode the quat itself so the only
    downstream e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
    [casper_decode.py]
2026-05-01 Flight-prep V: wire ADXL372 800 Hz FIFO drain to dedicated log stream
    Previous bench dump showed ADXL records=0 on every flight. Two related
    gaps:
    - adxl372_fifo_init was never called, so the device stayed in
    single-sample mode (400 Hz) instead of 800 Hz FIFO stream.
    - flight_logger_push_adxl was defined but had no caller, so the
    dedicated 16 MB ADXL pool received no records.
    - PAD->BOOST handler now calls adxl372_fifo_init(&high_g,
    ADXL372_ODR_800HZ) instead of adxl372_enter_measurement, putting
    the device into the FIFO stream mode set up by the driver
    (FIFO_STREAM | FIFO_FORMAT_XYZ, 512-entry watermark).
    - Each IMU service iteration (~833 Hz) the post-laun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
    [flight_loop.c]
2026-05-01 Flight-prep W: strip bench debug instrumentation + DEV_UPDATE Rev 8 wrap-up
    Tidies the bench harness for the flight-ready merge and brings
    DEV_UPDATE.md up to date with the full flight-prep batch list (M
    through V plus this batch).
    flight_loop.c removals:
    - logger-init-test command (was a one-shot diagnostic that
    pinpointed the FATFS-corrupting-flight-index bug; no longer
    needed now that K + L deconflict the partitions)
    - PRE/POST struct dump from logger-finalize-force (single FINALIZE
    line is enough)
    - landed grace started / grace expired / finalize returned
    bench_send triplet (used to find the Batch R underflow; the
    code path is now correct and the prints would j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
    [flight_loop.c]
2026-05-01 Track CubeMX config, ST middlewares, and startup assembly
    These are required for a from-scratch build but were previously ignored.
    Including them lets the repo build cleanly on any machine without
    re-running CubeMX or hand-copying middleware sources.
2026-07-02 fix(nav): tilt-from-vertical euler + disable integral windup
    Cherry-picks the hardware-validated attitude fixes onto main (launch branch),
    adapted to main's structure (no port layer). Display/telemetry only — the EKF,
    quaternion math, and all of main's flight-prep fixes are untouched.
    - casper_quat_to_euler: reworked to a tilt-from-vertical convention (roll-innermost
    Z-X-Y). Near-vertical -> pitch/yaw ~0; nose-spin moves only roll (full +/-180);
    pitch/yaw report true tilt-from-vertical, invariant under spin/heading. Same
    euler[] layout (yaw,roll,pitch) so callers/ASCII plotter are unchanged. Fixes the
    old asin-on-nose-spin gimbal behaviour and the pitch=73-for-16deg-tilt coupling.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
    [casper_attitude.c, casper_quat.c, main.c, test_casper_quat.c]
2026-07-02 feat(ground): GS->MC COBS relay (0x10) onto main, gated by GS_OUTPUT=COBS
    Ports the ground-station 0x10 GS_MSG_TELEM relay from the port-layer line onto
    main's structure (HAL-based, no port seam). Purely additive behind a new build
    flag — the default ASCII ground build is byte-identical.
    - quat_pack: add quat_unpack_smallest_three (shares QUAT_PACK_INT12_SCALE=2896.309
    with the packer -> exact round-trip; host test |dot|=1.0 incl. tilt+spin).
    - tlm_types: add MSG_ID_GS_TELEM 0x10, SIZE_GS_MSG_TELEM 39 (byte-counted layout).
    - Makefile: GS_OUTPUT ?= ASCII; GS_OUTPUT=COBS -> -DGS_OUTPUT_COBS (GROUND); pulls
    casper_quat.c into the COBS ground build for the euler decode.
    - ground_radio: o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
2026-07-15 Groundstation: SX1276 ping-pong responder for Casper-3 two-way link test
    ground_radio_on_rx() now detects a 6-byte PING packet
    ([0xCA][0x53][0x01][seq:2][sum8]) and immediately replies with a PONG
    (type 0x02, same seq) via ground_radio_send_cmd(); check_tx_done() returns the
    radio to RX-continuous afterwards. Handled before the telemetry CRC-32 path (the
    ping-pong packet carries no CRC-32; the LoRa hardware CRC already protects it),
    so the normal telemetry decode is untouched. Prints ">GS PING n -> PONG rssi ..
    snr .." in ASCII mode. Air interface already matches Casper-3 stage 8
    (868 MHz, SF7, BW250, CR4/5, preamble 8, private sync 0x12 == SX126x 0x1424).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
2026-07-15 ground: fix GS going deaf after first TX (shared DIO0 RxDone/TxDone)
    Bench two-way test: the GS answered exactly one ping then never received
    again (rx_pkt_count frozen at 1). DIO0 on the SX1276 is shared for RxDone and
    TxDone; ground_main_tick always dispatched a DIO0 edge to ground_radio_on_rx().
    After the PONG transmit, the TxDone edge was misrouted into on_rx(), which
    cleared g_radio_dio0_flag before check_tx_done() could run -> s_tx_pending stuck
    at 1, radio parked in TX, GS deaf.
    Route the DIO0 edge by TX state: while a TX is in flight, call check_tx_done()
    (re-arms RX-continuous); otherwise on_rx(). Adds ground_radio_tx_pending()
    accessor. Builds clean (BUILD_TARGET=GROUND); no new w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
    [ground_main.c, ground_radio.c, ground_radio.h]
2026-07-15 ground: poll IRQ-flags for TxDone (DIO0 is RxDone-only) — real deaf-after-TX fix
    The prior commit routed the TxDone DIO0 edge to check_tx_done(), but DIO0 is
    hard-mapped to RxDone (RegDioMapping1=0x01, bits[7:6]=00), so a TxDone NEVER
    raises DIO0. check_tx_done() waited on the DIO0 pin flag that could not arrive,
    so after the first PONG the GS stayed parked in TX with s_tx_pending stuck at 1
    and never received again (rx_pkt_count frozen at 1).
    check_tx_done() now polls the SX1276 RegIrqFlags TX_DONE bit directly over SPI
    (same technique used on the Casper-3 SX1262 side) and re-arms RX-continuous when
    the reply has gone out. Restore the unconditional check_tx_done() call every
    loop (TxDone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
    [ground_main.c, ground_radio.c]
2026-07-22 ground: GS_FEI_BEACON=1 -- 10 Hz TX beacon for the Casper-3 FEI bench
    The Casper-3 radio-testing session measures its SX1262's 32 MHz crystal
    (no TCXO) against this GS's TCXO reference: the C3 side runs an RX-only
    bench (flight/app/radio_app.c in the C3 repo) that reads the LoRa FEI of
    every received packet. This flag turns the GS into the matching beacon:
    - modem pinned to the bench config -- 868.0 MHz, SF9, BW125, CR4/5,
    preamble 8, explicit header, CRC on, sync 0x12 (= SX1262 0x1424) --
    applied after Profile A in ground_radio_init()
    - +10 dBm, not +20: desk-range bench, keep the FC front-end out of
    saturation
    - 10 Hz TX of [0xCA][0x53][0x03][seq16][sum8] -- ping-pong framing with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
2026-07-22 ground: GS_FEI_MEASURE=1 -- measure the Casper-3 FC's TX carrier error
    Role swap of the FEI bench: the C3 FC transmits +22 dBm beacons (its
    TXBCN=1 image) and this GS measures, closing the two gaps the RX-only
    bench left -- does the FC's TX carrier match the +13 ppm its own RX FEI
    implied, and does flight-level PA self-heating drag the crystal.
    Driver: sx1276_get_freq_error_hz(bw_hz) -- RegFei 0x28[3:0]:0x29:0x2A,
    20-bit signed, Ferr = raw * 2^24/Fxtal * BW[kHz]/500 (DS 6.4). Sign
    convention to be pinned empirically against the FC's known offset.
    Ground: GS_FEI_MEASURE pins the same bench modem config as the beacon
    mode (shared #if), never transmits, and short-circuits ground_radio_on_rx
    i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
    [ground_radio.c, sx1276.c, sx1276.h]
2026-08-16 ground: name the two new Casper-3 FC events, and always print the raw type
    event_name() covered 0x01-0x08 only, and the ASCII line emitted the NAME and
    never the raw type byte. So FC_EVT_PYRO_MODE (0x09) and FC_EVT_LOGIC_SHADOW
    (0x0A) both rendered as ">EVT UNK DATA:..." and were mutually
    indistinguishable -- in the DEFAULT GS_OUTPUT=ASCII build, which is what every
    bench rehearsal watches. FC_EVT_LOGIC_SHADOW is the entire data product of the
    September shadow-mode campaign.
    Adds both cases (defines mirrored into this repo's tlm_types.h, marked as
    Casper-3 FC events relayed by this groundstation) and changes the print to
    "%s(0x%02X)" so the NEXT event this build has never heard of stays
    ide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
2026-08-29 telemetry: FC_MSG_GPS carries absolute coordinates, on both sides of the link
    Matches the Casper-3 FC change (C.A.S.P.E.R.-3 ddeaac5). Bytes 1-8 of
    FC_MSG_GPS were dlat_mm/dlon_mm -- millimetres from a pad origin the
    vehicle captured on its own first valid fix and never transmitted. They
    are now the absolute lat/lon straight out of NAV-PVT, degrees x 1e-7.
    The packet is still 18 bytes, so the two encodings are indistinguishable
    on the wire: a decoder built against the old layout reads degrees as
    millimetres and says nothing. That is the whole reason this had to move
    in the same pass as the FC.
    ground_radio.c the GS's own MSG_ID_GPS decoder now prints
    LAT:%.7f LON:%.7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
    [flight_logger.c, ground_radio.c, radio_manager.c, test_telemetry_framing.c, test_tlm_pack.c, tlm_manager.c, tlm_types.h]
2026-09-05 ground: emit GS_MSG_STATUS (0x13) so Mission Control gets GS link-health data
    The ASCII heartbeat carries the GS's own profile/RSSI/SNR/pkt-count/ground
    reference, but per rule 4 (one output format per CDC) it's compiled out
    entirely under GS_OUTPUT_COBS, so Mission Control had no equivalent at all.
    Adds the binary GS_MSG_STATUS packet in that mode instead, sourced from the
    driver's raw NAV-PVT lat/lon (not the float ground_lat/lon_deg, which loses
    ~1 m of the GS's own reference position at two-digit latitudes -- those
    never round-trip through float).
    Verified against a live FC-radio-GS-COBS-MC bench run: GS_MSG_STATUS decodes
    cleanly on the MC side at 1 Hz alongside the 10 Hz GS_MSG_TELEM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
2026-09-05 ground: the GS could not follow an FC that rebooted
    The GS profile switch was one-way by design: wait for a first valid packet,
    then on GS_PROFILE_LOSS_TIMEOUT_MS of silence move A->B and never come back.
    Bench-testing FC power-cycle recovery on 2026-09-05 showed what that costs.
    Silence is equally explained by "the FC switched to Profile B for range" and
    by "the FC power-cycled and came back up on Profile A" -- and a rebooted FC
    always comes back on A, no matter how far into a flight it previously got.
    A one-way commit to B cannot tell those apart, so once the GS had moved it
    sat deaf on B with no way back short of a GS power-cycle. On a range day
    that is a dead ground station in the windo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
    [ground_radio.c, ground_radio.h]
